ben5049/component-library/project_graphics/5-port-tsn-switch 1.0.0.png

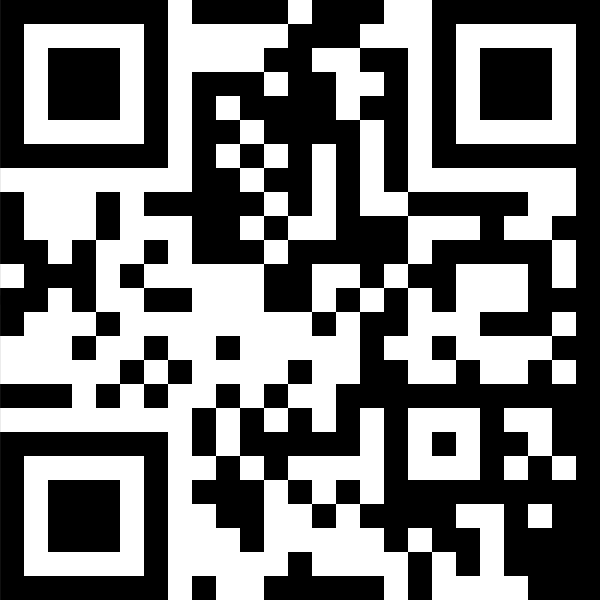
project_graphics/5-port-tsn-switch 1.0.0.png
