ben5049/component-library/project_graphics/admech.png

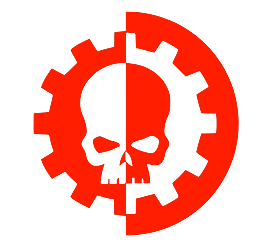
project_graphics/admech.png
