ben5049/component-library/project_graphics/red-scorpions.jpg

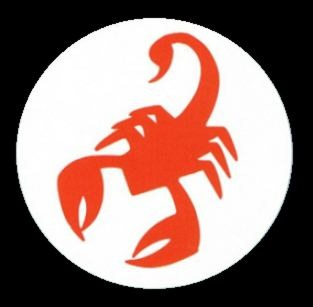
project_graphics/red-scorpions.jpg
