ben5049/component-library/project_models/f31l_8pin_asm.stp

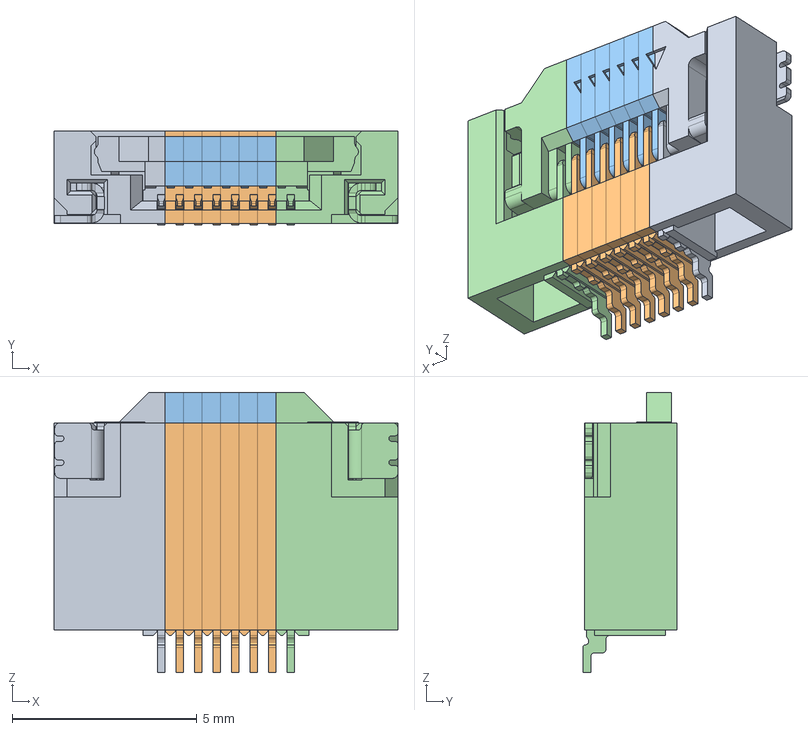
[picture p4: CAD file, 2026-02-13]
project_models/f31l_8pin_asm.stp
9.30 x 2.55 x 7.57 mm
F31L_L
F31L_M x 6
F31L_R
