ben5049/component-library/project_models/ASM330LH.stp

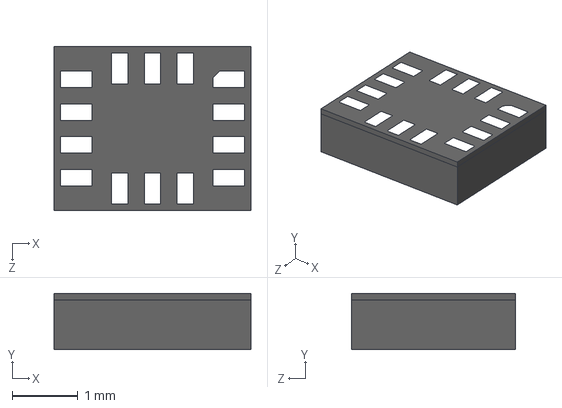
[picture p5: CAD file, 2025-05-21]
project_models/ASM330LH.stp
3.00 x 0.86 x 2.50 mm
