ben5049/component-library/project_models/switch-main-v2-bottom-shield-1.step

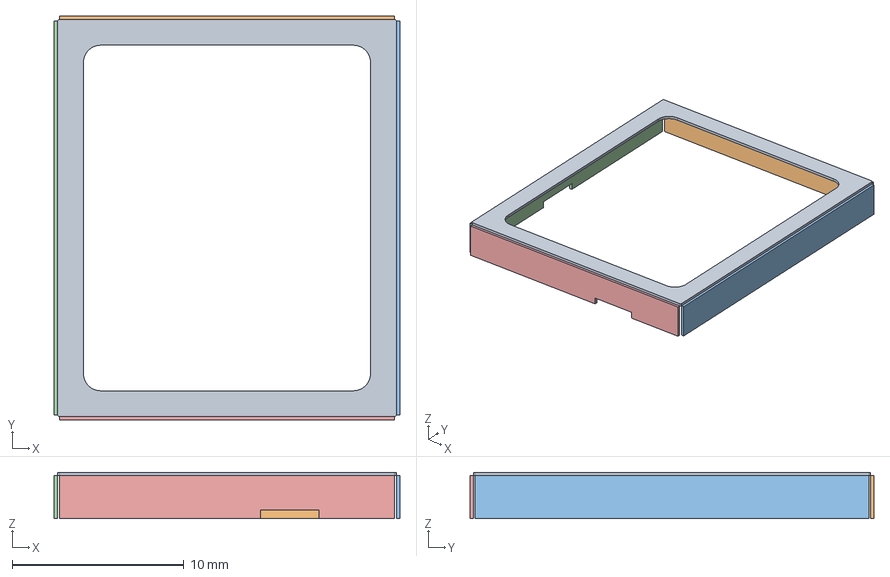
[picture p6: CAD file, 2025-05-05]
project_models/switch-main-v2-bottom-shield-1.step
20.1 x 23.5 x 2.70 mm
Frame
