ben5049/component-library/project_models/switch-main-v2-top-shield.step

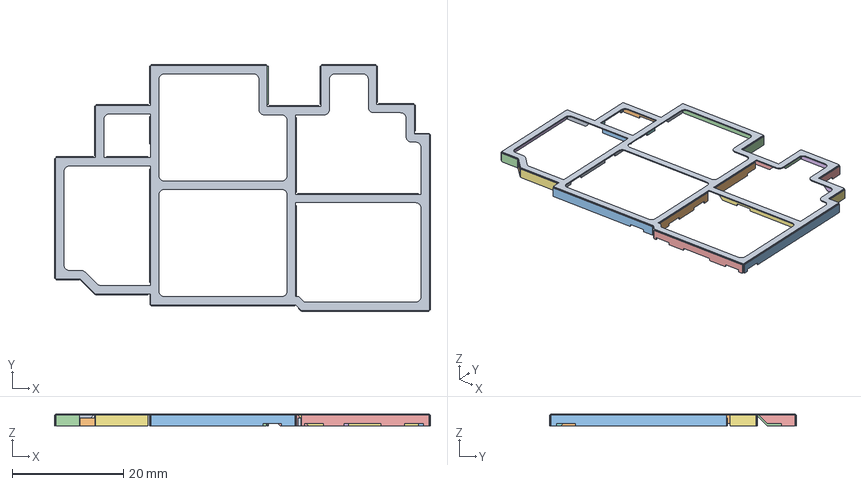
[picture p7: CAD file, 2025-05-05]
project_models/switch-main-v2-top-shield.step
67.7 x 44.5 x 2.20 mm
Frame
