ben5049/component-library/project_models/switch-main-v2-bottom-shield-2.step

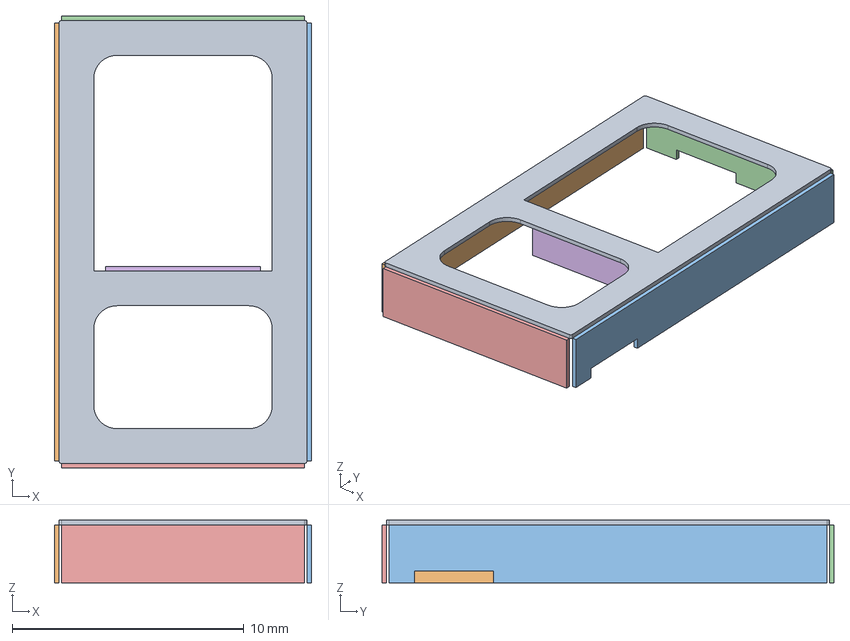
[picture p8: CAD file, 2025-05-05]
project_models/switch-main-v2-bottom-shield-2.step
11.1 x 19.5 x 2.70 mm
Frame
