ben5049/component-library/project_models/ADS7128IRTER.stp

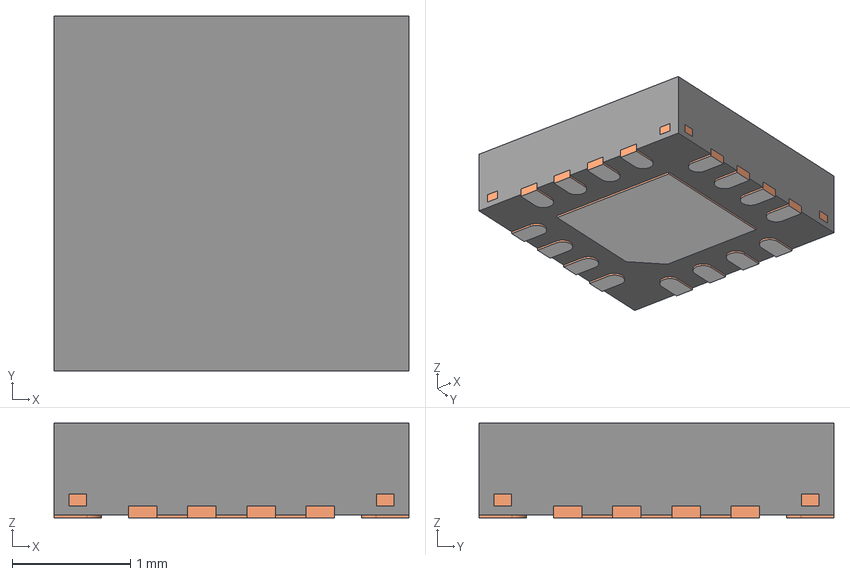
[picture p9: CAD file, 2026-04-12]
project_models/ADS7128IRTER.stp
3.00 x 3.00 x 0.8 mm
BODY-QFN
FRAME-RTE0016C
PIN1-ID
