ben5049/component-library/project_models/TMC2209.step

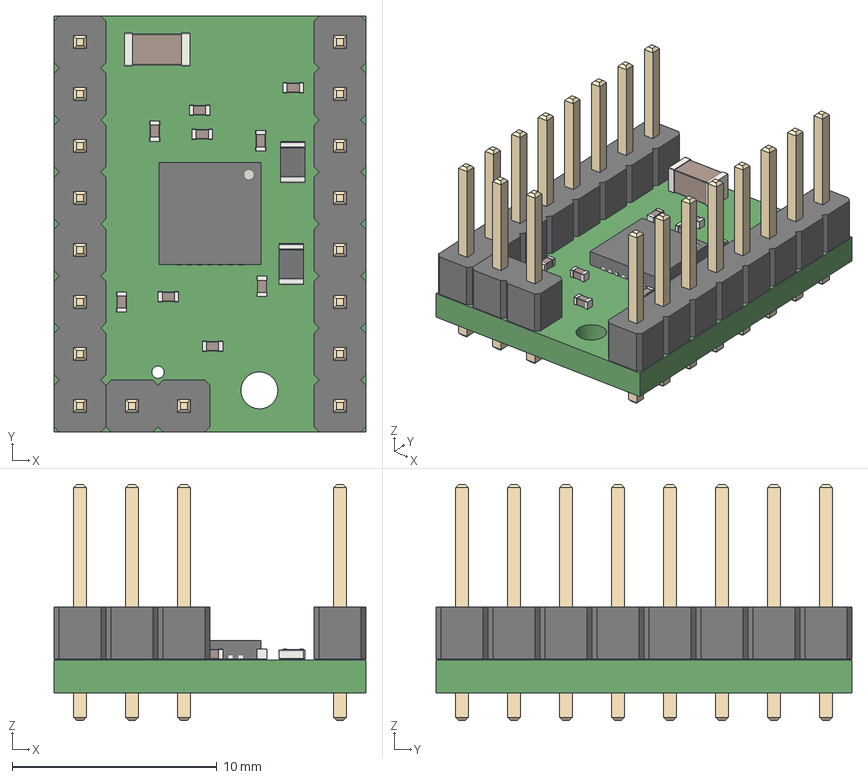
[picture p10: CAD file, 2026-04-09]
project_models/TMC2209.step
15.2 x 20.3 x 11.5 mm
