ben5049/component-library/project_models/FH12-20S-0.5SH_55_.stp

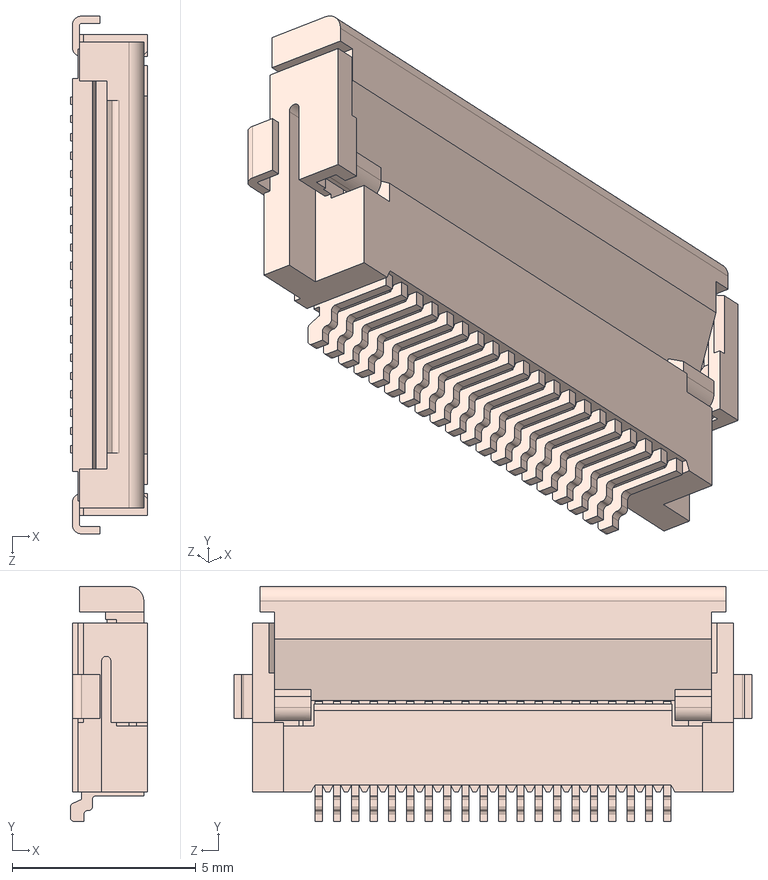
[picture p11: CAD file, 2026-04-07]
project_models/FH12-20S-0.5SH_55_.stp
2.10 x 6.40 x 14.1 mm
