ben5049/component-library/project_models/FFC3A20-05-G.stp

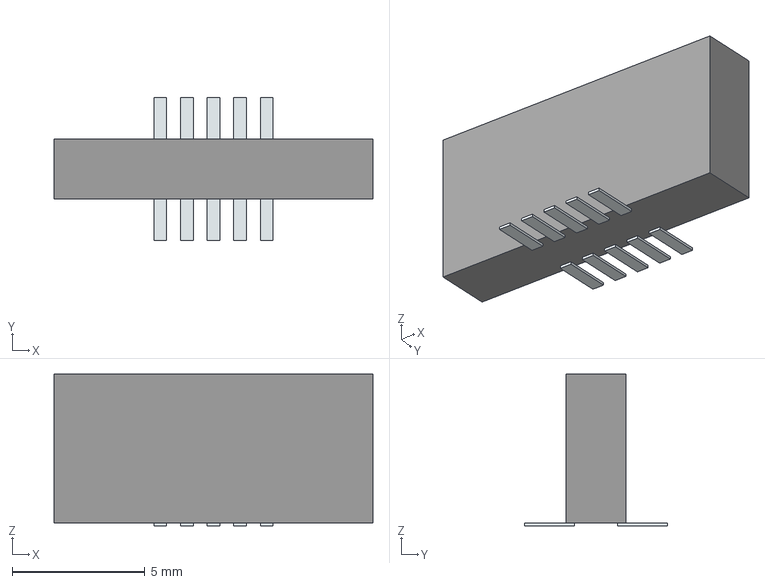
[picture p12: CAD file, 2026-04-06]
project_models/FFC3A20-05-G.stp
12.0 x 5.38 x 5.70 mm
Pins
