ben5049/component-library/project_models/NX3DV221GM,115.stp

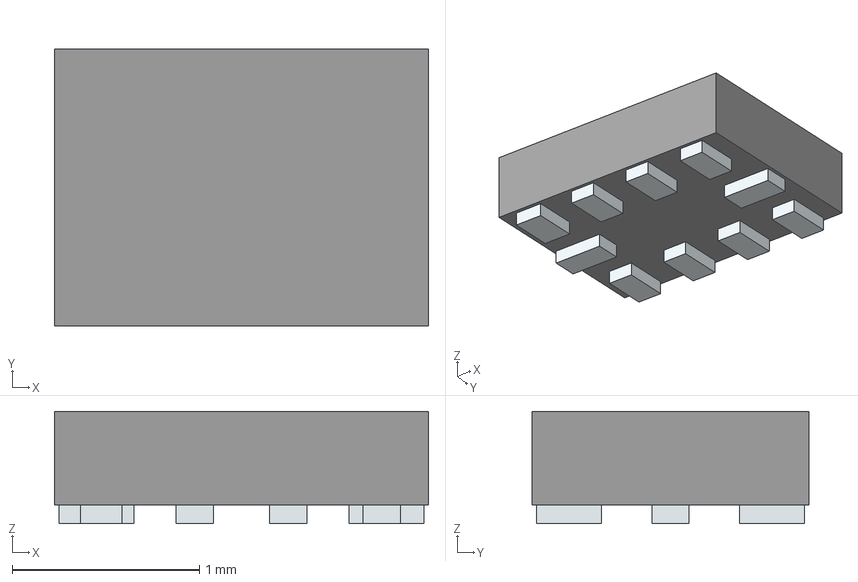
[picture p13: CAD file, 2026-04-06]
project_models/NX3DV221GM,115.stp
2.00 x 1.48 x 0.6 mm
Pins
