ben5049/component-library/project_models/AT24C64D-MAHM-E.stp

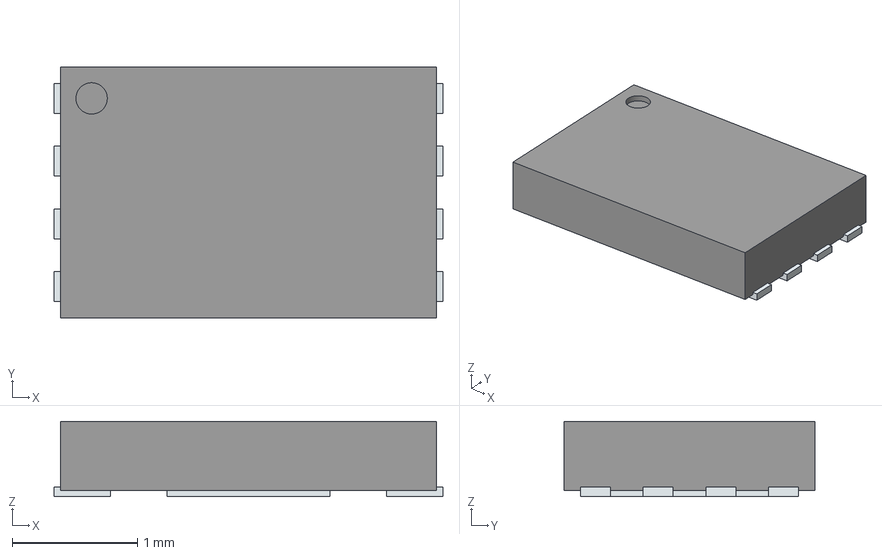
[picture p14: CAD file, 2026-04-06]
project_models/AT24C64D-MAHM-E.stp
3.10 x 2.00 x 0.6 mm
ThermalPin
PinsArrayLR
