ben5049/component-library/project_models/L_Wurth_WE-LHMI-5030.step

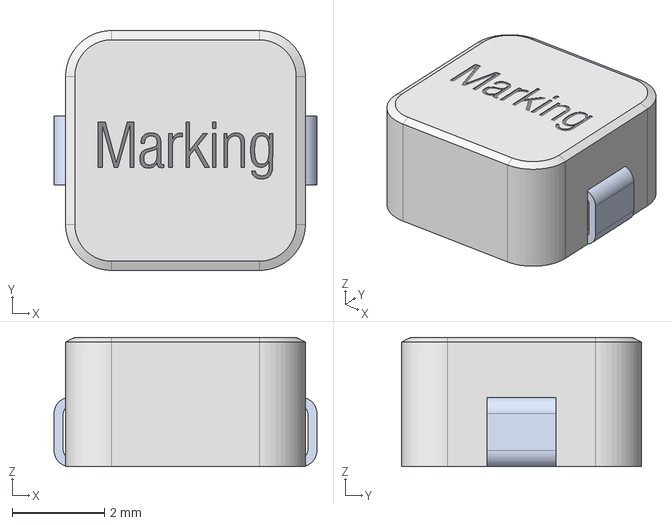
[picture p15: CAD file, 2026-04-05]
project_models/L_Wurth_WE-LHMI-5030.step
5.70 x 5.20 x 2.80 mm
