ben5049/component-library/project_models/L_Wurth_WE-LHMI-1335.step

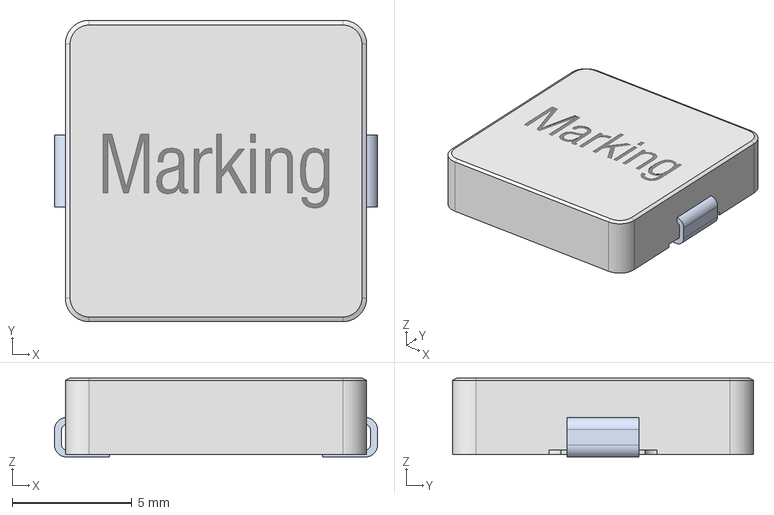
[picture p16: CAD file, 2026-04-05]
project_models/L_Wurth_WE-LHMI-1335.step
13.5 x 12.6 x 3.30 mm
