ben5049/component-library/project_models/L_Wurth_WE-LHMI-1365.step

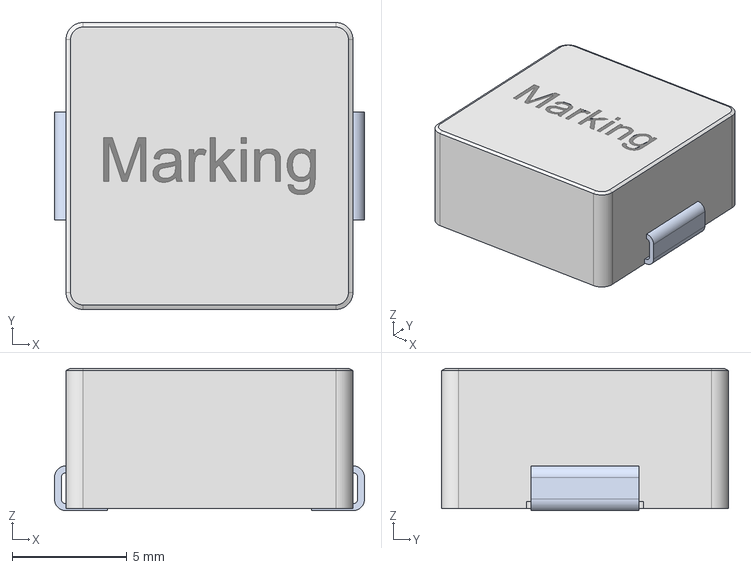
[picture p17: CAD file, 2026-04-05]
project_models/L_Wurth_WE-LHMI-1365.step
13.5 x 12.5 x 6.20 mm
