ben5049/component-library/project_models/L_Wurth_WE-LHMI-4020HT.step

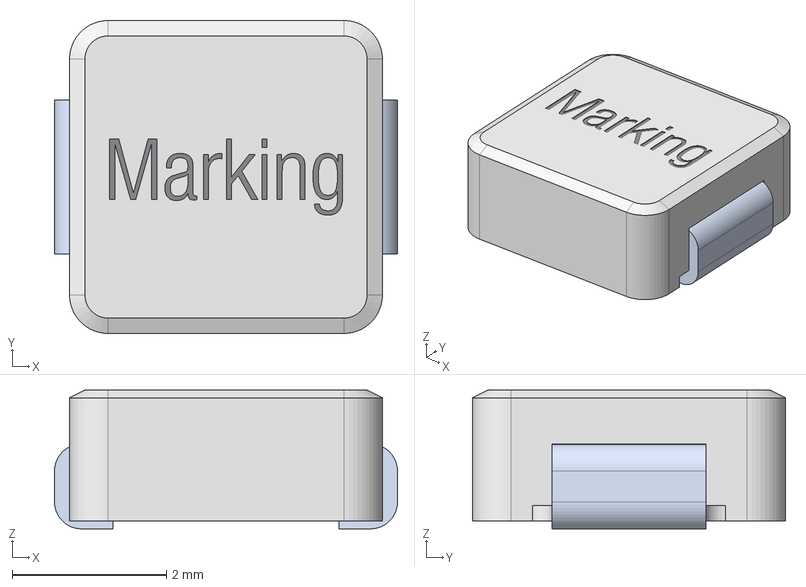
[picture p18: CAD file, 2026-04-05]
project_models/L_Wurth_WE-LHMI-4020HT.step
4.45 x 4.06 x 1.80 mm
