ben5049/component-library/project_models/L_Wurth_WE-LHMI-7050.step

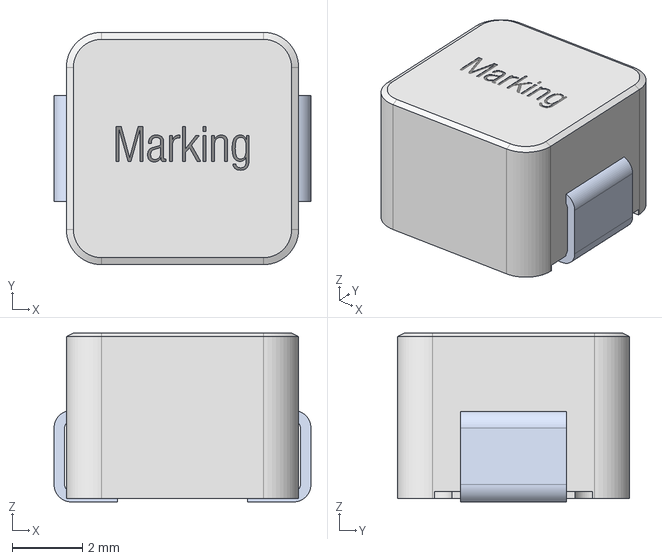
[picture p19: CAD file, 2026-04-05]
project_models/L_Wurth_WE-LHMI-7050.step
7.30 x 6.60 x 4.80 mm
