ben5049/component-library/project_models/L_Wurth_WE-LHMI-7030HT.step

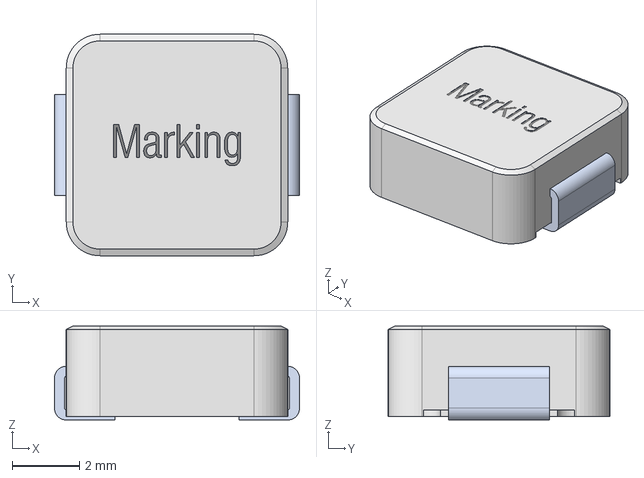
[picture p20: CAD file, 2026-04-05]
project_models/L_Wurth_WE-LHMI-7030HT.step
7.30 x 6.60 x 2.80 mm
