ben5049/component-library/project_models/L_Wurth_WE-LHMI-4012.step

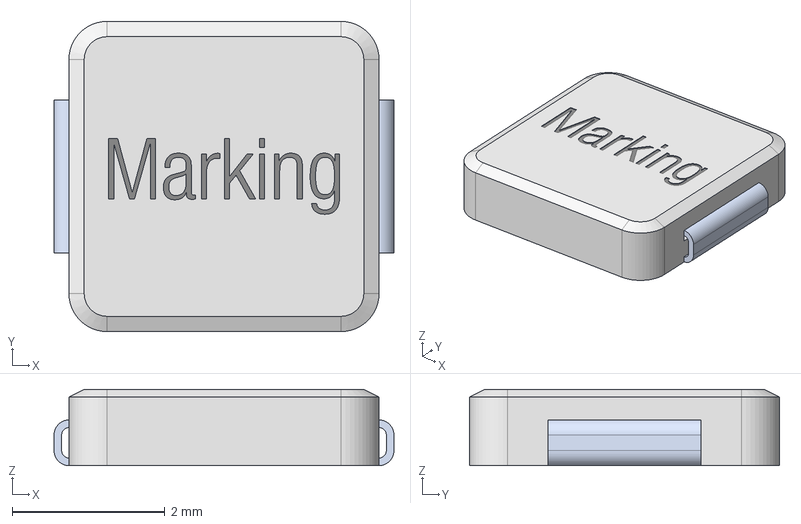
[picture p21: CAD file, 2026-04-05]
project_models/L_Wurth_WE-LHMI-4012.step
4.45 x 4.06 x 1.00 mm
