ben5049/component-library/project_models/AZV3001FZ4-7.stp

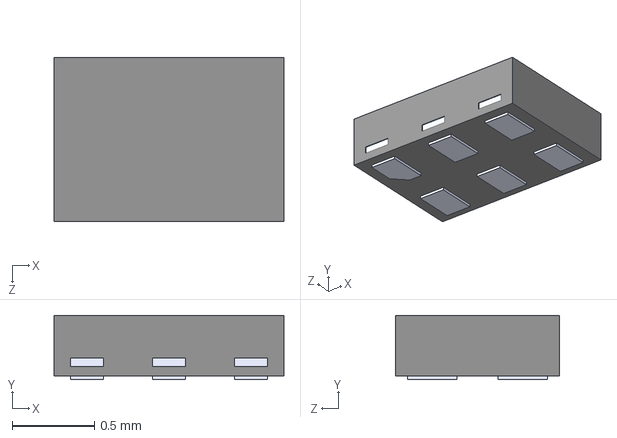
[picture p22: CAD file, 2026-04-05]
project_models/AZV3001FZ4-7.stp
1.40 x 0.39 x 1.00 mm
