ben5049/component-library/project_models/L_Wurth_WE-LHMI-8030.step

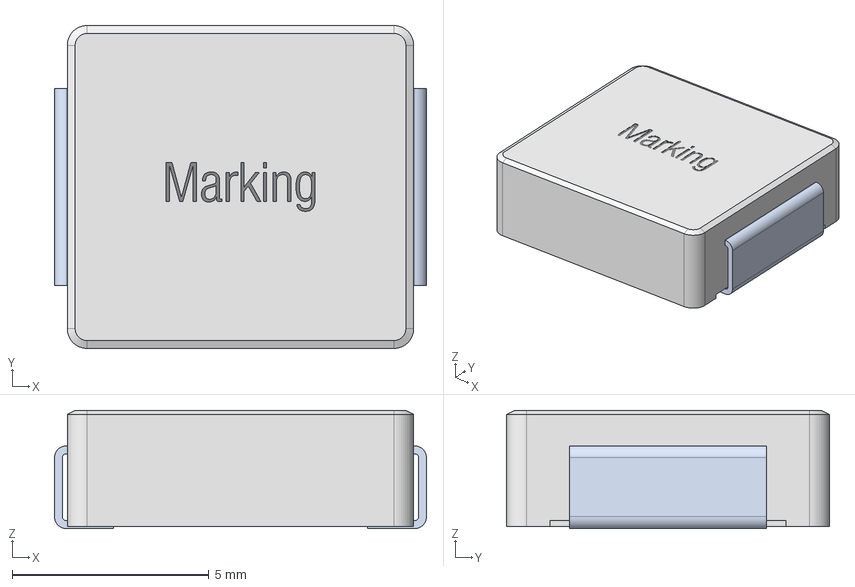
[picture p23: CAD file, 2026-04-05]
project_models/L_Wurth_WE-LHMI-8030.step
9.45 x 8.20 x 3.00 mm
