ben5049/component-library/project_models/L_Wurth_WE-LHMI-1040.step

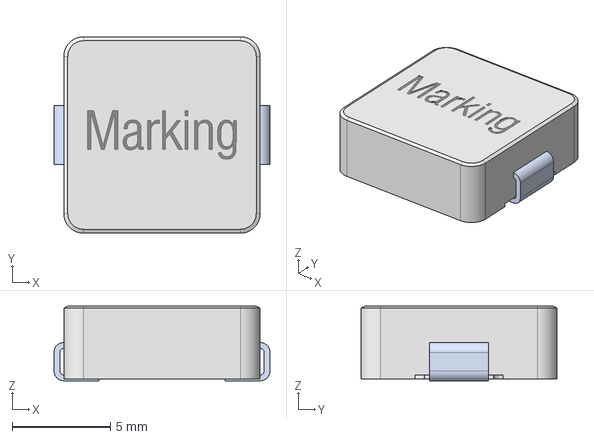
[picture p24: CAD file, 2026-04-05]
project_models/L_Wurth_WE-LHMI-1040.step
11.0 x 10.0 x 3.80 mm
