ben5049/component-library/project_models/L_Wurth_WE-LHMI-5020HT.step

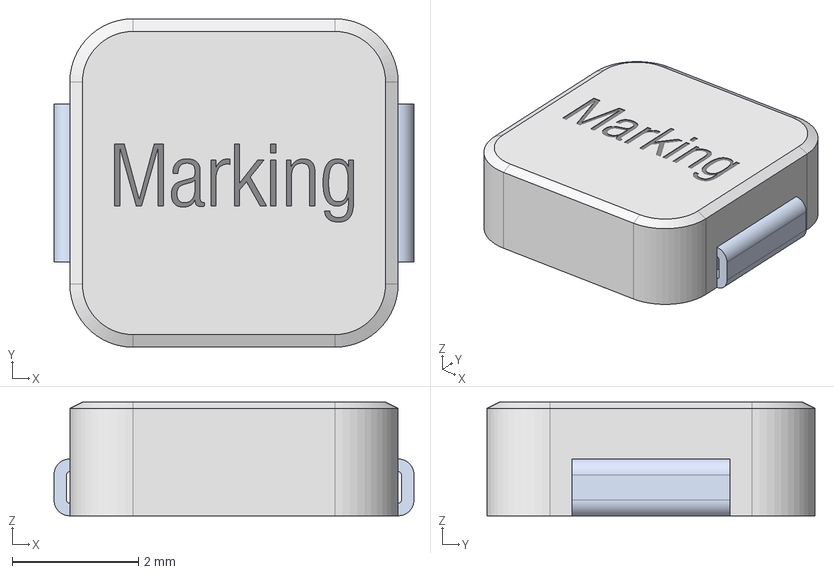
[picture p25: CAD file, 2026-04-05]
project_models/L_Wurth_WE-LHMI-5020HT.step
5.70 x 5.20 x 1.80 mm
