ben5049/component-library/project_models/L_Wurth_WE-LHMI-8040_PW5.step

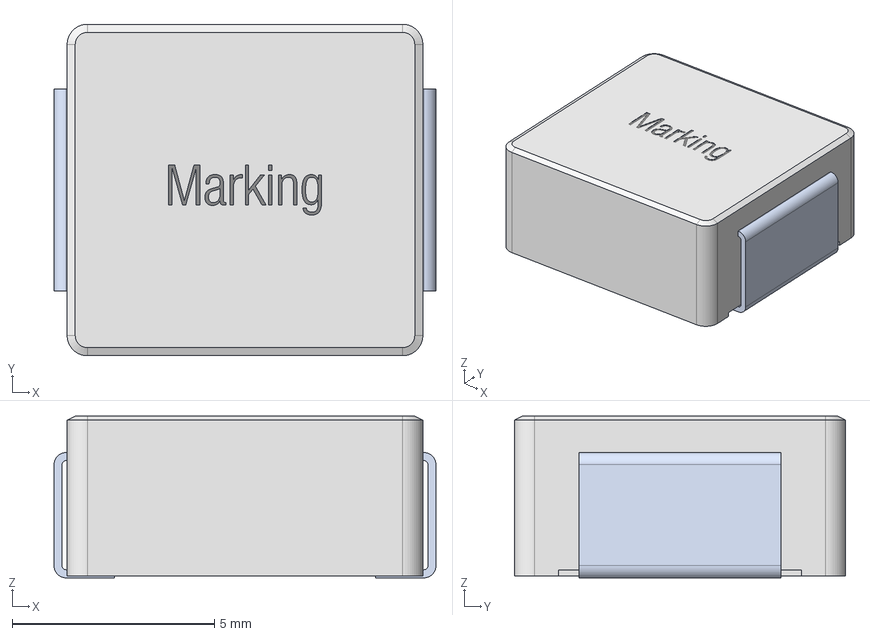
[picture p26: CAD file, 2026-04-05]
project_models/L_Wurth_WE-LHMI-8040_PW5.step
9.45 x 8.20 x 4.00 mm
