ben5049/component-library/project_models/LSF0108ZBA20-13.stp

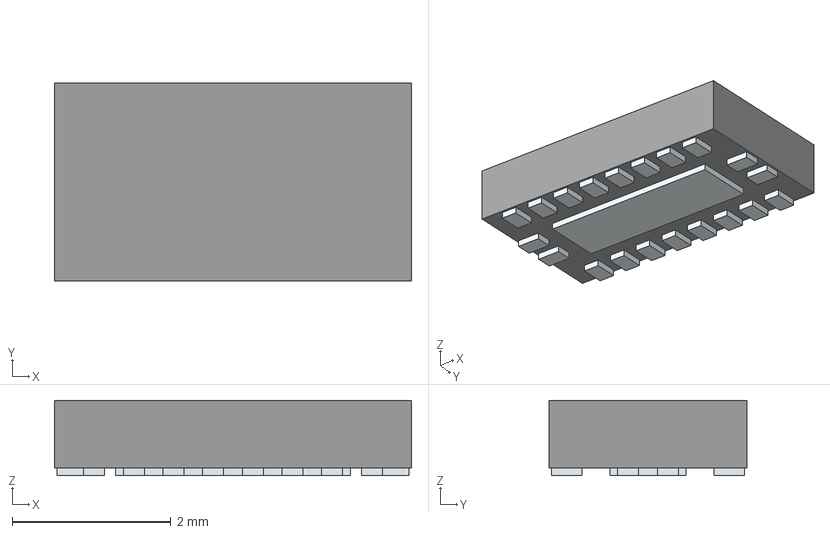
[picture p27: CAD file, 2026-04-03]
project_models/LSF0108ZBA20-13.stp
4.50 x 2.50 x 0.95 mm
Pins
