ben5049/component-library/project_models/TXS0108ERGYR.stp

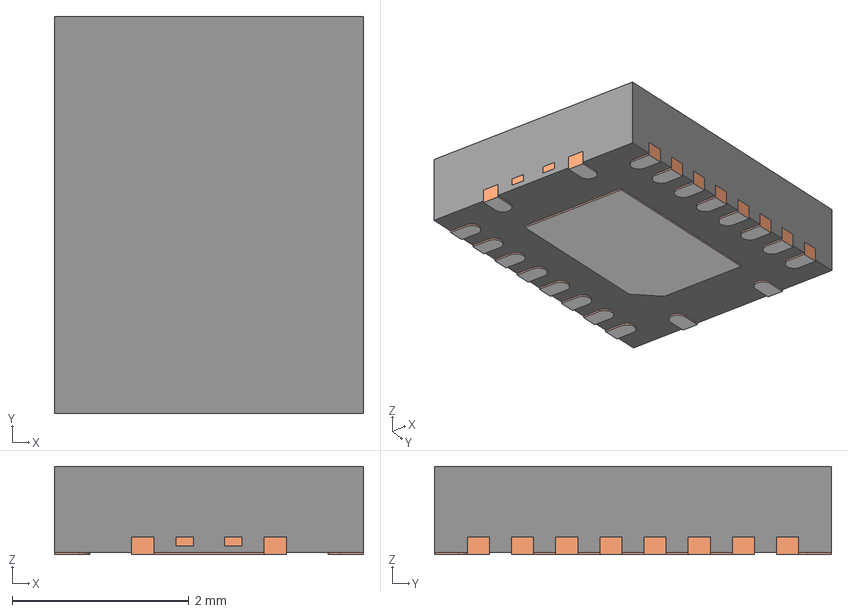
[picture p28: CAD file, 2026-04-03]
project_models/TXS0108ERGYR.stp
3.50 x 4.50 x 1.00 mm
BODY-QFN
FRAME-RGY0020A
PIN1-ID
