ben5049/component-library/project_models/MIC826MYMT-TR.stp

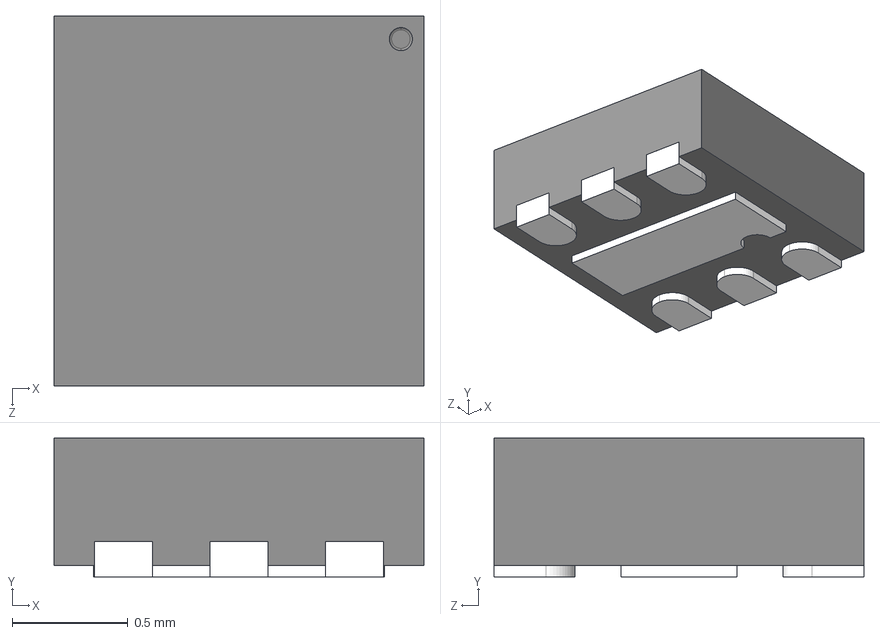
[picture p29: CAD file, 2026-04-03]
project_models/MIC826MYMT-TR.stp
1.60 x 0.6 x 1.60 mm
MIC94325YMT-TR
MIC94325YMT-TR_3
MIC94325YMT-TR_8
MIC94325YMT-TR_5
MIC94325YMT-TR_7
MIC94325YMT-TR_1
MIC94325YMT-TR_6
MIC94325YMT-TR_4
