ben5049/component-library/project_models/JST-XH6-SMD.step

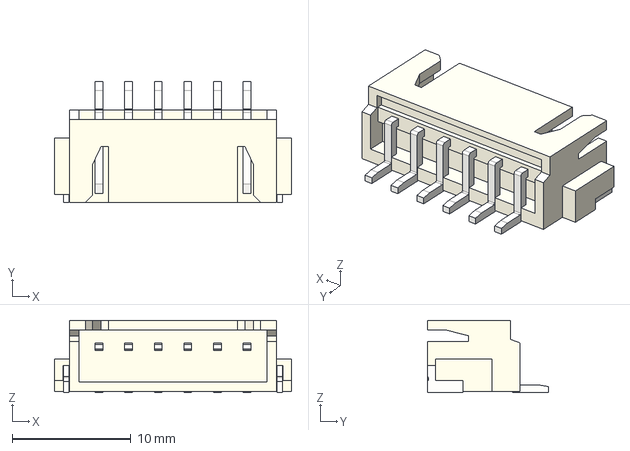
[picture p30: CAD file, 2026-03-31]
project_models/JST-XH6-SMD.step
20.0 x 10.2 x 6.10 mm
