ben5049/component-library/project_models/JST-XH4-SMD.step

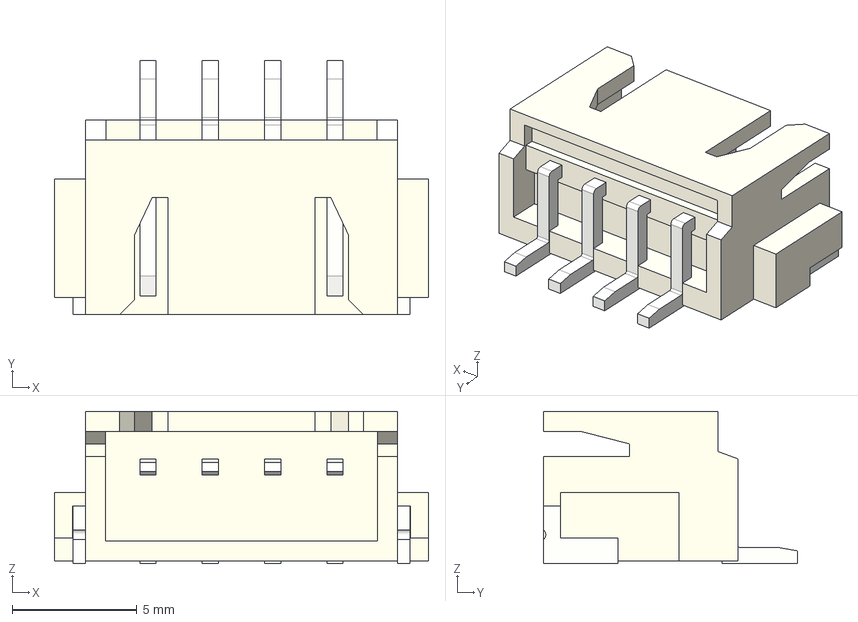
[picture p31: CAD file, 2026-03-31]
project_models/JST-XH4-SMD.step
15.0 x 10.2 x 6.10 mm
