ben5049/component-library/project_models/JST-XH7-SMD.step

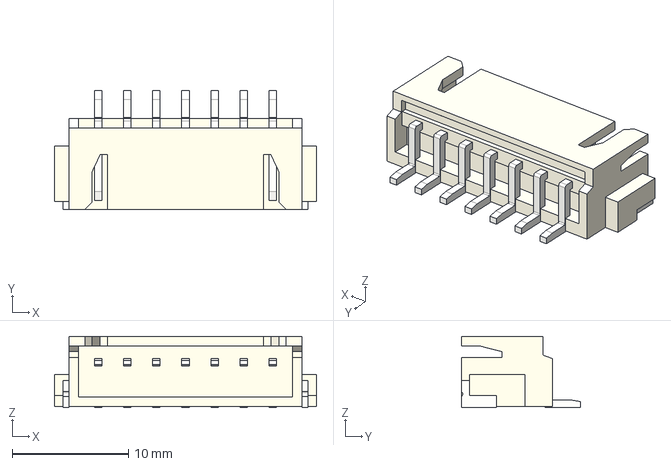
[picture p32: CAD file, 2026-03-31]
project_models/JST-XH7-SMD.step
22.5 x 10.2 x 6.10 mm
