ben5049/component-library/project_models/JST-XH3-SMD.step

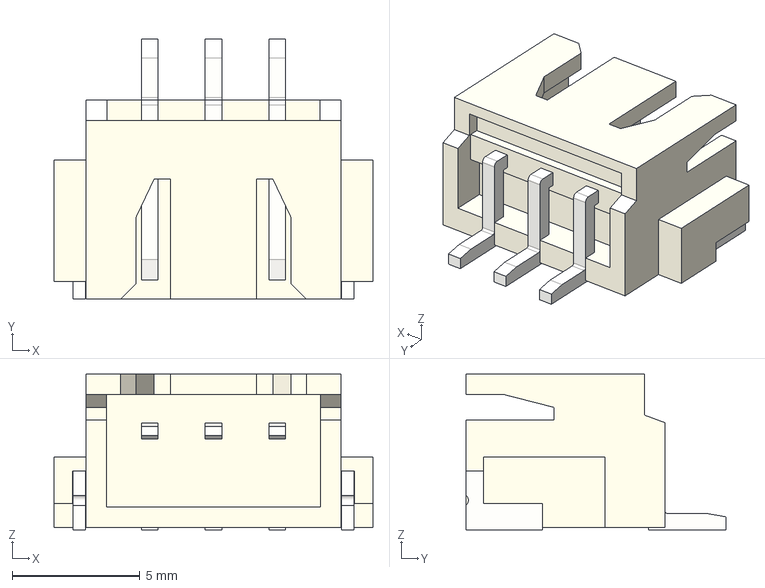
[picture p33: CAD file, 2026-03-31]
project_models/JST-XH3-SMD.step
12.5 x 10.2 x 6.10 mm
