ben5049/component-library/project_models/JST-XH2-SMD.step

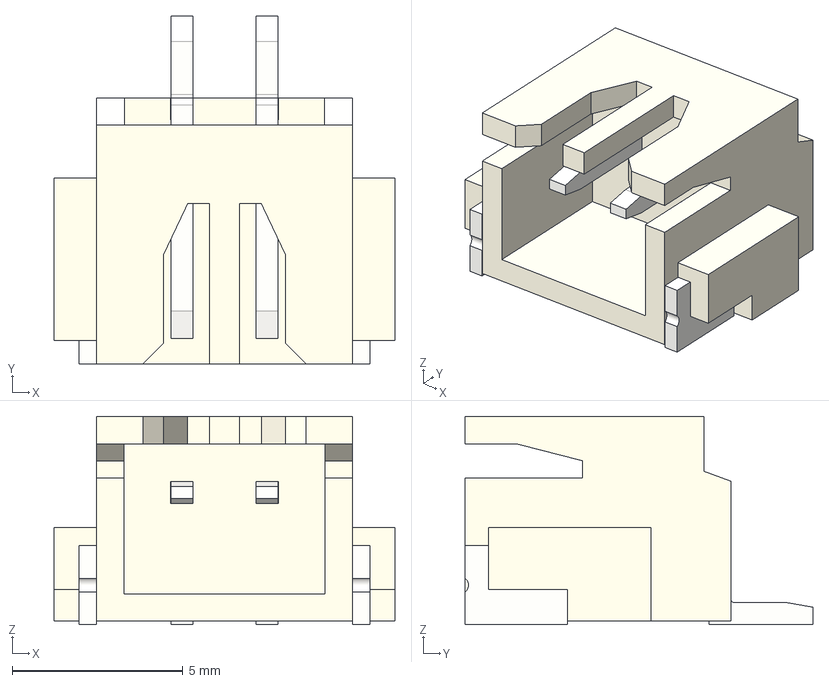
[picture p34: CAD file, 2026-03-31]
project_models/JST-XH2-SMD.step
10.0 x 10.2 x 6.10 mm
