ben5049/component-library/project_models/JST-XH5-SMD.step

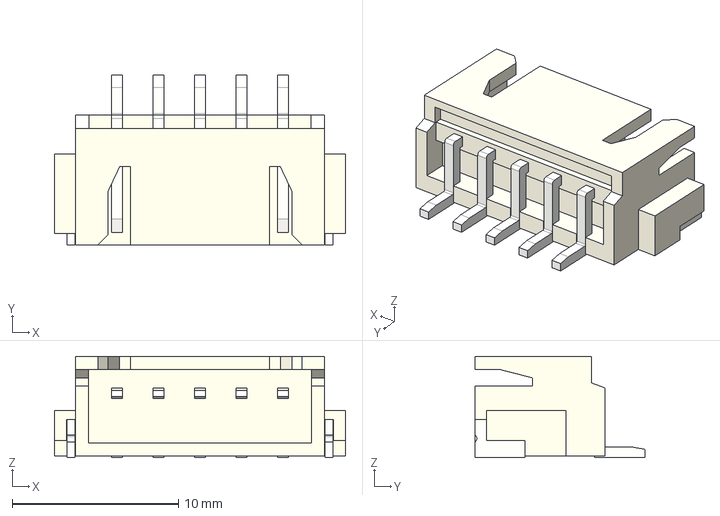
[picture p35: CAD file, 2026-03-31]
project_models/JST-XH5-SMD.step
17.5 x 10.2 x 6.10 mm
