ben5049/component-library/project_models/JST_PH_S2B-PH-K_1x02_P2.00mm_Horizontal.step

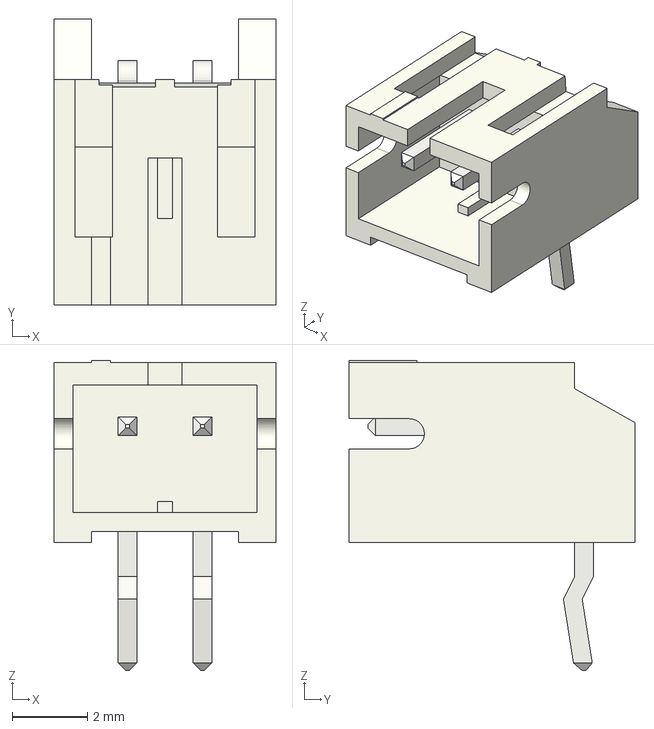
[picture p36: CAD file, 2026-02-17]
project_models/JST_PH_S2B-PH-K_1x02_P2.00mm_Horizontal.step
5.90 x 7.60 x 8.25 mm
