ben5049/component-library/project_models/NORA-B106-00B.stp

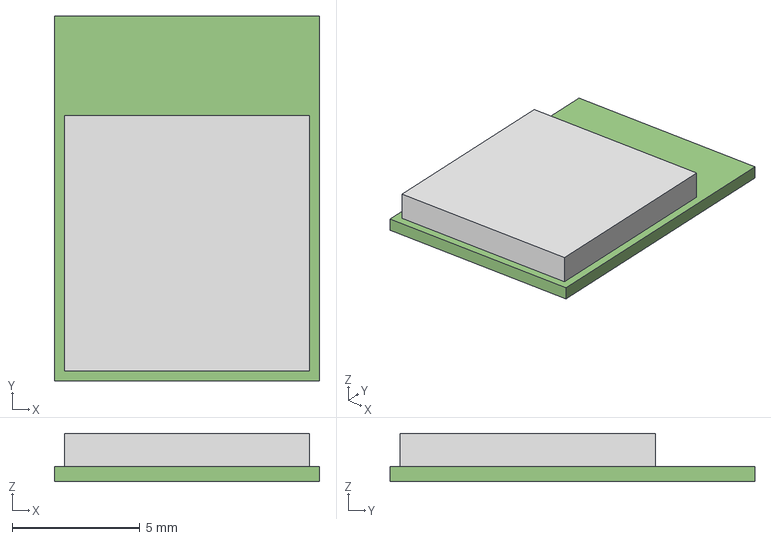
[picture p37: CAD file, 2026-02-16]
project_models/NORA-B106-00B.stp
10.4 x 14.3 x 1.90 mm
board
can
