ben5049/component-library/project_models/NCP380HMU05AATBG.stp

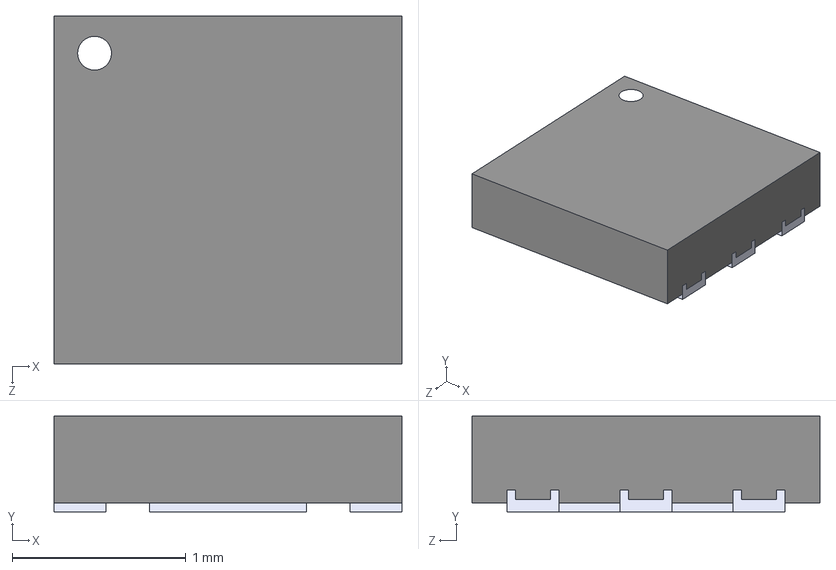
[picture p38: CAD file, 2026-02-16]
project_models/NCP380HMU05AATBG.stp
2.00 x 0.55 x 2.00 mm
