ben5049/component-library/project_models/NINA-B306-00B.stp

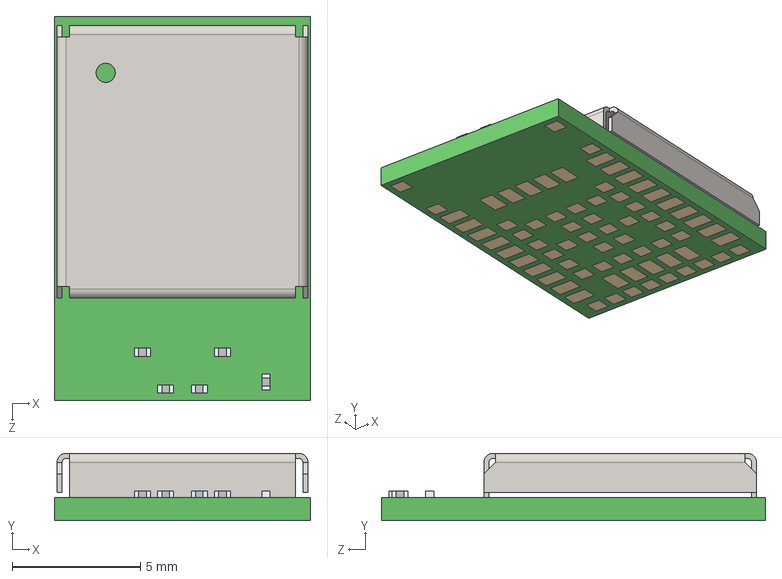
[picture p39: CAD file, 2026-02-16]
project_models/NINA-B306-00B.stp
10.0 x 2.63 x 15.0 mm
