ben5049/component-library/project_models/NINA-B302-00B.stp

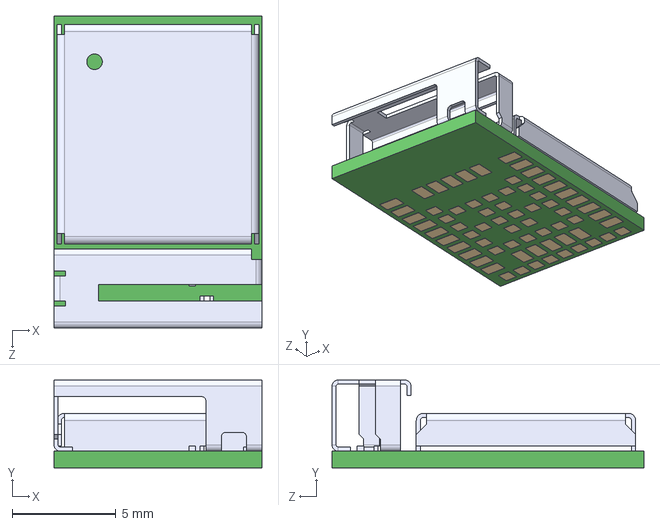
[picture p40: CAD file, 2026-02-16]
project_models/NINA-B302-00B.stp
10.0 x 4.23 x 15.0 mm
