ben5049/component-library/project_models/TMC6300-LA.stp

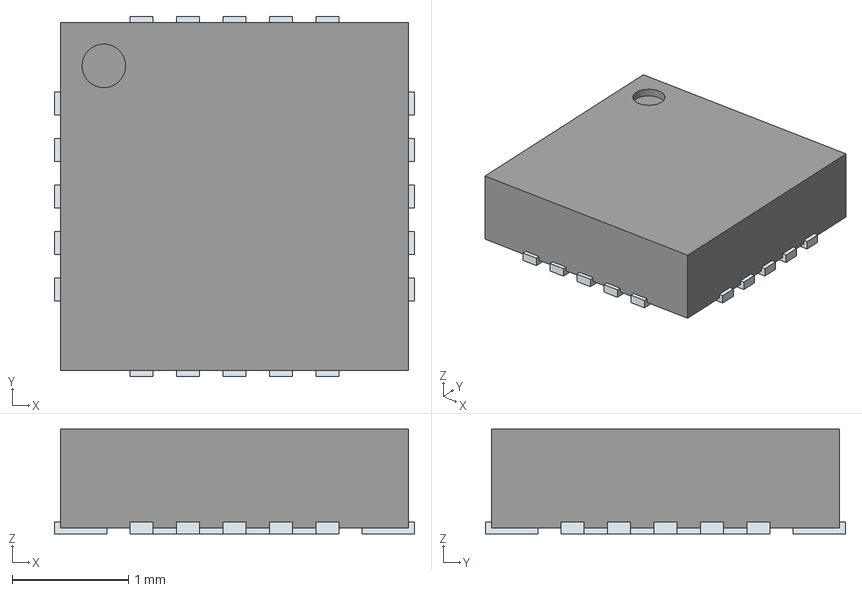
[picture p41: CAD file, 2026-02-13]
project_models/TMC6300-LA.stp
3.10 x 3.10 x 0.9 mm
ThermalPin
PinsArrayLR
PinsArrayTB
