ben5049/component-library/project_models/F31Z_8pin.stp

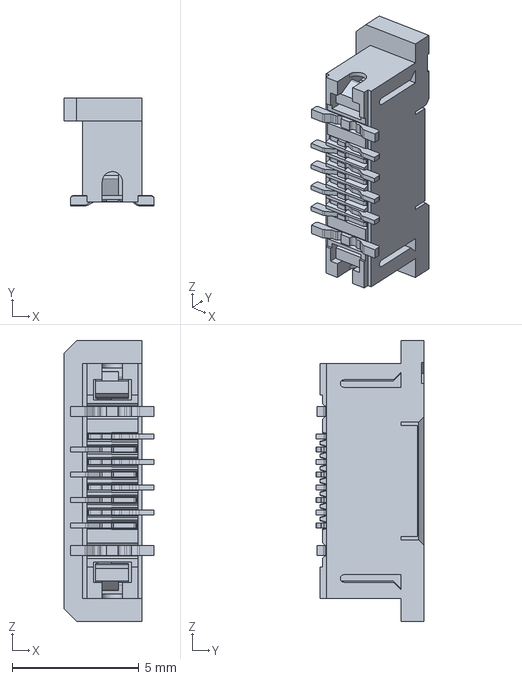
[picture p42: CAD file, 2026-02-11]
project_models/F31Z_8pin.stp
3.56 x 4.25 x 11.1 mm
