ben5049/component-library/project_models/EMIF06-MSD02N16.stp

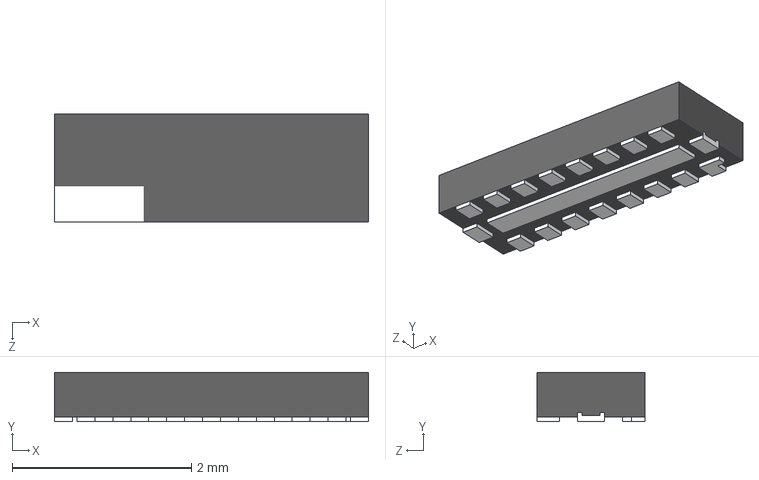
[picture p43: CAD file, 2026-02-11]
project_models/EMIF06-MSD02N16.stp
3.50 x 0.55 x 1.20 mm
