ben5049/component-library/project_models/MSD-1-A.stp

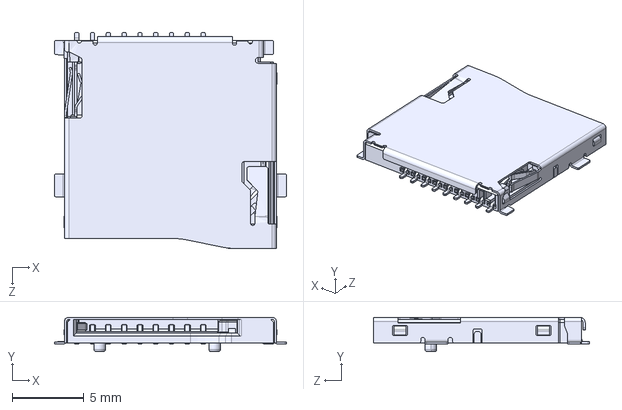
[picture p44: CAD file, 2026-02-10]
project_models/MSD-1-A.stp
16.1 x 2.40 x 15.0 mm
