ben5049/component-library/project_models/GSB12J21C1EU.step

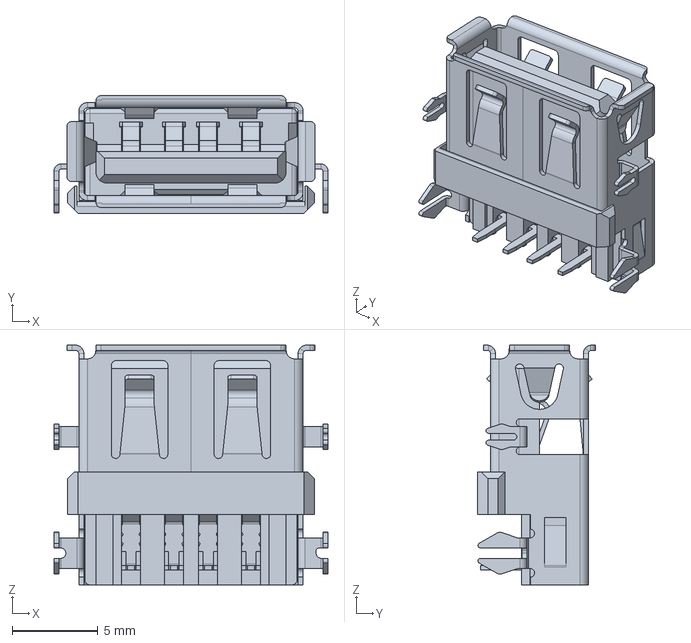
[picture p45: CAD file, 2026-02-10]
project_models/GSB12J21C1EU.step
16.0 x 6.88 x 14.0 mm
