ben5049/component-library/project_models/USB4510-03-1-A.stp

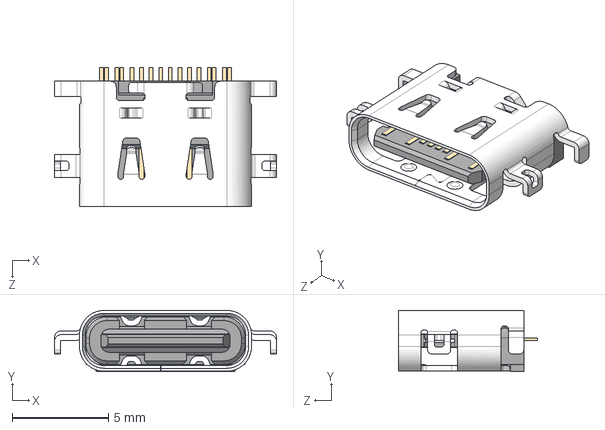
[picture p46: CAD file, 2026-02-10]
project_models/USB4510-03-1-A.stp
11.5 x 3.18 x 7.20 mm
