ben5049/component-library/project_models/kailh-choc-black.step

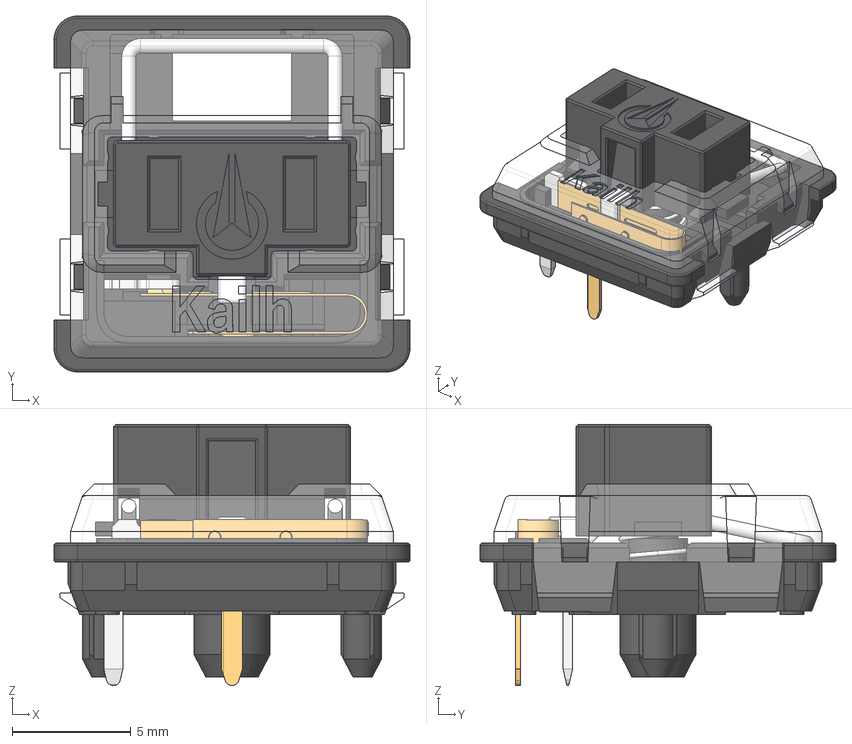
[picture p47: CAD file, 2026-02-08]
project_models/kailh-choc-black.step
15.0 x 15.0 x 11.0 mm
bottom_stabilizer
contact
pin1
pin2
top_stabilizer
stabilizer
stem_stabilizer
shrunken_spring
