ben5049/component-library/project_models/2206-100T.step

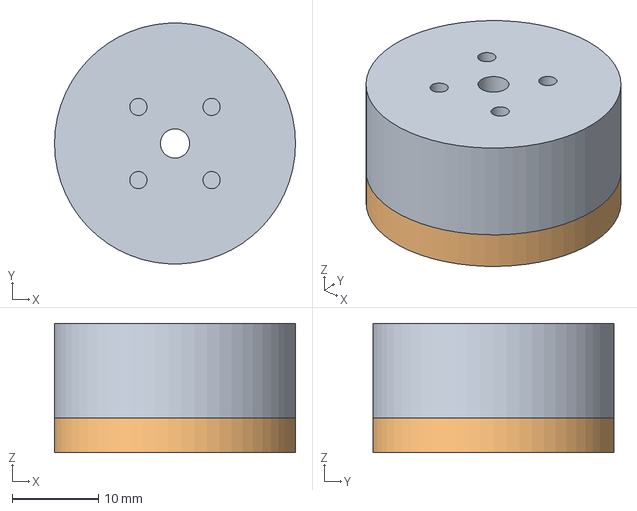
[picture p48: CAD file, 2026-02-08]
project_models/2206-100T.step
28.0 x 28.0 x 15.0 mm
Rotor
Stator
