ben5049/component-library/project_models/kailh-choc-socket.step

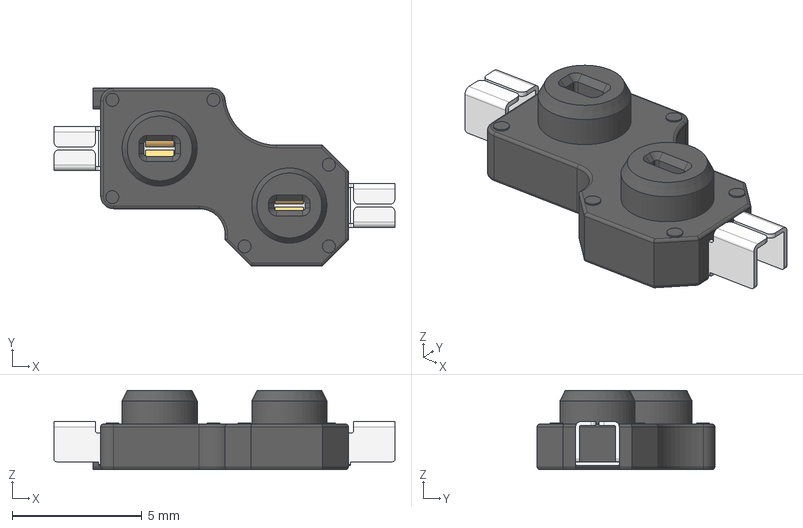
[picture p49: CAD file, 2026-02-08]
project_models/kailh-choc-socket.step
13.1 x 6.85 x 3.05 mm
choc_body
contact_a1
contact_a2
contact_b
contact_a003
contact_a004
contact_b001
