ben5049/component-library/project_models/sk6812mini-e.step

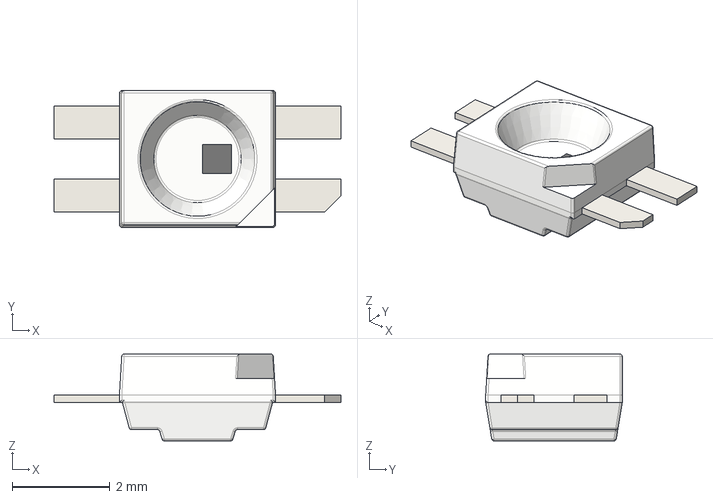
[picture p50: CAD file, 2026-02-08]
project_models/sk6812mini-e.step
5.88 x 2.80 x 1.78 mm
