ben5049/component-library/project_models/FH12-22S-0.5SH.stp

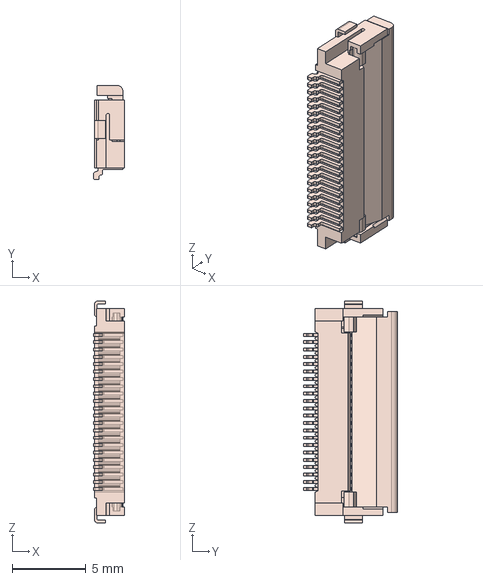
[picture p51: CAD file, 2026-01-16]
project_models/FH12-22S-0.5SH.stp
2.10 x 6.40 x 15.1 mm
