ben5049/component-library/project_models/DMN3021LFDF-7.stp

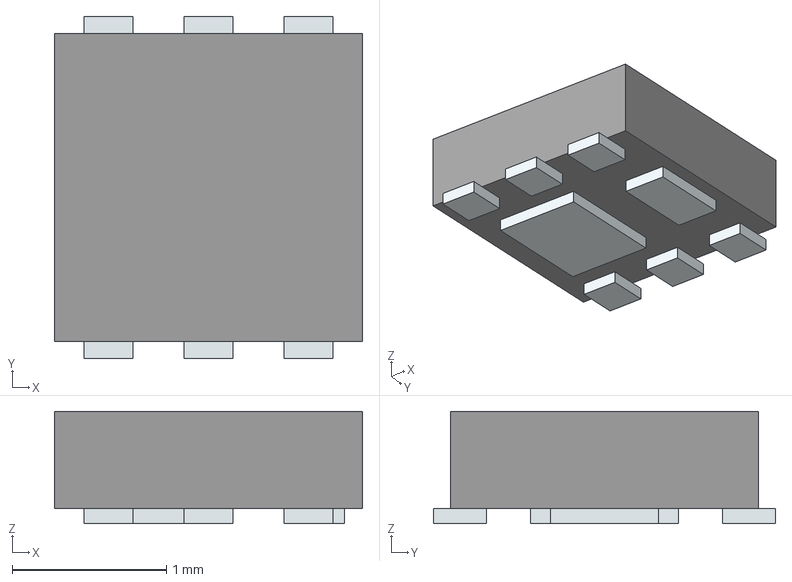
[picture p52: CAD file, 2026-01-13]
project_models/DMN3021LFDF-7.stp
2.00 x 2.22 x 0.73 mm
Pins
