ben5049/component-library/project_models/DMN2005UFG-7.stp

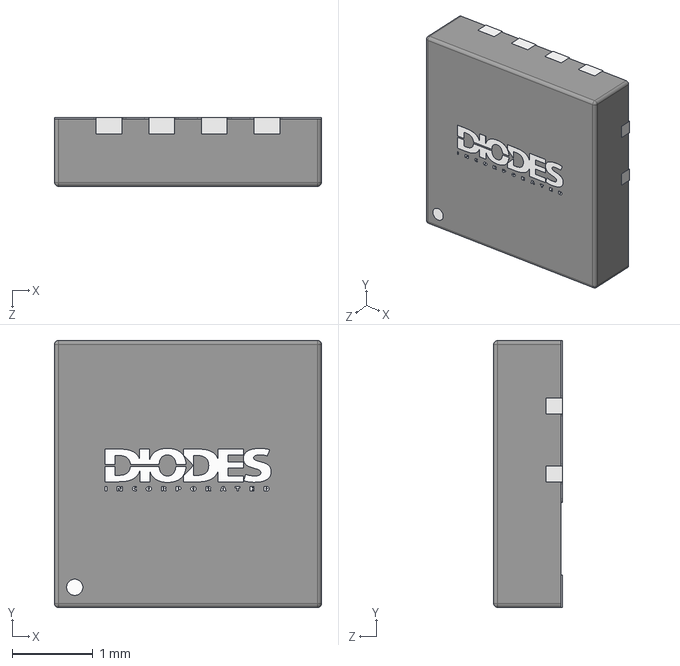
[picture p53: CAD file, 2026-01-12]
project_models/DMN2005UFG-7.stp
3.30 x 3.30 x 0.851 mm
DMP6023LFGQ-7
Diodes_Logo
