ben5049/component-library/project_models/INA381A2IDSGR.stp

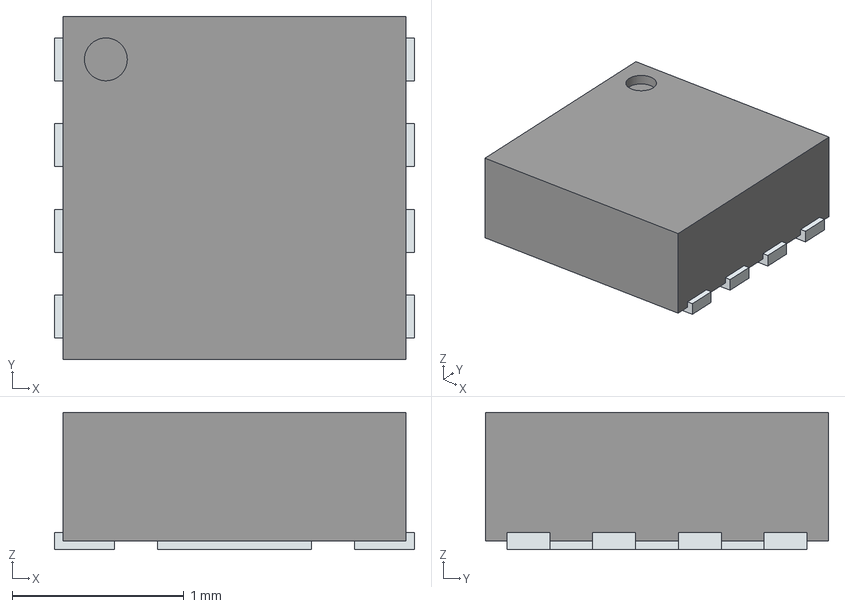
[picture p54: CAD file, 2026-01-12]
project_models/INA381A2IDSGR.stp
2.10 x 2.00 x 0.8 mm
ThermalPin
PinsArrayLR
