ben5049/component-library/project_models/BM04B-SRSS-TB.STEP

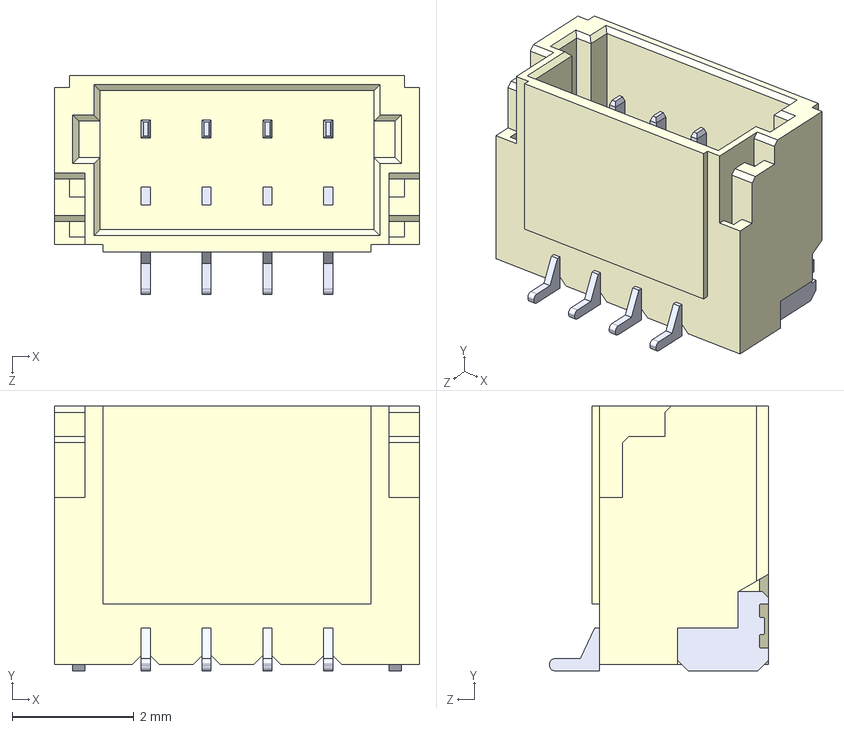
[picture p55: CAD file, 2026-01-04]
project_models/BM04B-SRSS-TB.STEP
6.00 x 4.35 x 3.60 mm
