ben5049/component-library/project_models/NX3DV221TKX.stp

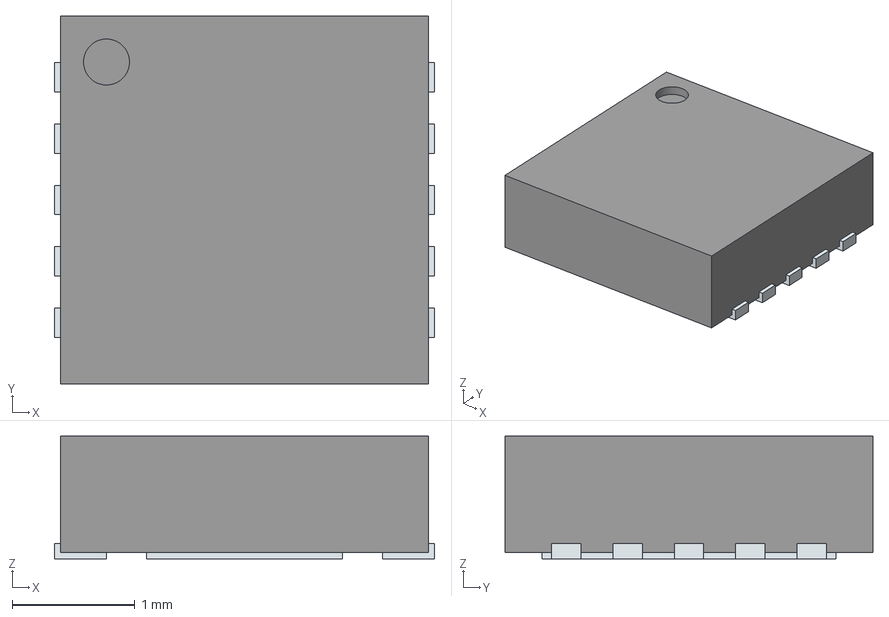
[picture p56: CAD file, 2026-01-04]
project_models/NX3DV221TKX.stp
3.10 x 3.00 x 1.00 mm
ThermalPin
PinsArrayLR
