ben5049/component-library/project_models/PCM12SMTBR.stp

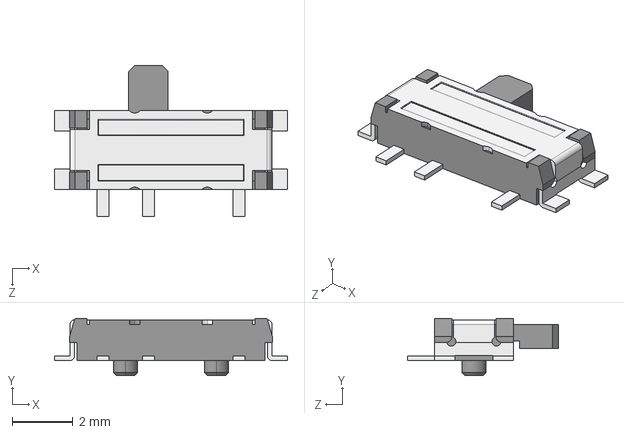
[picture p57: CAD file, 2026-01-04]
project_models/PCM12SMTBR.stp
7.70 x 1.90 x 5.00 mm
