ben5049/component-library/project_models/FG-ST-C-24P-CL03-14.3.stp

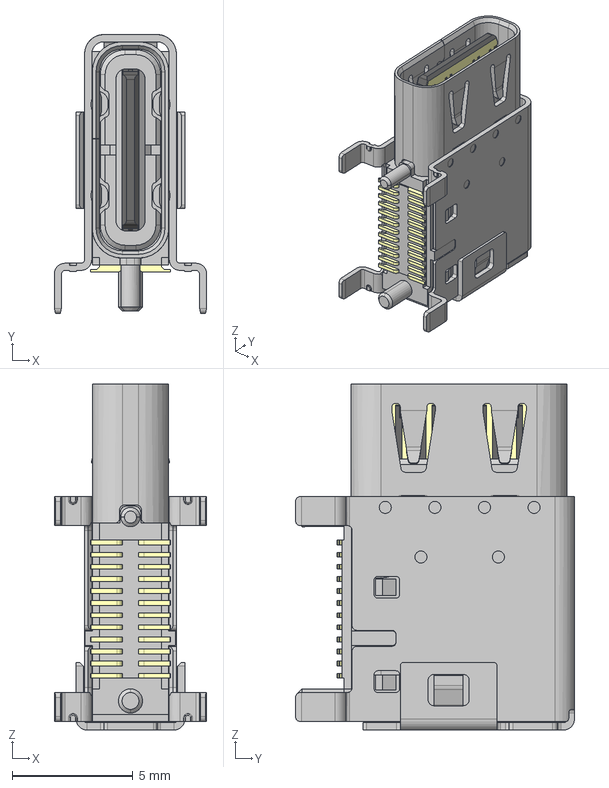
[picture p58: CAD file, 2026-01-04]
project_models/FG-ST-C-24P-CL03-14.3.stp
6.30 x 11.5 x 14.3 mm
