ben5049/component-library/project_models/USB1100-30-A.stp

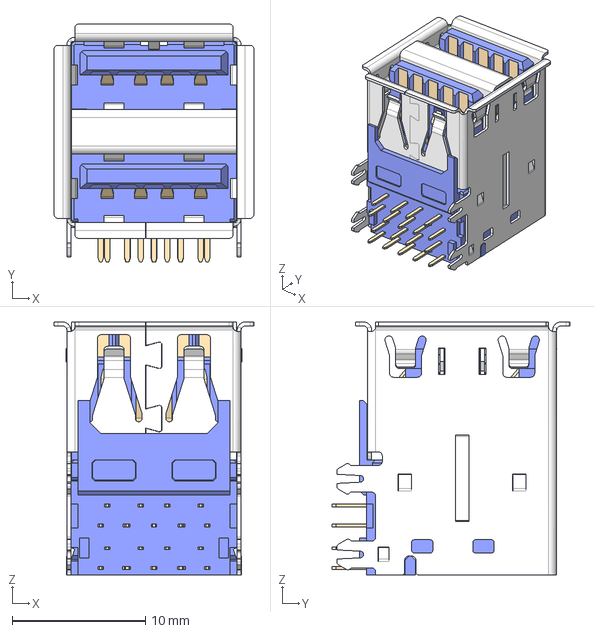
[picture p59: CAD file, 2026-01-04]
project_models/USB1100-30-A.stp
15.0 x 17.9 x 19.0 mm
