ben5049/component-library/project_models/MDT580E0X002_c3d.stp

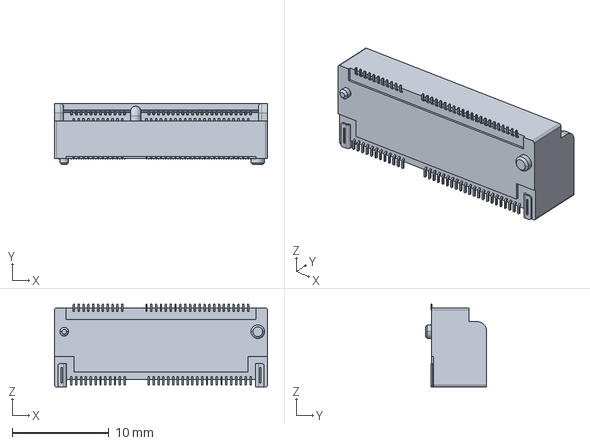
[picture p60: CAD file, 2026-01-04]
project_models/MDT580E0X002_c3d.stp
22.0 x 6.35 x 8.55 mm
