ben5049/component-library/project_models/mdt420e0x001_c3d.stp

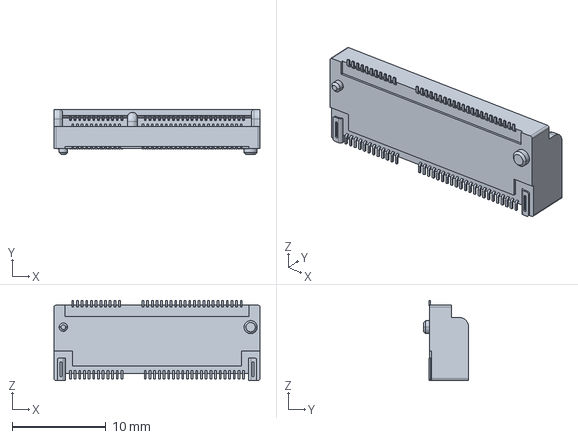
[picture p61: CAD file, 2026-01-04]
project_models/mdt420e0x001_c3d.stp
22.0 x 4.80 x 8.55 mm
