ben5049/component-library/project_models/MDT320E0X001_c3d.stp

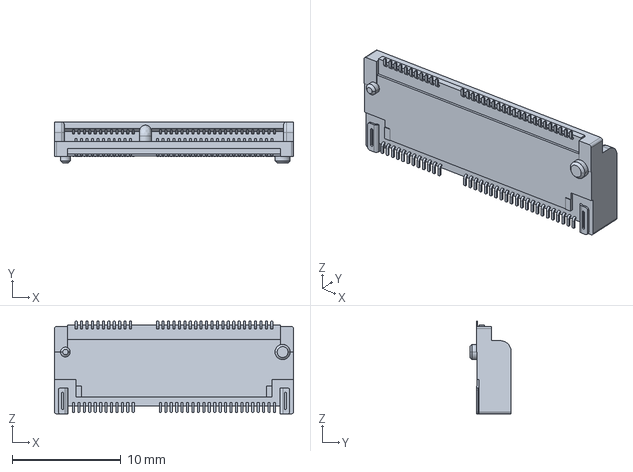
[picture p62: CAD file, 2026-01-04]
project_models/MDT320E0X001_c3d.stp
22.0 x 3.80 x 8.55 mm
