ben5049/component-library/project_models/PI7C9X2G304SLBFDE.stp

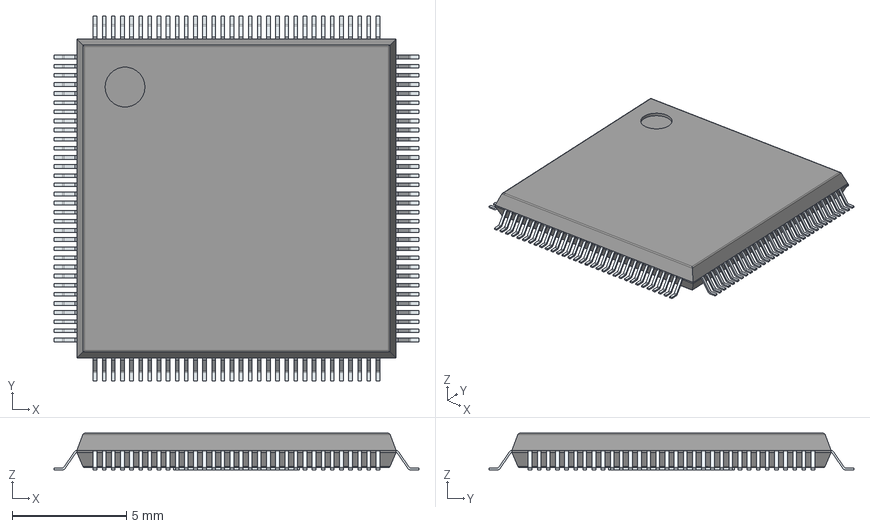
[picture p63: CAD file, 2025-12-18]
project_models/PI7C9X2G304SLBFDE.stp
16.0 x 16.0 x 1.60 mm
PinsArrayLR
PinsArrayTB
ThermalPad
