ben5049/component-library/project_models/CON-SMA-EDGE.stp

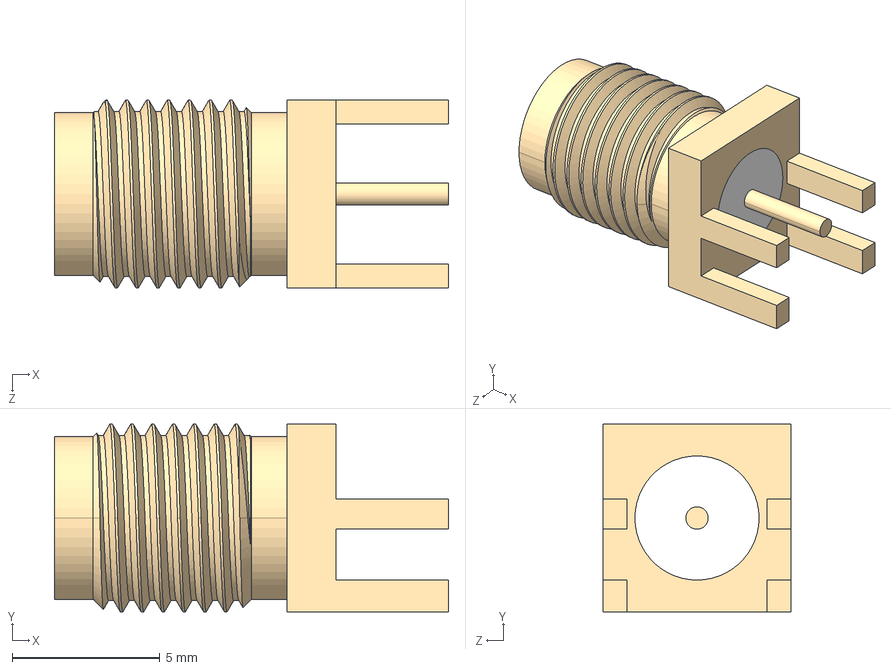
[picture p64: CAD file, 2025-12-16]
project_models/CON-SMA-EDGE.stp
13.3 x 6.35 x 6.35 mm
