ben5049/component-library/project_models/U.FL-R-SMT-K_895_.stp

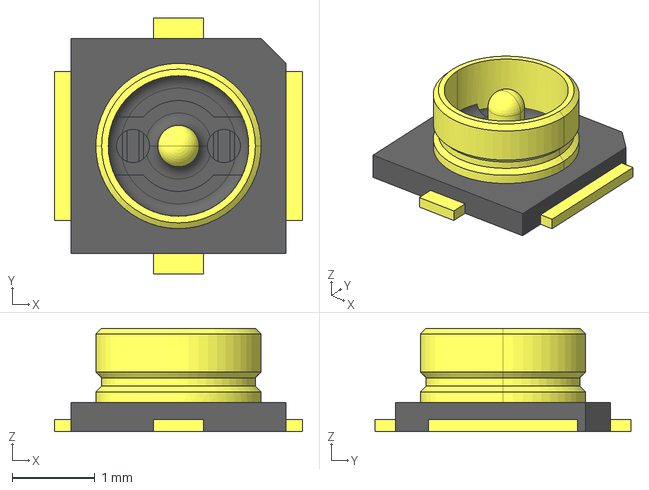
[picture p65: CAD file, 2025-12-16]
project_models/U.FL-R-SMT-K_895_.stp
3.00 x 3.10 x 1.25 mm
