ben5049/component-library/project_models/MDT275E01001.stp

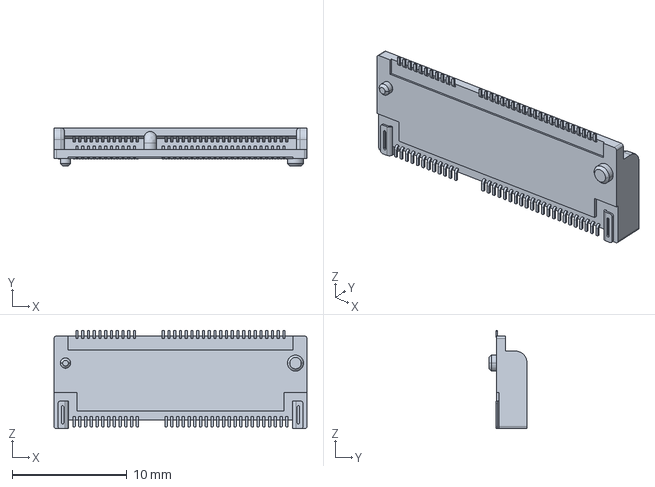
[picture p66: CAD file, 2025-12-14]
project_models/MDT275E01001.stp
22.0 x 3.30 x 8.55 mm
