ben5049/component-library/project_models/PI7C9X2G303ELBZXEX.stp

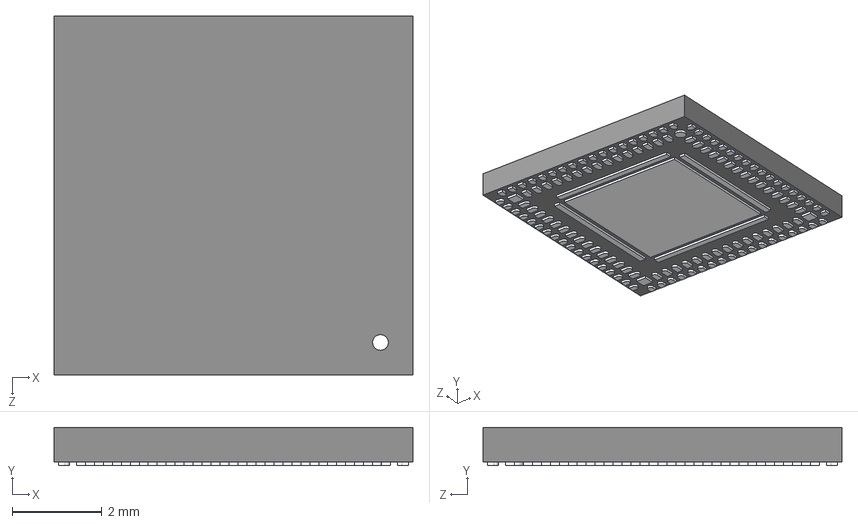
[picture p67: CAD file, 2025-12-14]
project_models/PI7C9X2G303ELBZXEX.stp
8.00 x 0.85 x 8.00 mm
