ben5049/component-library/project_models/STM32H533CEU6.stp

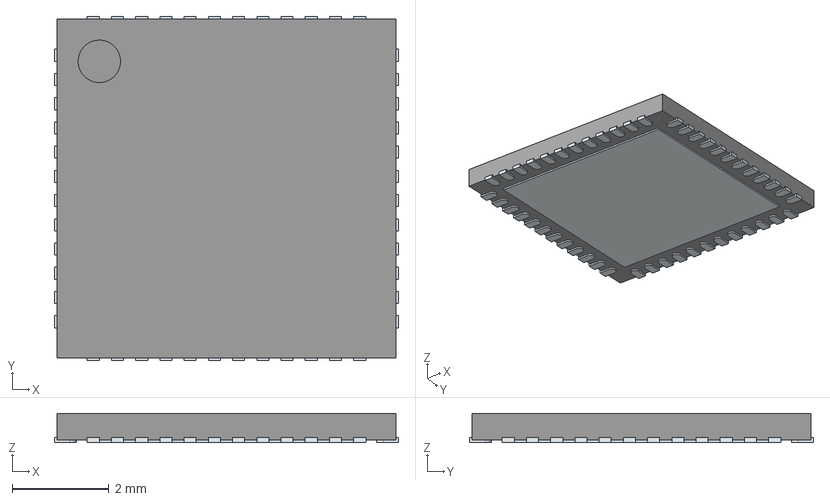
[picture p68: CAD file, 2025-12-14]
project_models/STM32H533CEU6.stp
7.10 x 7.10 x 0.6 mm
ThermalPin
PinsArrayLR
PinsArrayTB
