ben5049/component-library/project_models/LAN7431_YXX.stp

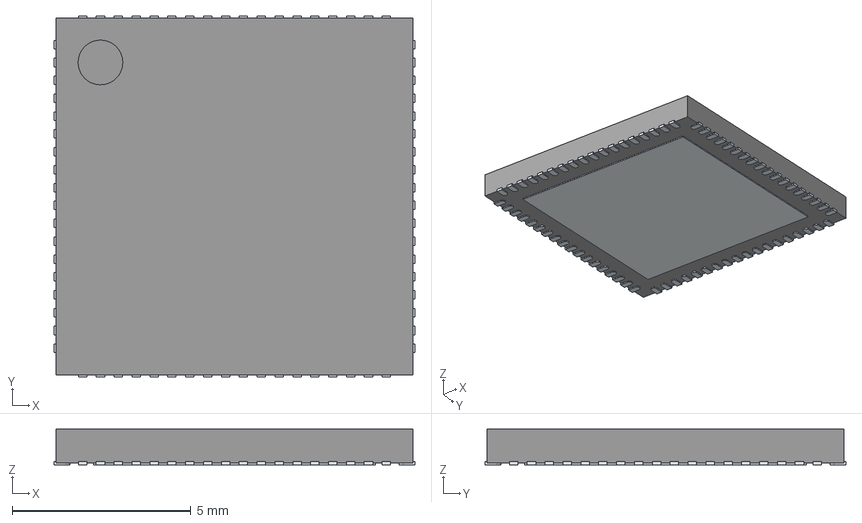
[picture p69: CAD file, 2025-12-14]
project_models/LAN7431_YXX.stp
10.1 x 10.1 x 1.00 mm
ThermalPin
PinsArrayLR
PinsArrayTB
