ben5049/component-library/project_models/DQN0004A.stp

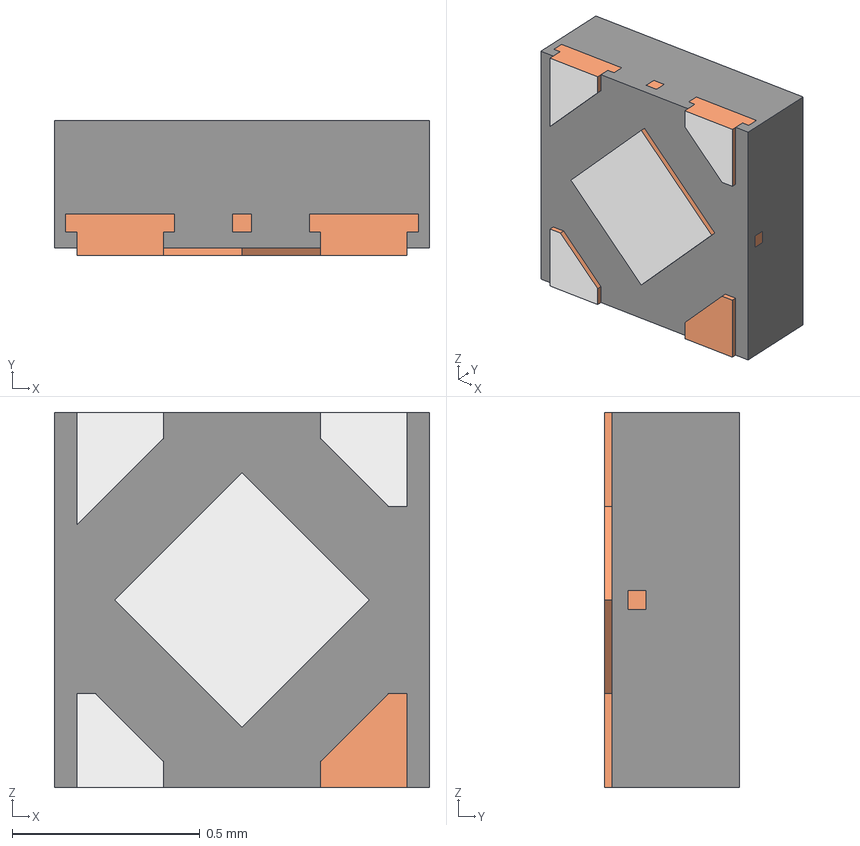
[picture p70: CAD file, 2025-11-19]
project_models/DQN0004A.stp
1.00 x 0.36 x 1.00 mm
MOLD-SNB04A
FRAME-SNB04A
