ben5049/component-library/project_models/MX25R1635FZUIH0.stp

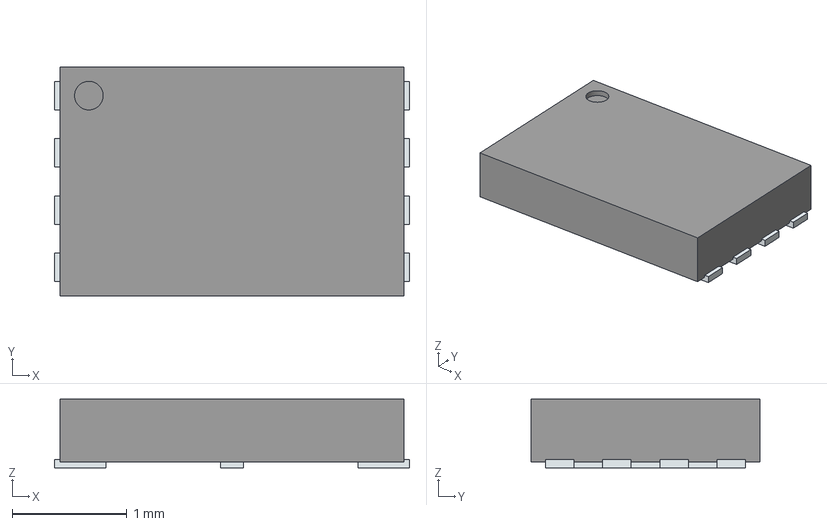
[picture p71: CAD file, 2025-11-13]
project_models/MX25R1635FZUIH0.stp
3.10 x 2.00 x 0.6 mm
ThermalPin
PinsArrayLR
