ben5049/component-library/project_models/ALP0180A.step

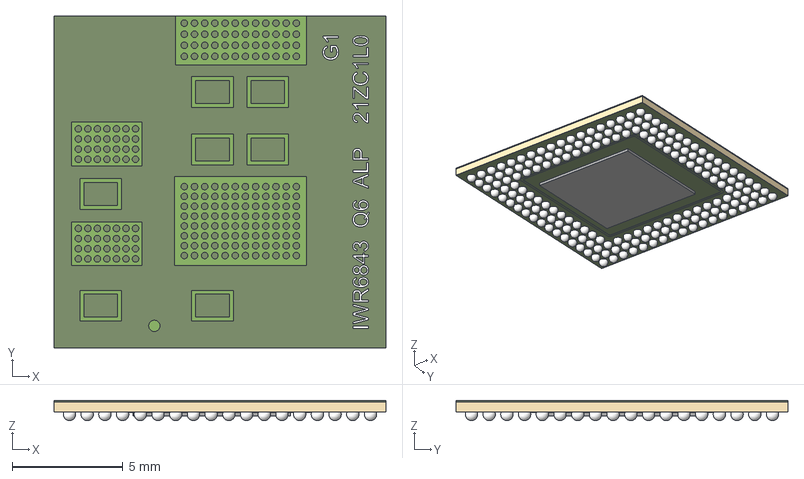
[picture p72: CAD file, 2025-11-13]
project_models/ALP0180A.step
15.0 x 15.0 x 0.914 mm
FCCSP_CORE_AF0
FCCSP_SOLDER_BALL x 180
FCCSP_SMTOP
FCCSP_SOLDER_MASK
DIE
SMDAM
