ben5049/component-library/project_models/MCKK2012TR47M.stp

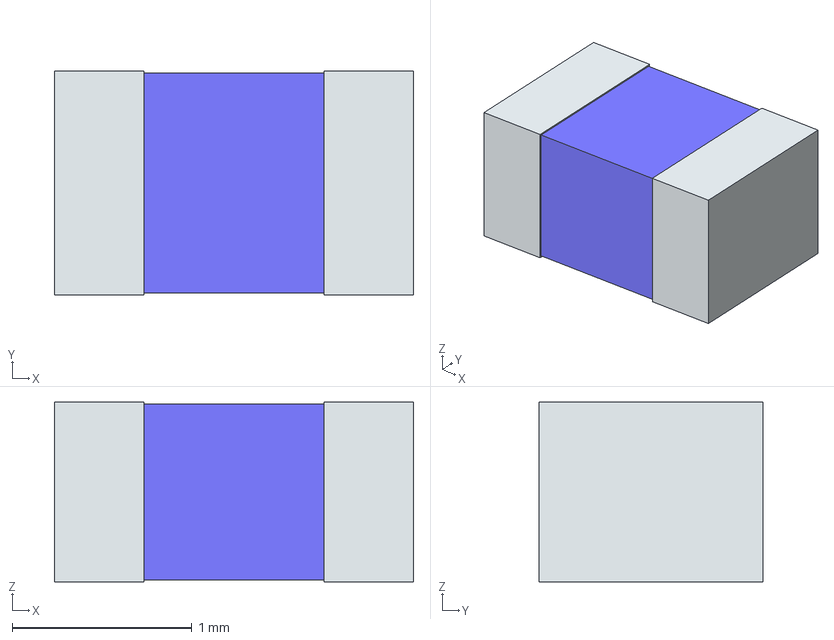
[picture p73: CAD file, 2025-11-13]
project_models/MCKK2012TR47M.stp
2.00 x 1.25 x 1.00 mm
term1
term2
