ben5049/component-library/project_models/L_Wurth_WE-PMFI-322512.step

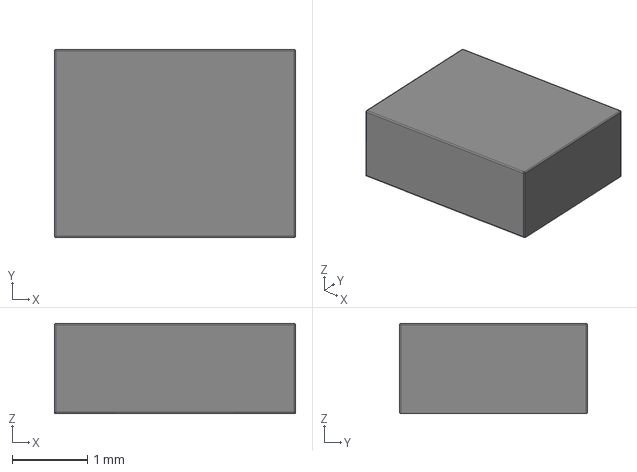
[picture p74: CAD file, 2025-11-13]
project_models/L_Wurth_WE-PMFI-322512.step
3.20 x 2.50 x 1.20 mm
