ben5049/component-library/project_models/L_Wurth_WE-PMFI-201610.step

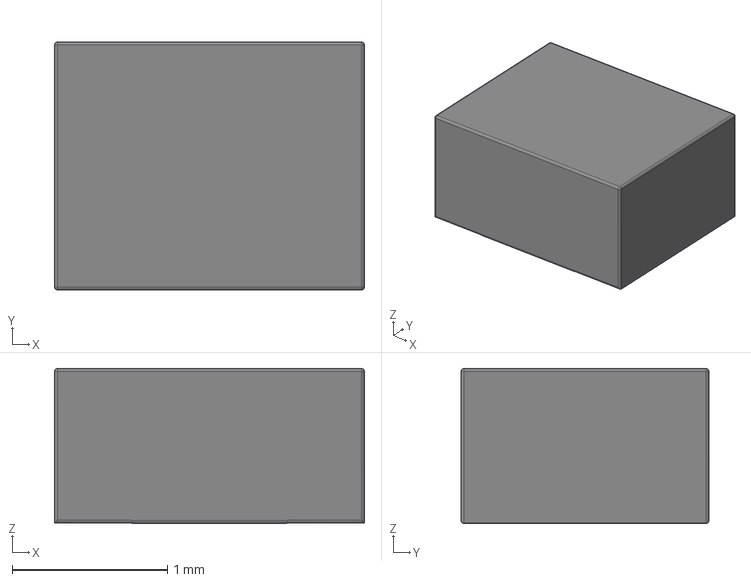
[picture p75: CAD file, 2025-11-13]
project_models/L_Wurth_WE-PMFI-201610.step
2.00 x 1.60 x 1.00 mm
