ben5049/component-library/project_models/L_Wurth_WE-PMFI-353220.step

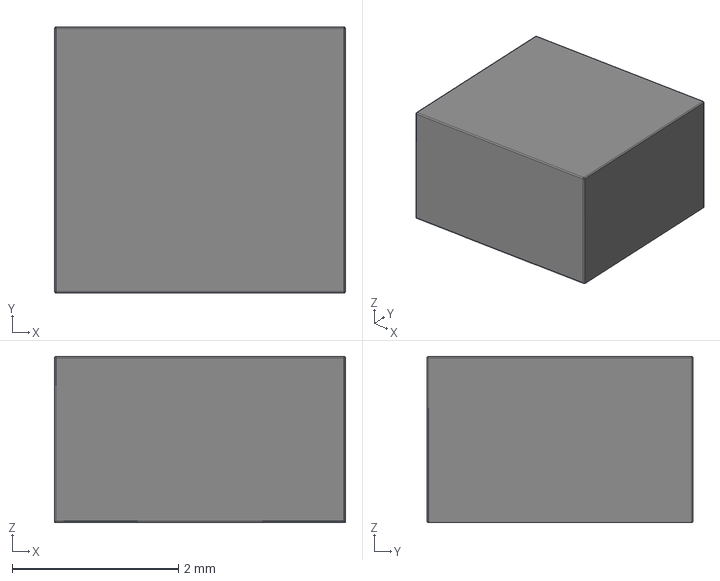
[picture p76: CAD file, 2025-11-13]
project_models/L_Wurth_WE-PMFI-353220.step
3.50 x 3.20 x 2.00 mm
