ben5049/component-library/project_models/L_Wurth_WE-PMFI-252012.step

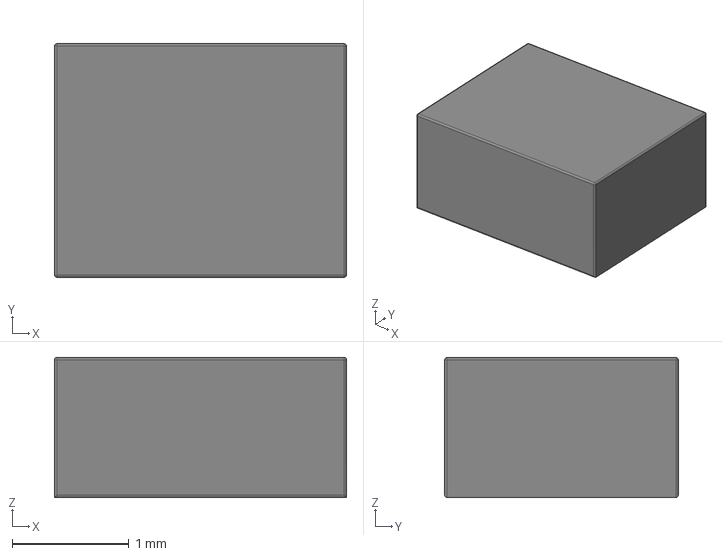
[picture p77: CAD file, 2025-11-13]
project_models/L_Wurth_WE-PMFI-252012.step
2.50 x 2.00 x 1.20 mm
