ben5049/component-library/project_models/phy_module_1000_base_t1_v1.step

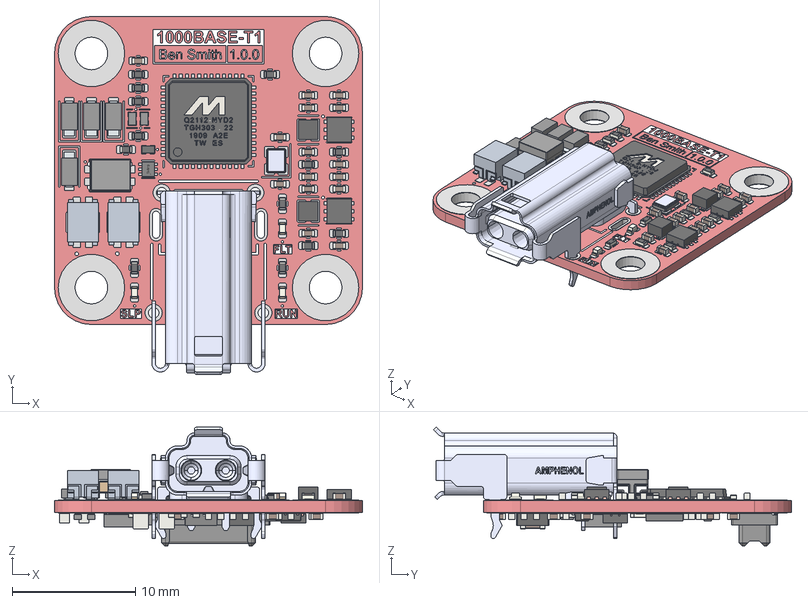
[picture p78: CAD file, 2025-11-02]
project_models/phy_module_1000_base_t1_v1.step
25.0 x 29.1 x 9.64 mm
R_0402_1005Metric x 26
LED_0402_1005Metric x 3
ubN}p@ACT1210 DRK180705 x 2
ubN}p@ACT1210[q x 4
ubN}p@ACT1210[q2 x 4
3.9maxp[q x 8
C_0402_1005Metric x 45
Pins x 10
BODY-SON x 3
PIN1-ID x 3
NX2016SA-40M-STD-CZS-3_NX2016SA-40M-STD-CZS-3
SOD882 body x 2
SOD882A3 singulated LF unit x 2
L_Wurth_WE-MAPI_1610 x 2
ACT1210G-800-2P-TL10
MSPE-J2L0-B00
pins x 6
housing
88Q2112
L_Wurth_WE-MAPI_2510
BODY-SOT
C_0805_2012Metric x 2
UFQFPN20_3x3x0p6
LMQ66410MC3RXBRQ1
C_0603_1608Metric x 2
DMN62D1LFD
BM54F3.0-30DP-0.4V_51_
phy_module_1000_base_t1_v1_pad
phy_module_1000_base_t1_v1_silkscreen x 2
phy_module_1000_base_t1_v1_PCB
