ben5049/component-library/project_models/FH34SRJ-22S-0.5SH.stp

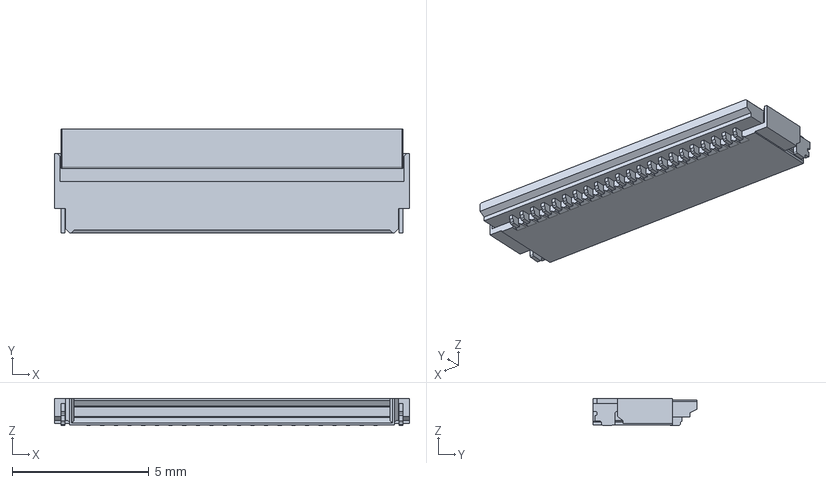
[picture p79: CAD file, 2025-10-20]
project_models/FH34SRJ-22S-0.5SH.stp
13.0 x 3.80 x 1.00 mm
