ben5049/component-library/project_models/FH34SRJ-16S-0.5SH.stp

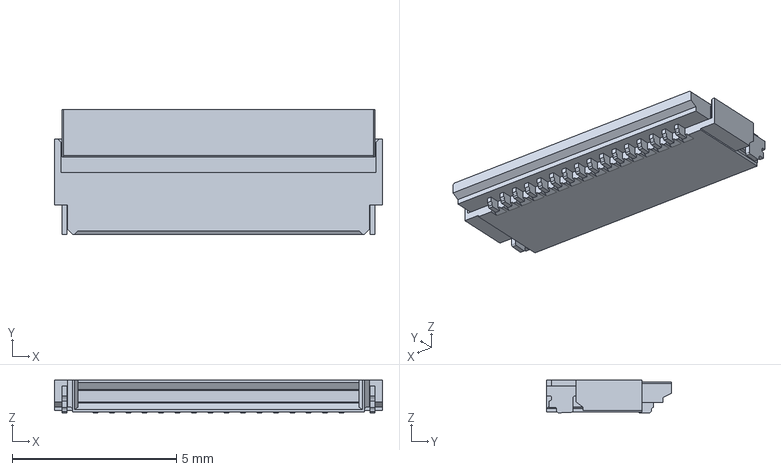
[picture p80: CAD file, 2025-10-20]
project_models/FH34SRJ-16S-0.5SH.stp
10.0 x 3.80 x 1.00 mm
