ben5049/component-library/project_models/TPS7A0518PYKAR.stp

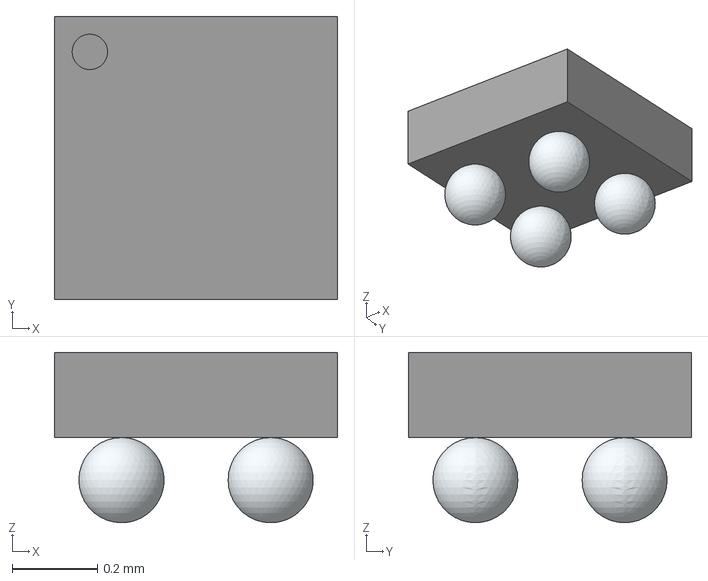
[picture p81: CAD file, 2025-10-20]
project_models/TPS7A0518PYKAR.stp
0.664 x 0.664 x 0.4 mm
