ben5049/component-library/project_models/VFBGA198_10X10_STM.step

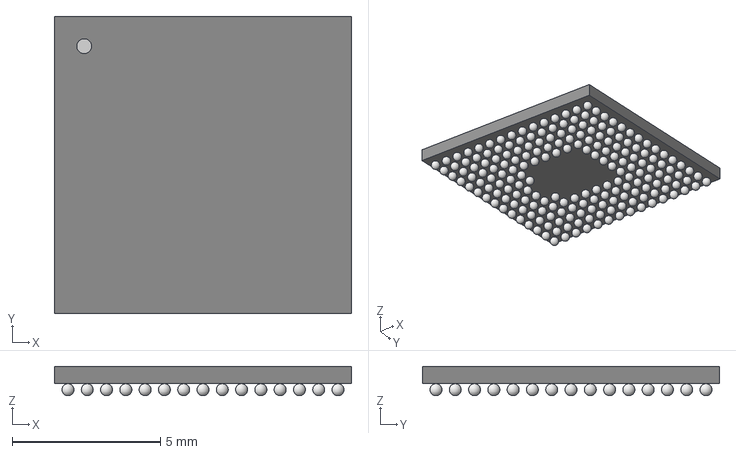
[picture p82: CAD file, 2025-10-18]
project_models/VFBGA198_10X10_STM.step
10.0 x 10.0 x 0.993 mm
