ben5049/component-library/project_models/NX3L4051HRZ.stp

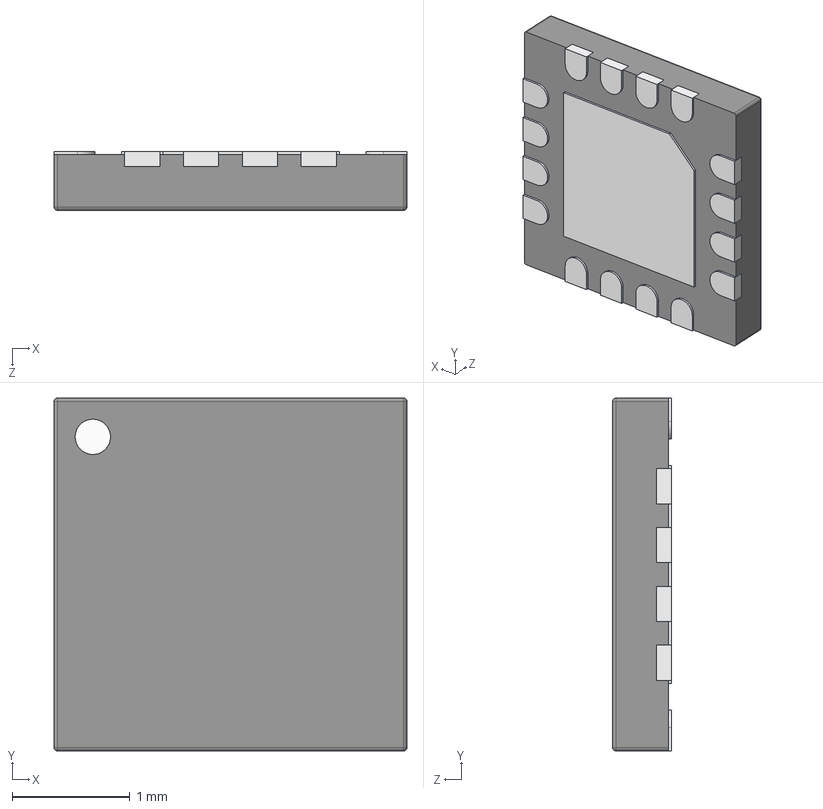
[picture p83: CAD file, 2025-10-11]
project_models/NX3L4051HRZ.stp
3.00 x 3.00 x 0.5 mm
