ben5049/component-library/project_models/TS3A5223RSWR.stp

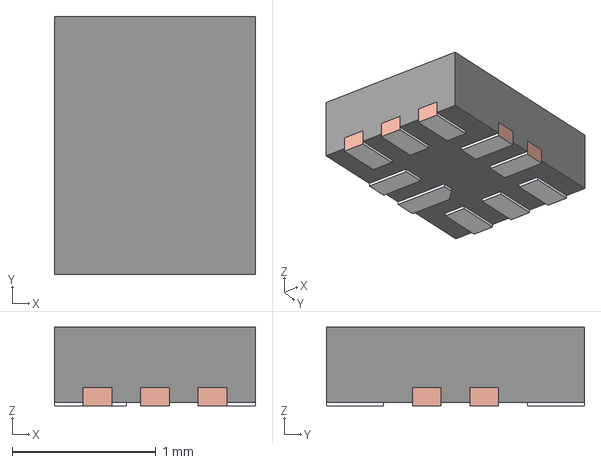
[picture p84: CAD file, 2025-09-20]
project_models/TS3A5223RSWR.stp
1.40 x 1.80 x 0.55 mm
FRAME
