ben5049/component-library/project_models/NCS213RMUTAG.stp

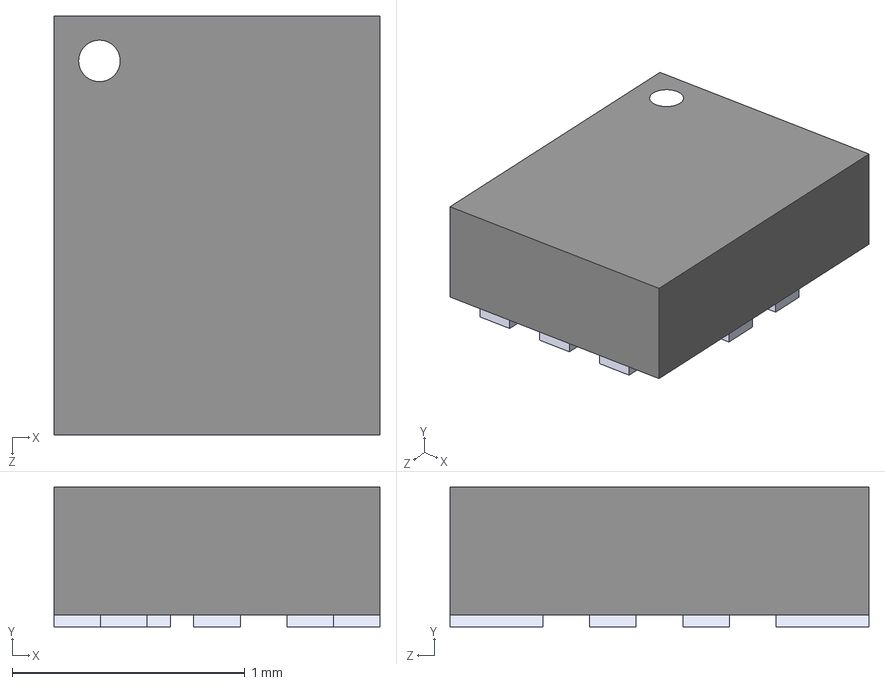
[picture p85: CAD file, 2025-07-01]
project_models/NCS213RMUTAG.stp
1.40 x 0.6 x 1.80 mm
LMV982MUTAG_4
LMV982MUTAG_10
LMV982MUTAG_5
LMV982MUTAG
LMV982MUTAG_9
LMV982MUTAG_8
LMV982MUTAG_11
LMV982MUTAG_3
LMV982MUTAG_6
LMV982MUTAG_1
LMV982MUTAG_2
LMV982MUTAG_7
