ben5049/component-library/project_models/WDFN6_1P5X1P5_ONS.step

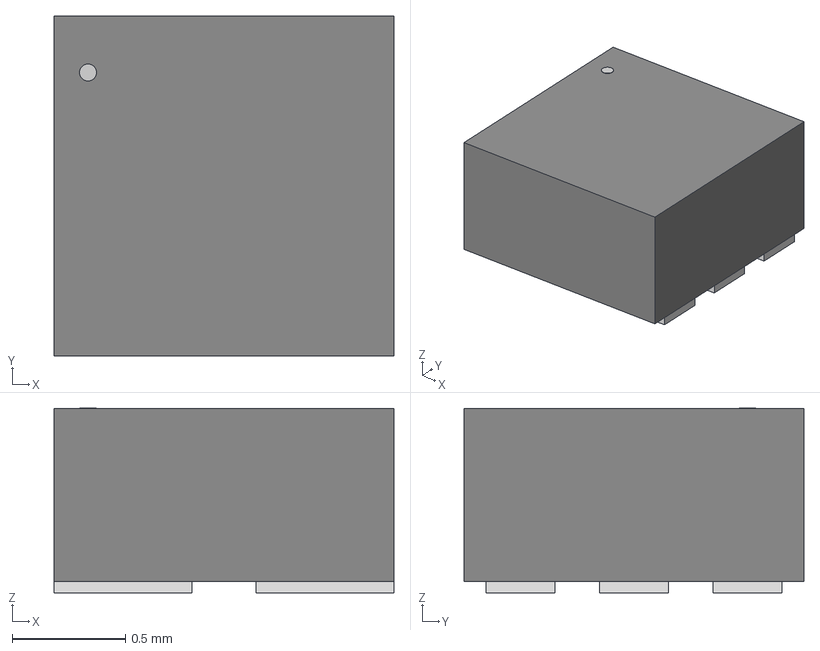
[picture p86: CAD file, 2025-06-30]
project_models/WDFN6_1P5X1P5_ONS.step
1.50 x 1.50 x 0.815 mm
