ben5049/component-library/project_models/ADP5301ACBZ-4-R7.stp

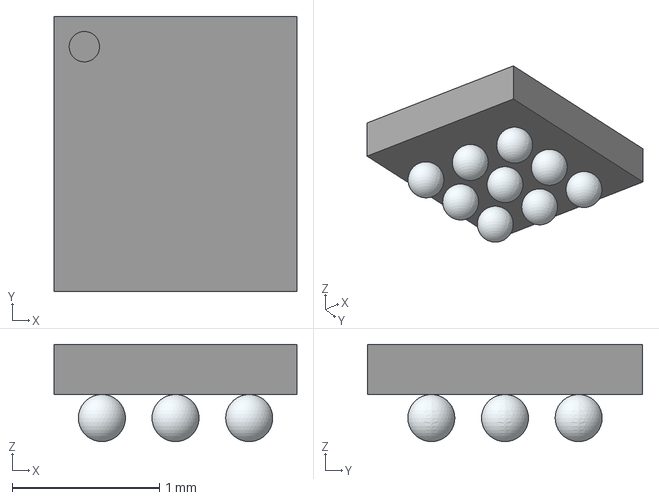
[picture p87: CAD file, 2025-06-30]
project_models/ADP5301ACBZ-4-R7.stp
1.65 x 1.87 x 0.66 mm
