ben5049/component-library/project_models/88Q2112.step

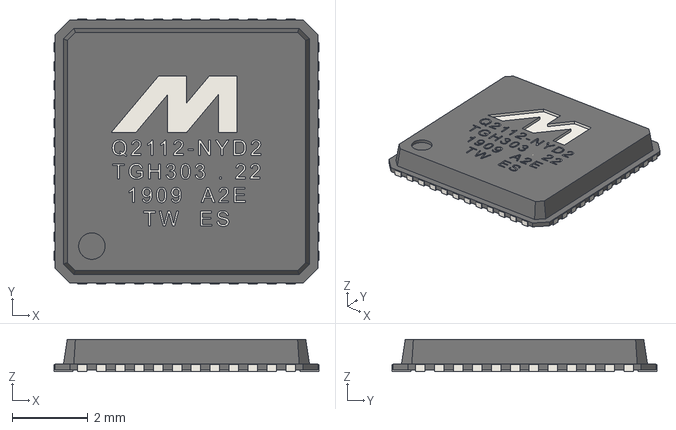
[picture p88: CAD file, 2025-06-30]
project_models/88Q2112.step
7.00 x 7.00 x 0.853 mm
