ben5049/component-library/project_models/2038-15-SM-RPLF.stp

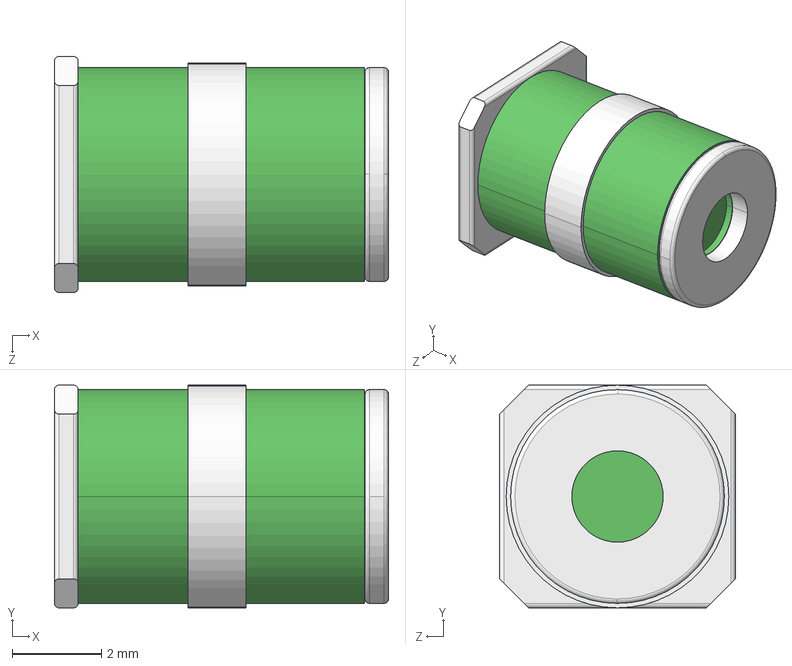
[picture p89: CAD file, 2025-06-29]
project_models/2038-15-SM-RPLF.stp
7.50 x 5.00 x 5.30 mm
