ben5049/component-library/project_models/LMK1C1104DQFR.stp

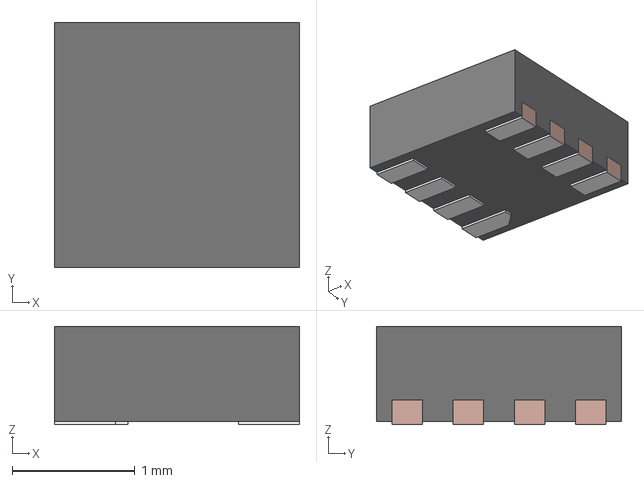
[picture p90: CAD file, 2025-06-28]
project_models/LMK1C1104DQFR.stp
2.00 x 2.00 x 0.8 mm
FRAME
MOLD
