ben5049/component-library/project_models/ACT1210G-800-2P-TL10.stp

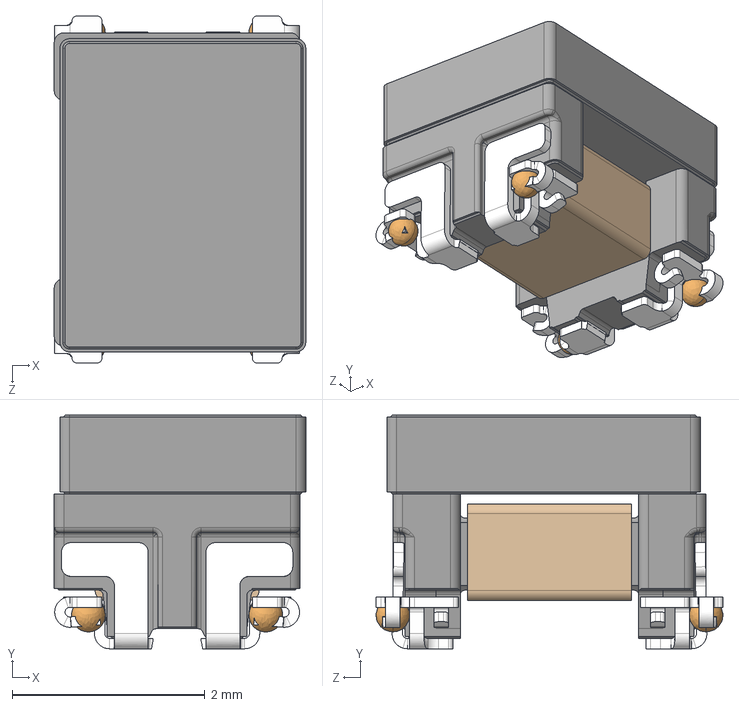
[picture p91: CAD file, 2025-06-20]
project_models/ACT1210G-800-2P-TL10.stp
2.61 x 2.42 x 3.60 mm
