ben5049/component-library/project_models/MSD7342.step

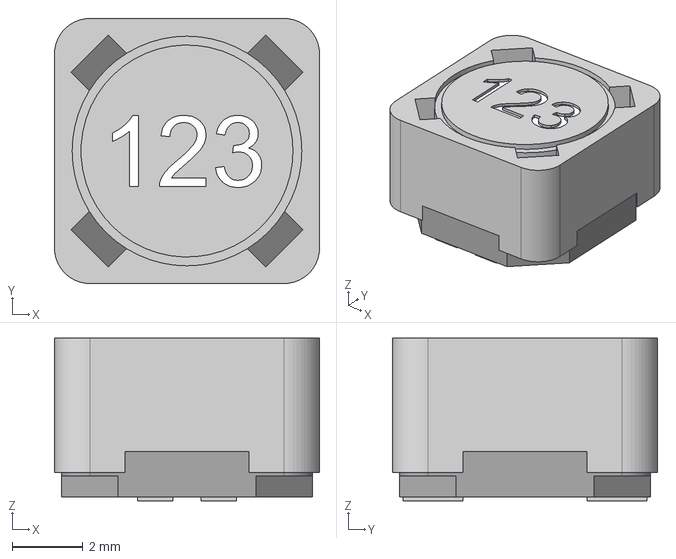
[picture p92: CAD file, 2025-06-18]
project_models/MSD7342.step
7.50 x 7.50 x 4.60 mm
