ben5049/component-library/project_models/ADL3225VT-4R7M-TL000.stp

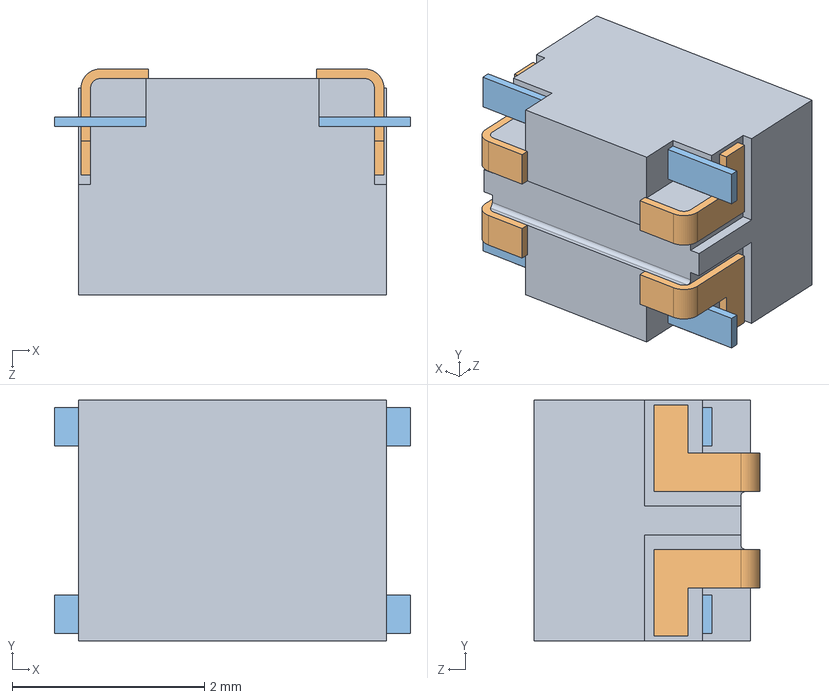
[picture p93: CAD file, 2025-06-18]
project_models/ADL3225VT-4R7M-TL000.stp
3.70 x 2.50 x 2.35 mm
ブロック図用 ACT1210 DRK180705
ブロック図用 ACT1210端子 x 2
ブロック図用 ACT1210端子2 x 2
3.9max用端子 x 4
