ben5049/component-library/project_models/TPS27S100ARRKR.stp

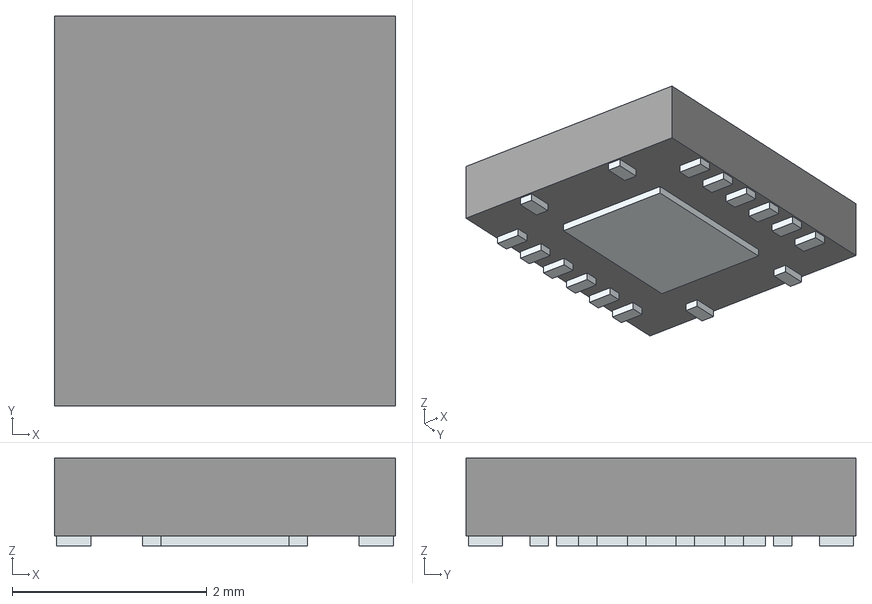
[picture p94: CAD file, 2025-06-16]
project_models/TPS27S100ARRKR.stp
3.50 x 4.00 x 0.9 mm
Pins
