ben5049/component-library/project_models/TS3DV20812RHHR.stp

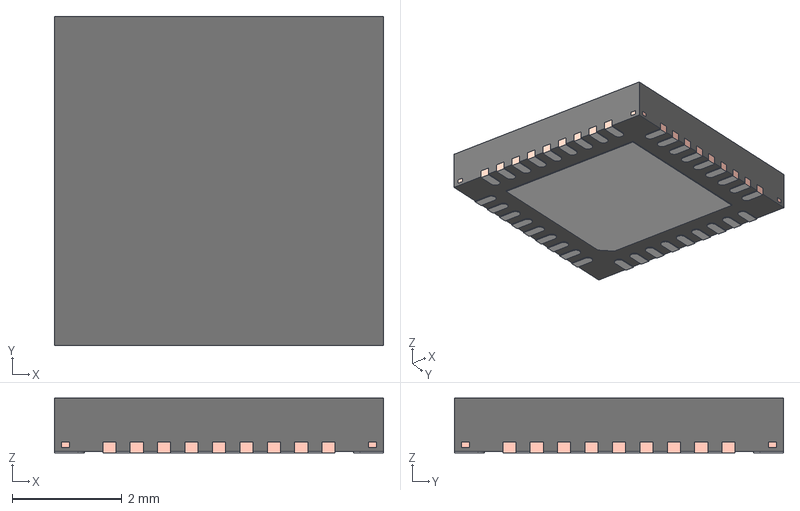
[picture p95: CAD file, 2025-06-16]
project_models/TS3DV20812RHHR.stp
6.00 x 6.00 x 1.00 mm
FRAME
PIN1_AREA
