ben5049/component-library/project_models/S1791-42R.stp

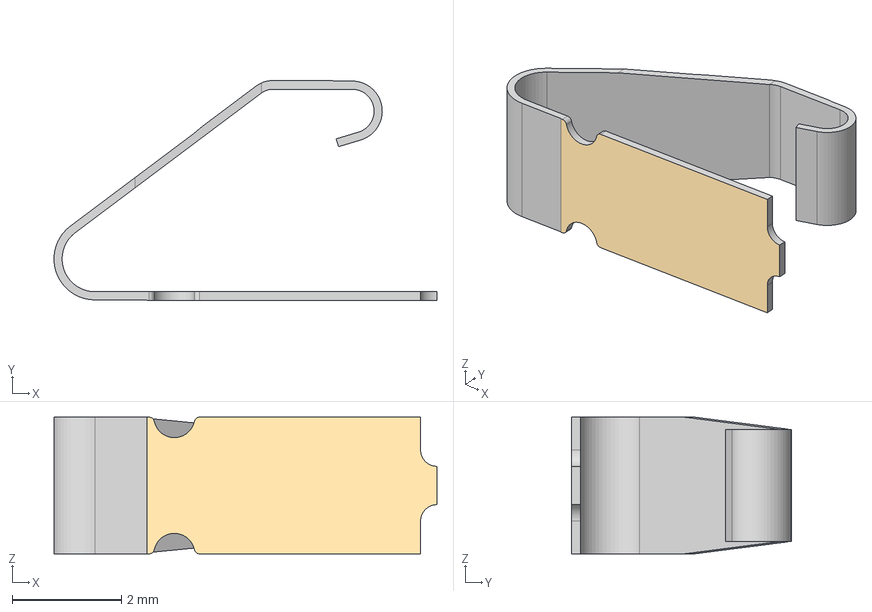
[picture p96: CAD file, 2025-06-07]
project_models/S1791-42R.stp
7.00 x 4.02 x 2.50 mm
