ben5049/component-library/project_models/S1791-42R_3mm.step

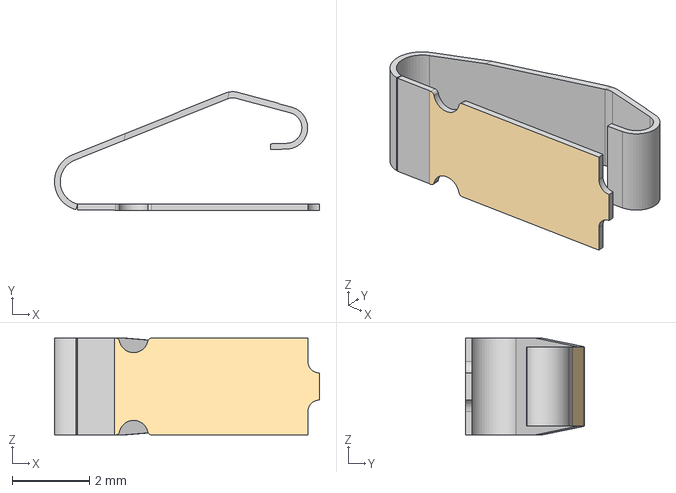
[picture p97: CAD file, 2025-06-07]
project_models/S1791-42R_3mm.step
6.84 x 3.06 x 2.50 mm
Bottom
Top
