ben5049/component-library/project_models/TPS2116DRLR.stp

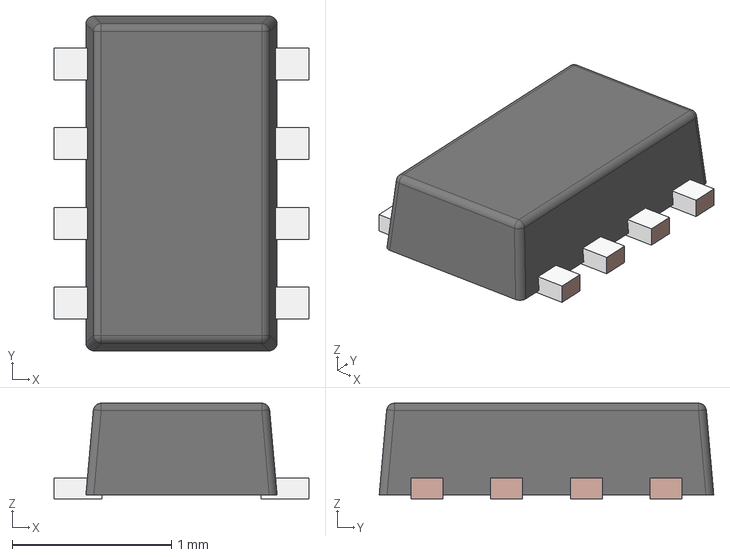
[picture p98: CAD file, 2025-06-06]
project_models/TPS2116DRLR.stp
1.60 x 2.10 x 0.6 mm
FRAME-DRL0008A
BODY-SOT
