ben5049/component-library/project_models/UFQFPN20_3x3x0p6.step

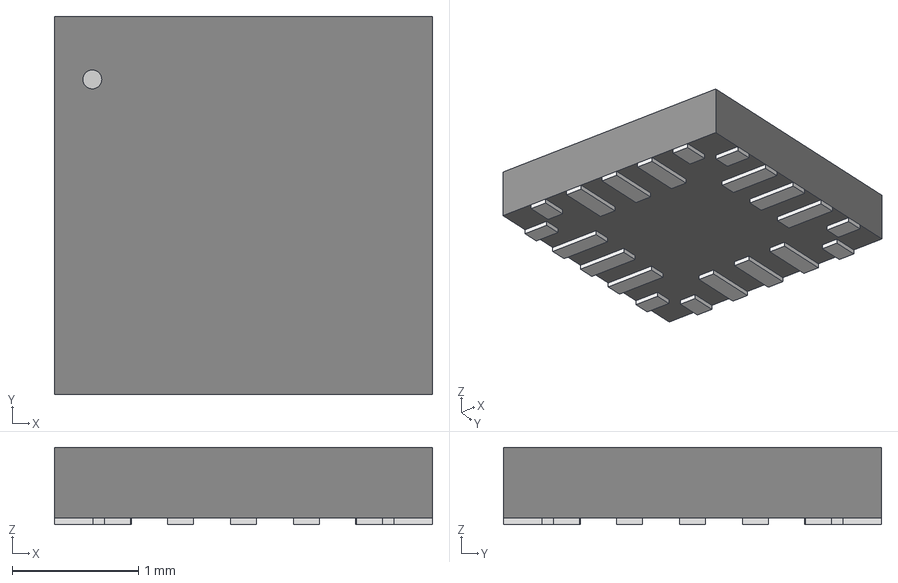
[picture p99: CAD file, 2025-06-06]
project_models/UFQFPN20_3x3x0p6.step
3.00 x 3.00 x 0.612 mm
