ben5049/component-library/project_models/FM25LxB-DG.stp

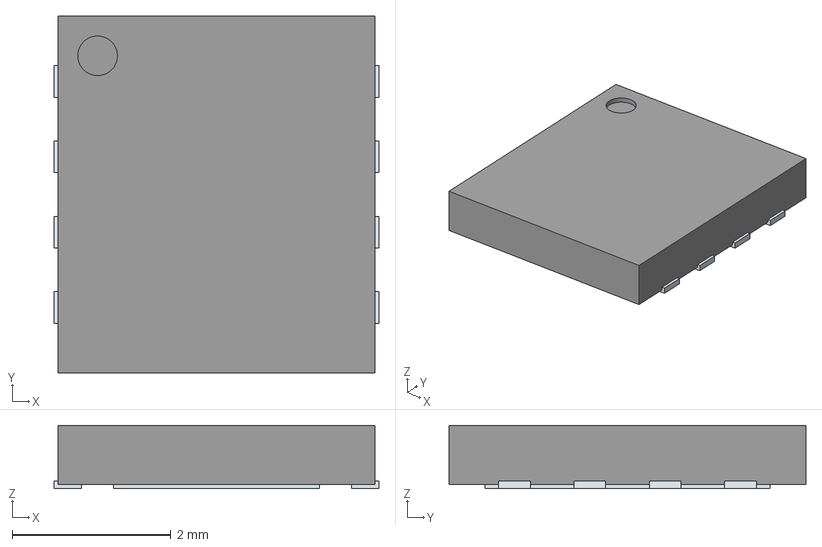
[picture p100: CAD file, 2025-06-04]
project_models/FM25LxB-DG.stp
4.10 x 4.50 x 0.8 mm
ThermalPin
PinsArrayLR
