ben5049/component-library/project_models/MSPE-J2L0-E00-vertical.step

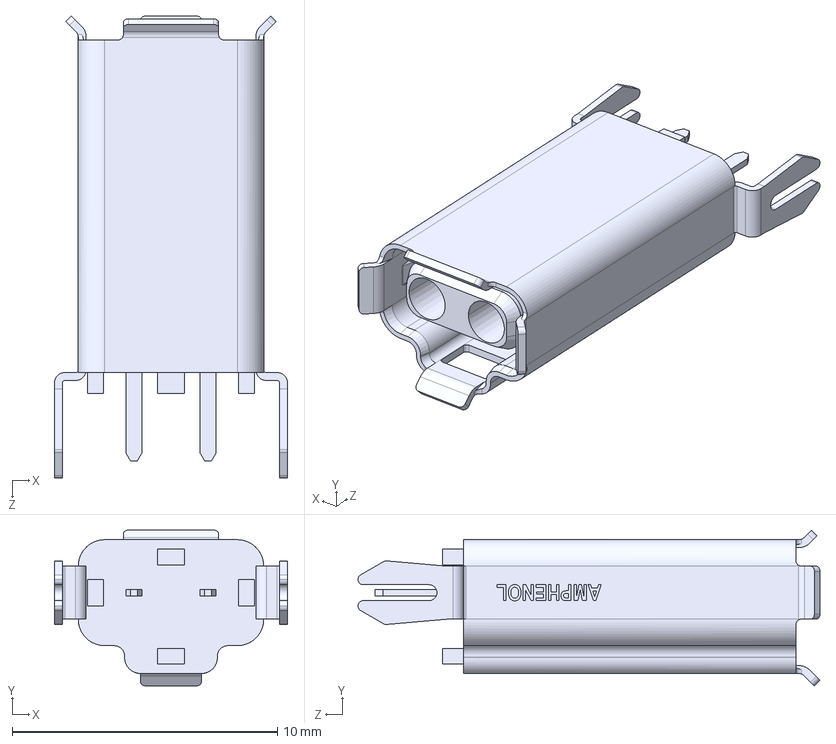
[picture p101: CAD file, 2025-05-21]
project_models/MSPE-J2L0-E00-vertical.step
8.80 x 5.88 x 17.4 mm
