ben5049/component-library/project_models/ACT1210E.stp

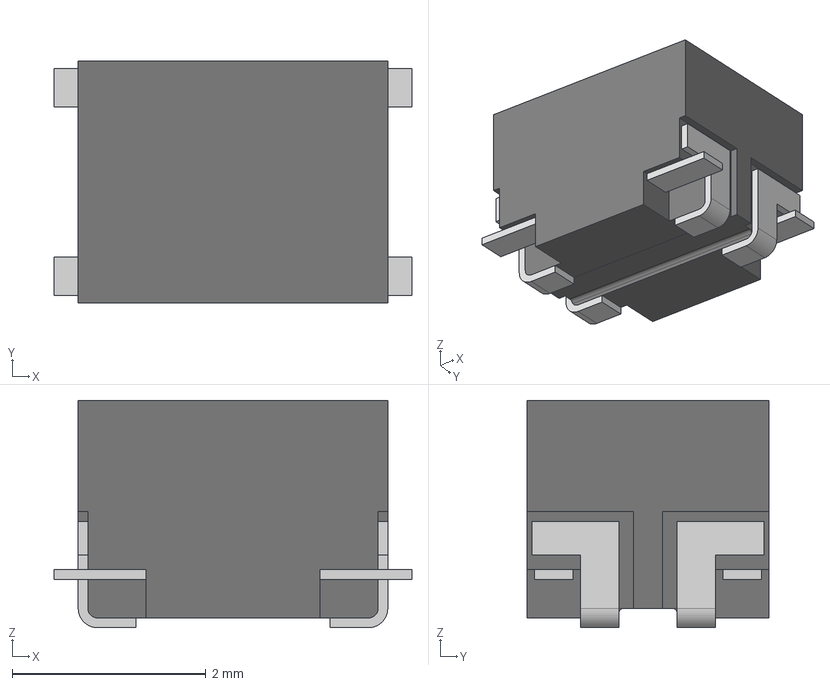
[picture p102: CAD file, 2025-05-20]
project_models/ACT1210E.stp
3.70 x 2.50 x 2.35 mm
ubN}p@ACT1210 D RK180705
ubN}p@ACT1210 [q x 2
ubN}p@ACT1210 [q2 x 2
3.9maxp[q x 4
