ben5049/component-library/project_models/WNCB-2200306.STEP

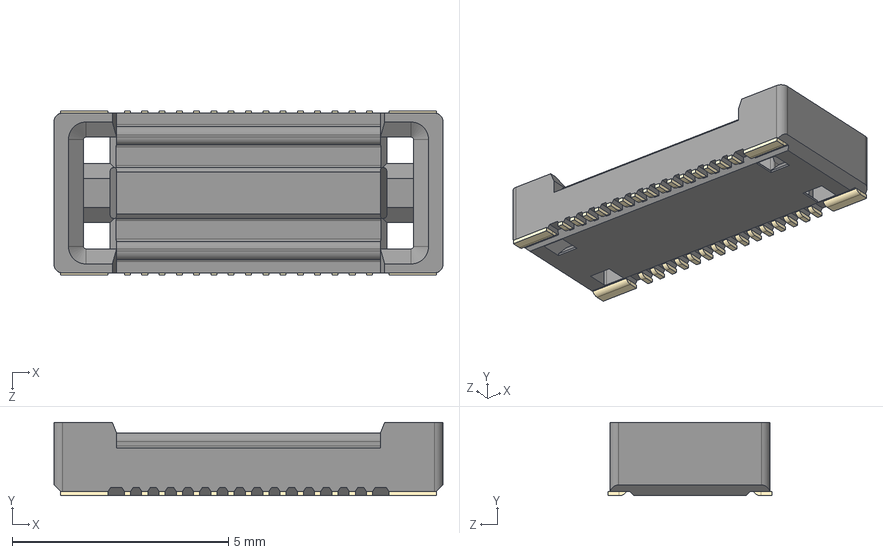
[picture p103: CAD file, 2025-05-20]
project_models/WNCB-2200306.STEP
9.00 x 1.70 x 3.80 mm
