ben5049/component-library/project_models/L_Wurth_WE-MXGI-5030.step

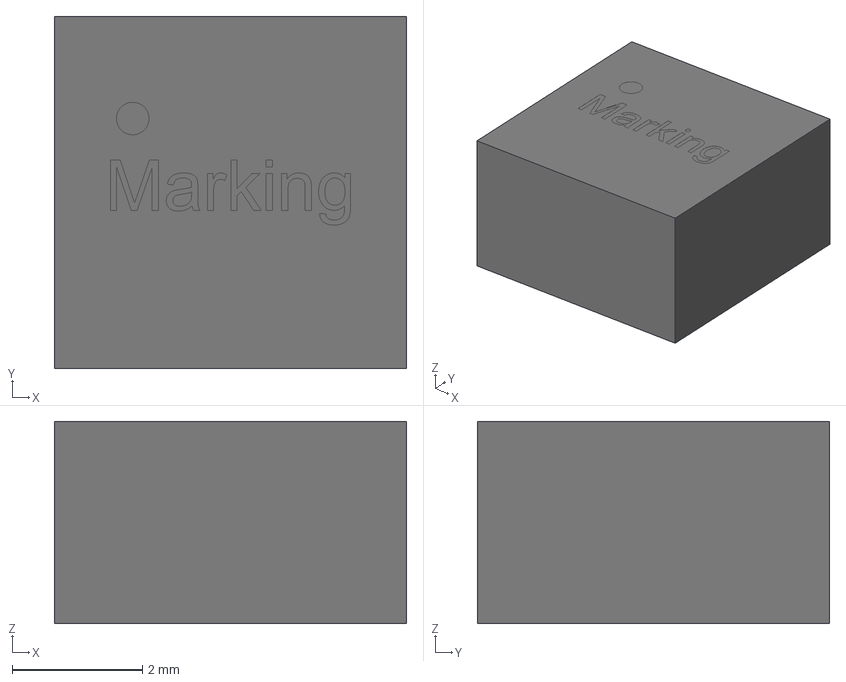
[picture p104: CAD file, 2025-05-09]
project_models/L_Wurth_WE-MXGI-5030.step
5.40 x 5.40 x 3.10 mm
body_SSMC_5030
land_pattern x 2
