ben5049/component-library/project_models/L_Wurth_WE-MAIA-1610.step

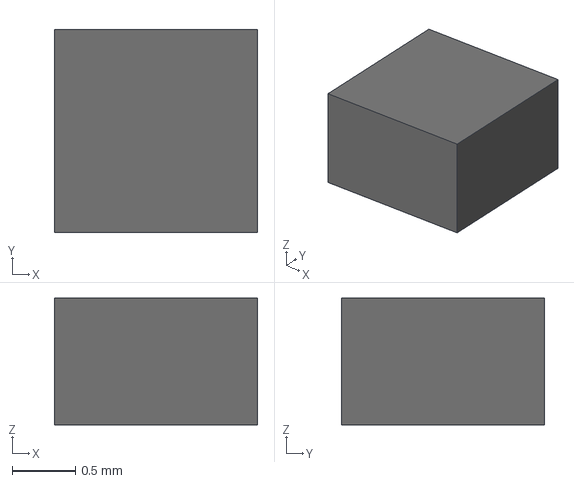
[picture p105: CAD file, 2025-05-09]
project_models/L_Wurth_WE-MAIA-1610.step
1.60 x 1.60 x 1.00 mm
