ben5049/component-library/project_models/BM54F3.0-30DP-0.4V_51_.stp

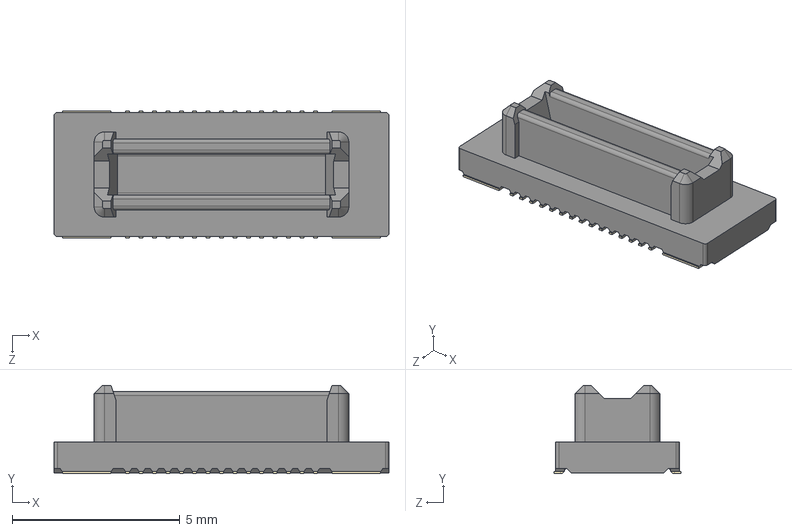
[picture p106: CAD file, 2025-05-09]
project_models/BM54F3.0-30DP-0.4V_51_.stp
10.0 x 2.64 x 3.80 mm
