ben5049/component-library/project_models/L_Wurth_WE-MAIA-6030HT.step

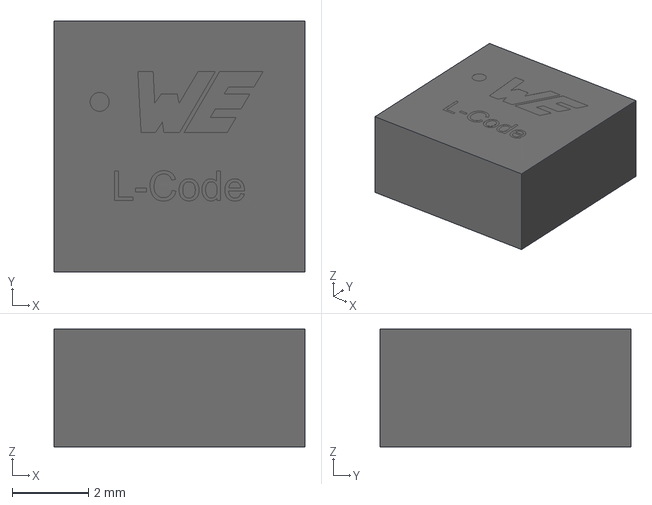
[picture p107: CAD file, 2025-05-09]
project_models/L_Wurth_WE-MAIA-6030HT.step
6.60 x 6.60 x 3.10 mm
