ben5049/component-library/project_models/L_Wurth_WE-MAIA-3015.step

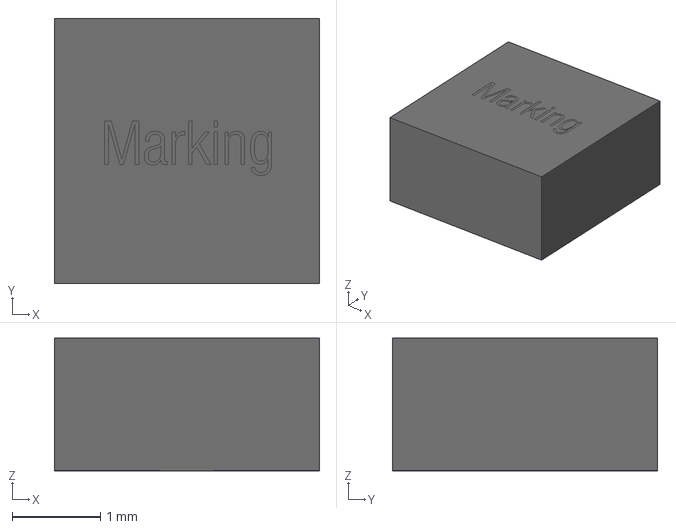
[picture p108: CAD file, 2025-05-09]
project_models/L_Wurth_WE-MAIA-3015.step
3.00 x 3.00 x 1.50 mm
