ben5049/component-library/project_models/L_Wurth_WE-MAIA-2506.step

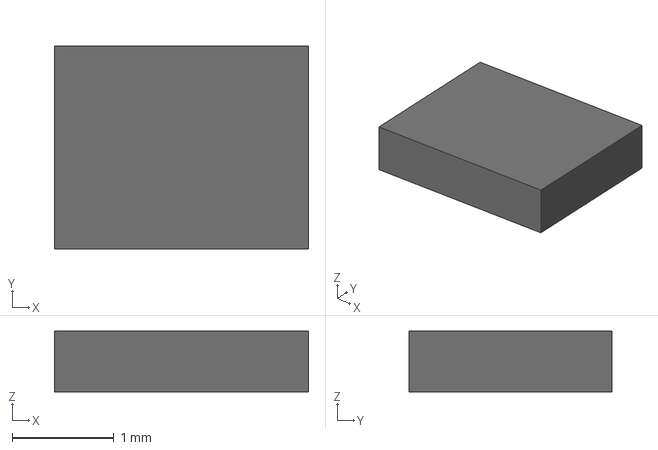
[picture p110: CAD file, 2025-05-09]
project_models/L_Wurth_WE-MAIA-2506.step
2.50 x 2.00 x 0.6 mm
