ben5049/component-library/project_models/L_Wurth_WE-MAIA-3010.step

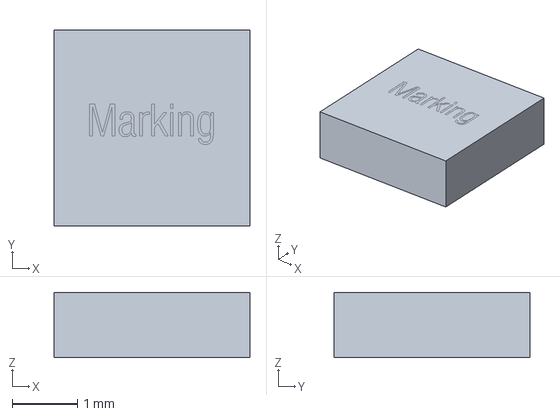
[picture p111: CAD file, 2025-05-09]
project_models/L_Wurth_WE-MAIA-3010.step
3.00 x 3.00 x 1 mm
