ben5049/component-library/project_models/L_Wurth_WE-MAIA-3020HT.step

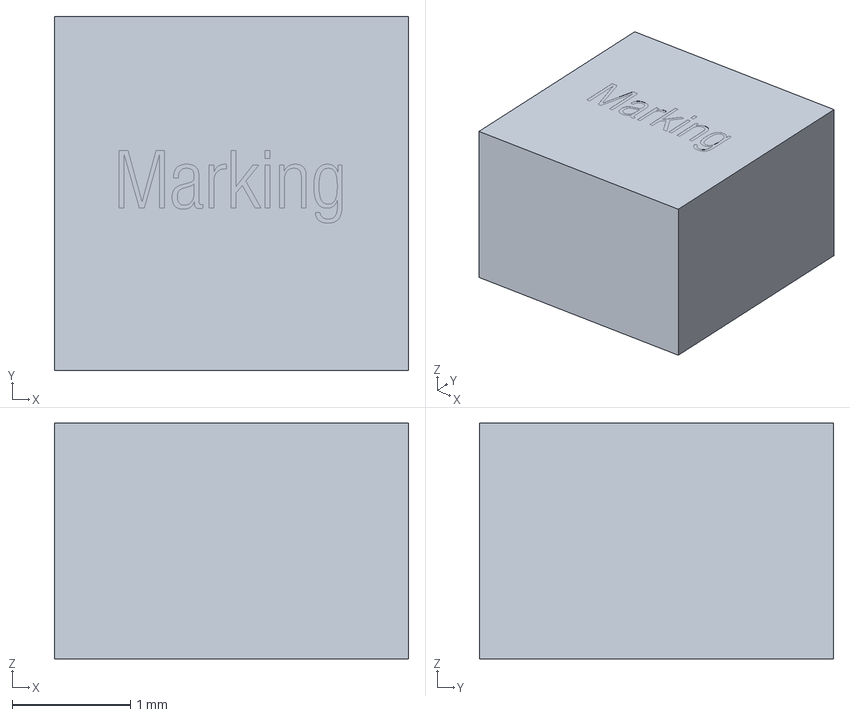
[picture p113: CAD file, 2025-05-09]
project_models/L_Wurth_WE-MAIA-3020HT.step
3.00 x 3.00 x 2.00 mm
