ben5049/component-library/project_models/L_Wurth_WE-MXGI-4020.step

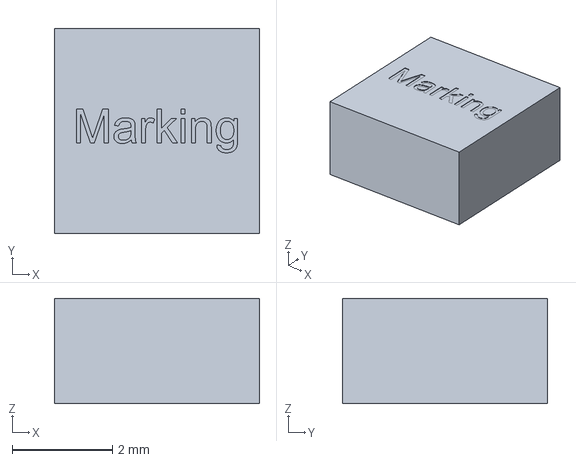
[picture p114: CAD file, 2025-05-09]
project_models/L_Wurth_WE-MXGI-4020.step
4.10 x 4.10 x 2.10 mm
