ben5049/component-library/project_models/L_Wurth_WE-MAIA-5020.step

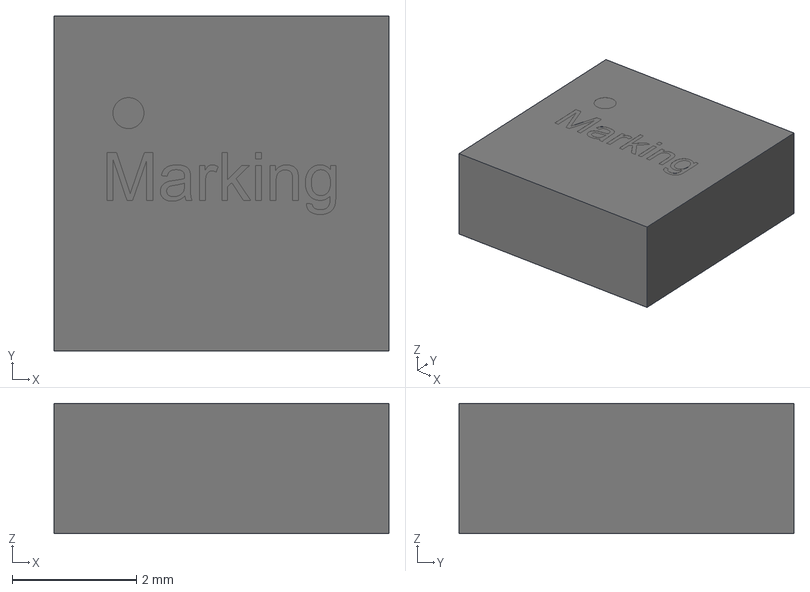
[picture p115: CAD file, 2025-05-09]
project_models/L_Wurth_WE-MAIA-5020.step
5.40 x 5.40 x 2.10 mm
body_SSMC_5020
land_pattern x 2
