ben5049/component-library/project_models/L_Wurth_WE-MAIA-3012.step

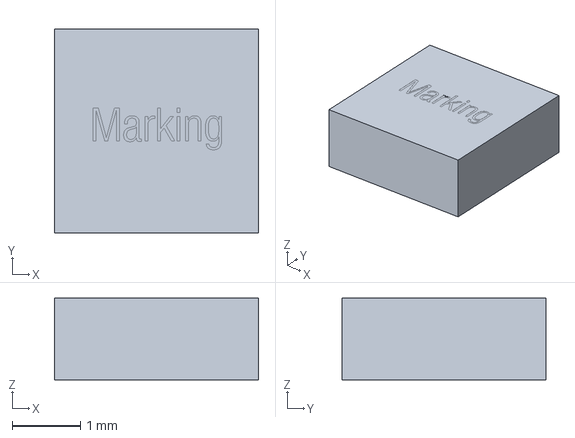
[picture p116: CAD file, 2025-05-09]
project_models/L_Wurth_WE-MAIA-3012.step
3.00 x 3.00 x 1.20 mm
