ben5049/component-library/project_models/SiT8008Bxx7.step

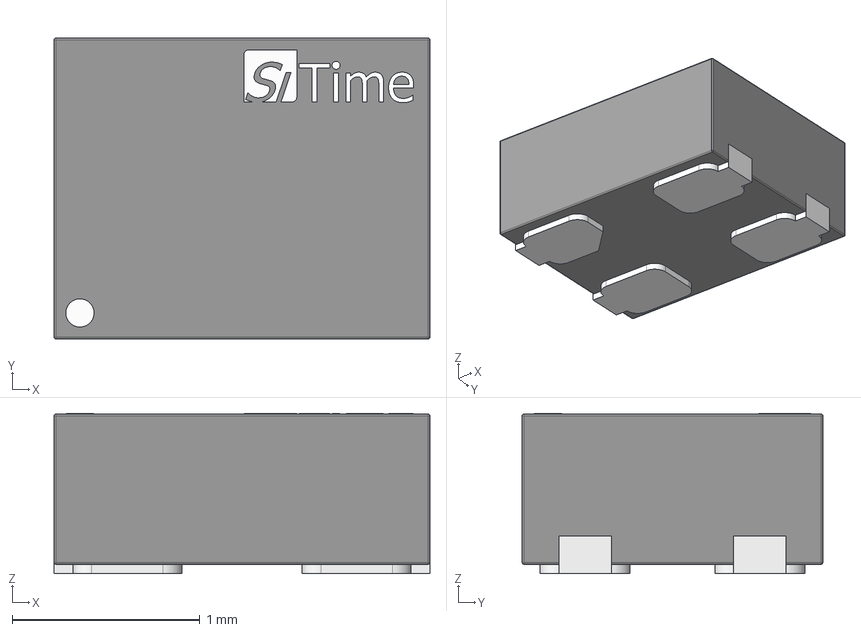
[picture p117: CAD file, 2025-05-09]
project_models/SiT8008Bxx7.step
2.00 x 1.60 x 0.853 mm
pads
base
logo
