ben5049/component-library/project_models/L_Wurth_WE-MAIA-4012.step

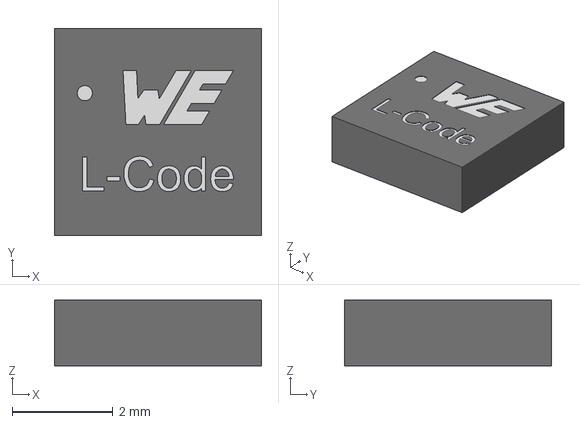
[picture p118: CAD file, 2025-05-09]
project_models/L_Wurth_WE-MAIA-4012.step
4.10 x 4.10 x 1.30 mm
