ben5049/component-library/project_models/L_Wurth_WE-MAIA-2010.step

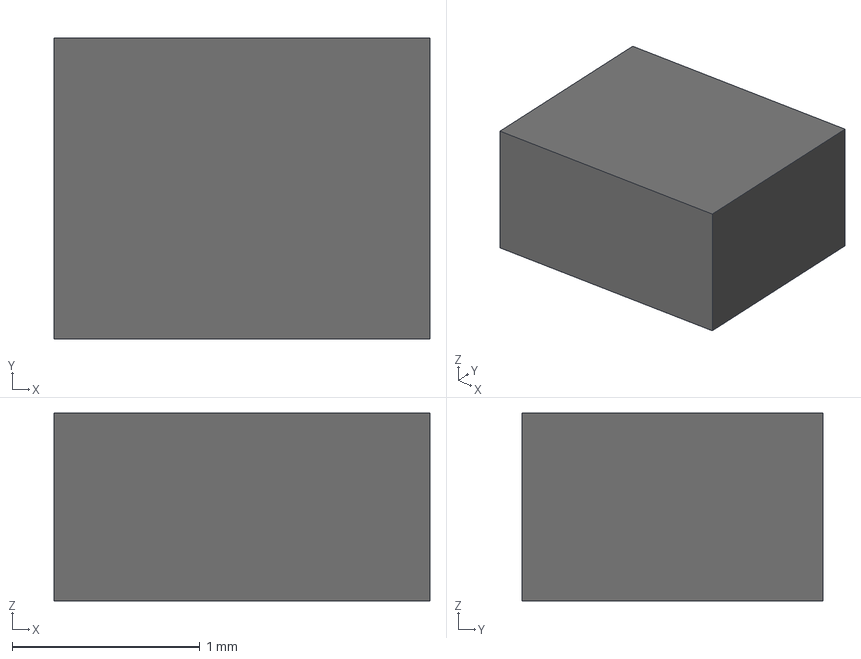
[picture p119: CAD file, 2025-05-09]
project_models/L_Wurth_WE-MAIA-2010.step
2.00 x 1.60 x 1.00 mm
