ben5049/component-library/project_models/L_Wurth_WE-MAIA-4030.step

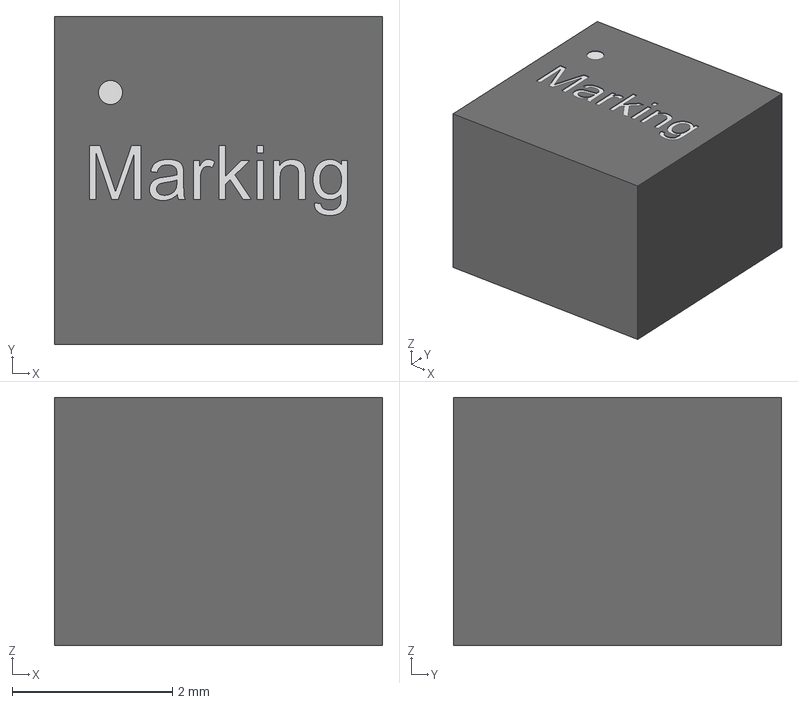
[picture p120: CAD file, 2025-05-09]
project_models/L_Wurth_WE-MAIA-4030.step
4.10 x 4.10 x 3.10 mm
