ben5049/component-library/project_models/L_Wurth_WE-DD-1260crossed.step

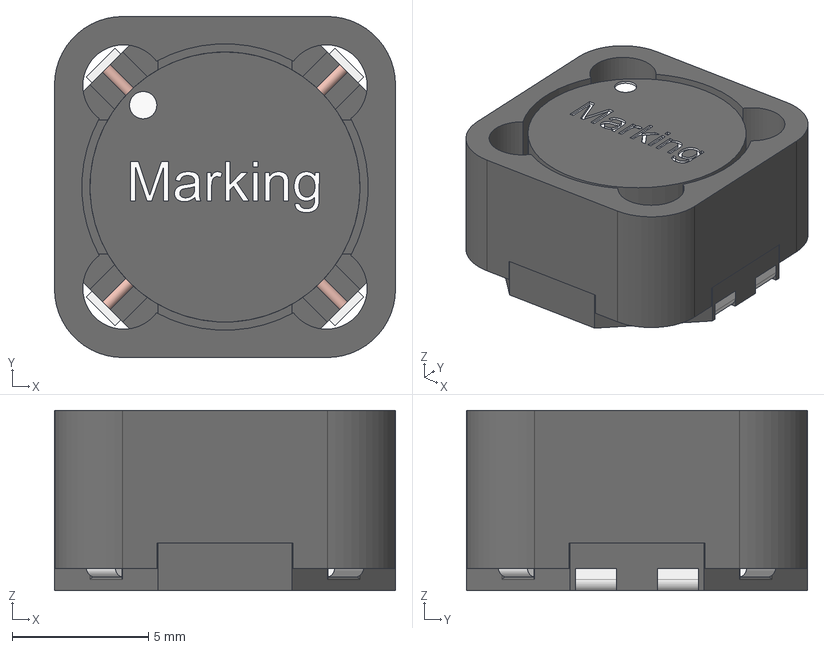
[picture p122: CAD file, 2025-05-07]
project_models/L_Wurth_WE-DD-1260crossed.step
12.5 x 12.5 x 6.60 mm
