ben5049/component-library/project_models/L_Wurth_WE-DD-1280crossed.step

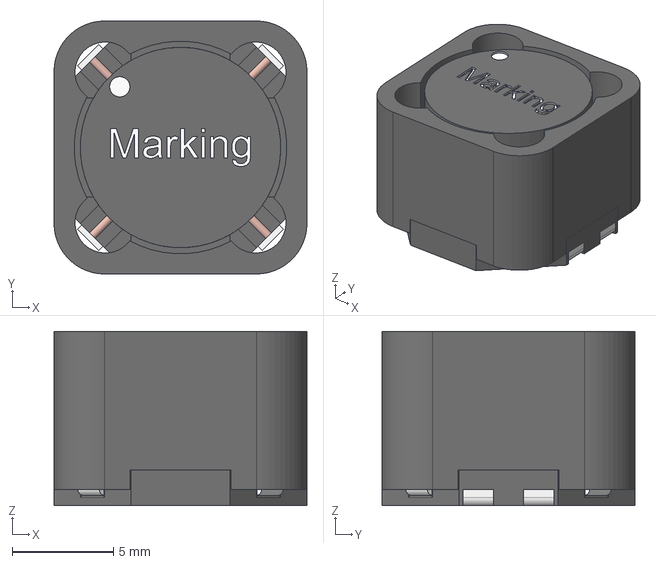
[picture p123: CAD file, 2025-05-07]
project_models/L_Wurth_WE-DD-1280crossed.step
12.5 x 12.5 x 8.60 mm
