ben5049/component-library/project_models/TLV7031QDCKRQ1.stp

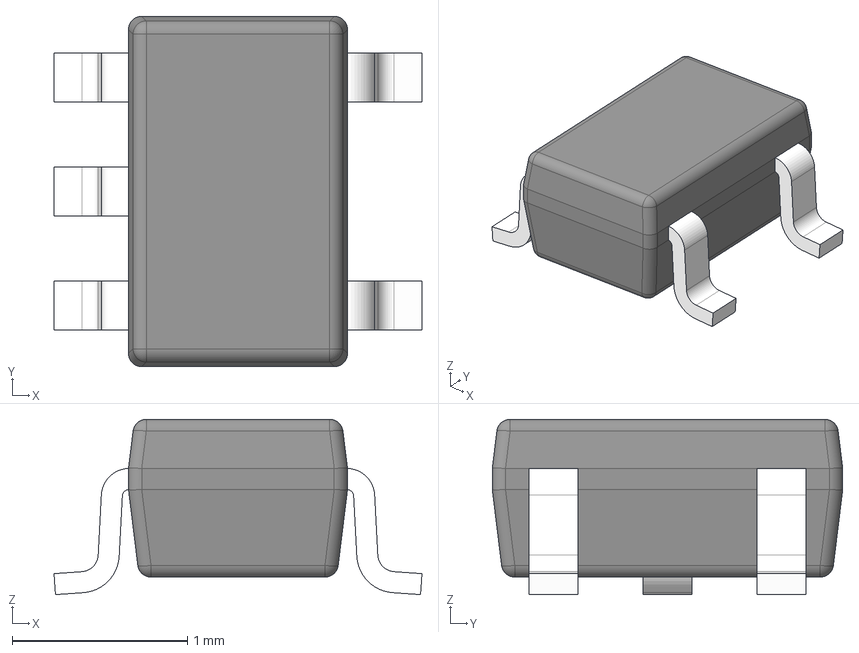
[picture p124: CAD file, 2025-05-07]
project_models/TLV7031QDCKRQ1.stp
2.10 x 2.00 x 1.00 mm
BODY-SOT
LEAD-SOT x 5
PIN1-ID
