ben5049/component-library/project_models/L_Wurth_WE-DD-7332straight.step

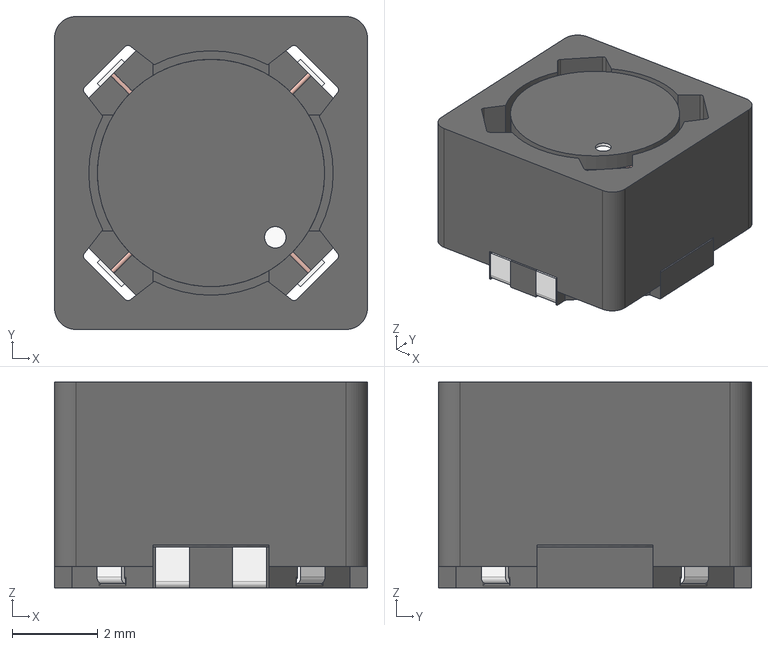
[picture p125: CAD file, 2025-05-07]
project_models/L_Wurth_WE-DD-7332straight.step
7.30 x 7.30 x 4.80 mm
