ben5049/component-library/project_models/L_Wurth_WE-DD-1210crossed.step

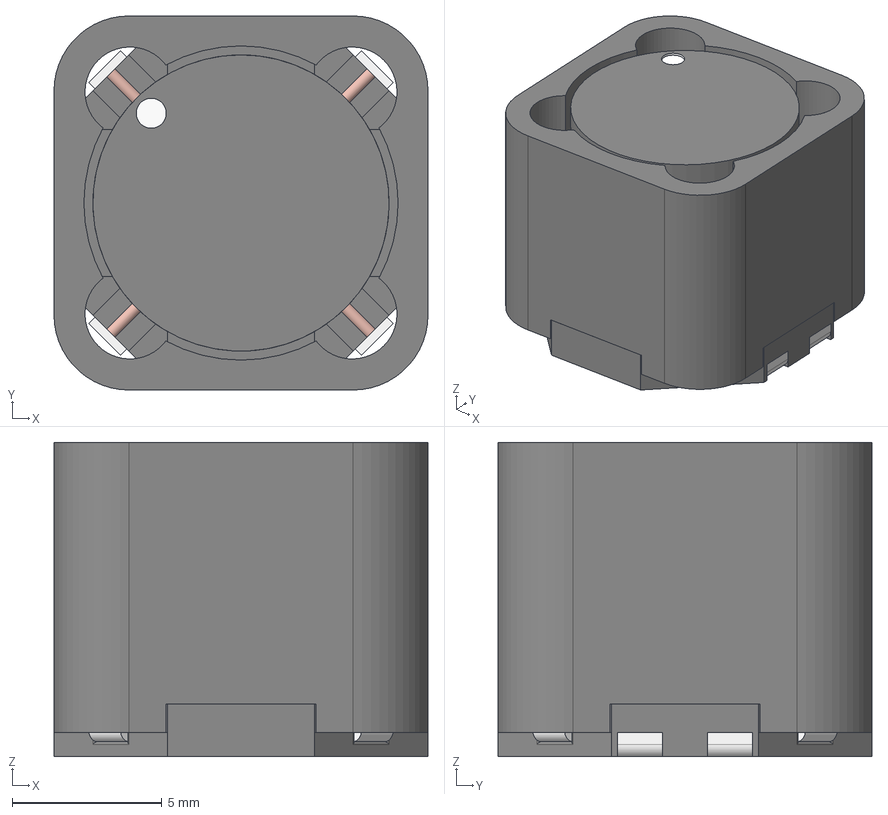
[picture p126: CAD file, 2025-05-07]
project_models/L_Wurth_WE-DD-1210crossed.step
12.5 x 12.5 x 10.5 mm
