ben5049/component-library/project_models/L_Wurth_WE-DD-7355crossed.step

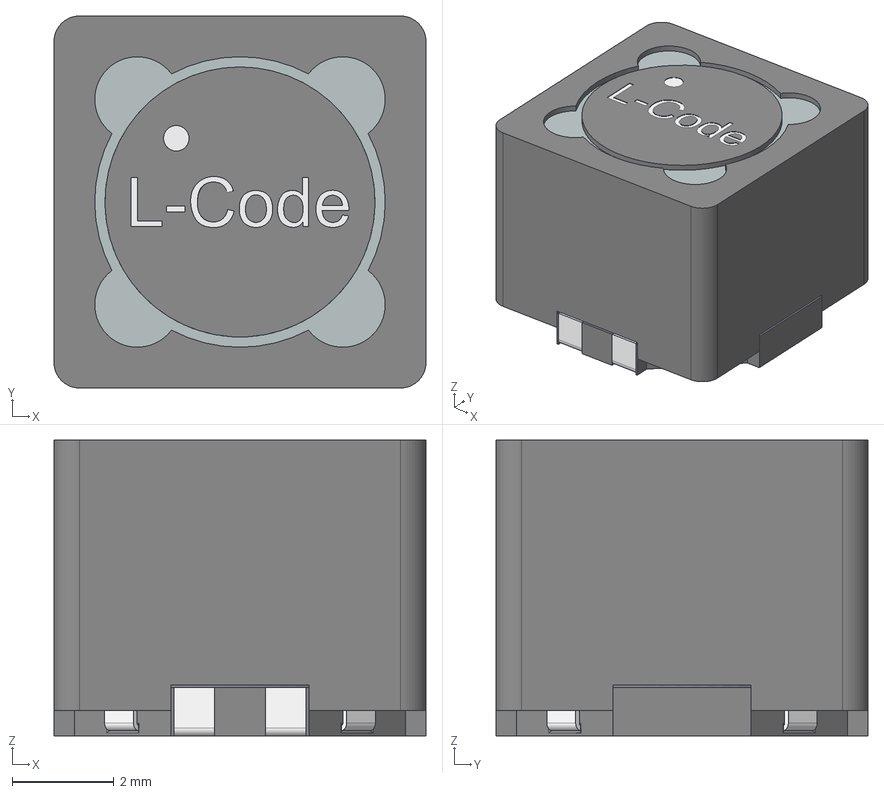
[picture p127: CAD file, 2025-05-07]
project_models/L_Wurth_WE-DD-7355crossed.step
7.30 x 7.30 x 5.80 mm
