ben5049/component-library/project_models/DMN62D1LFD.stp

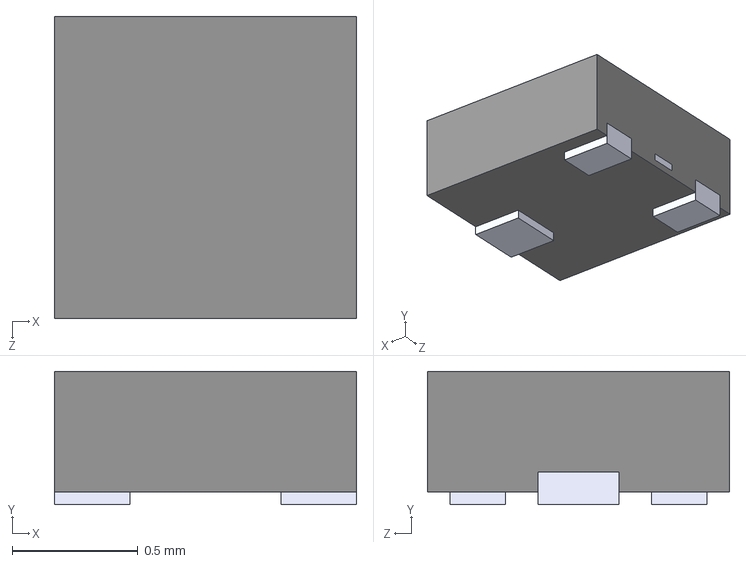
[picture p128: CAD file, 2025-05-07]
project_models/DMN62D1LFD.stp
1.20 x 0.53 x 1.20 mm
