ben5049/component-library/project_models/CD-MBL108S.stp

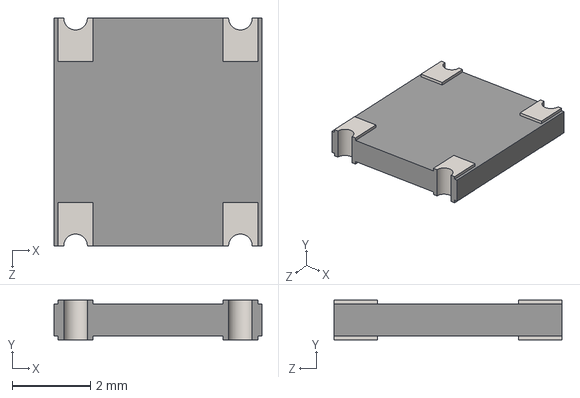
[picture p129: CAD file, 2025-05-07]
project_models/CD-MBL108S.stp
5.30 x 1.01 x 5.80 mm
