ben5049/component-library/project_models/IAUZ40N06S5L050ATMA1.stp

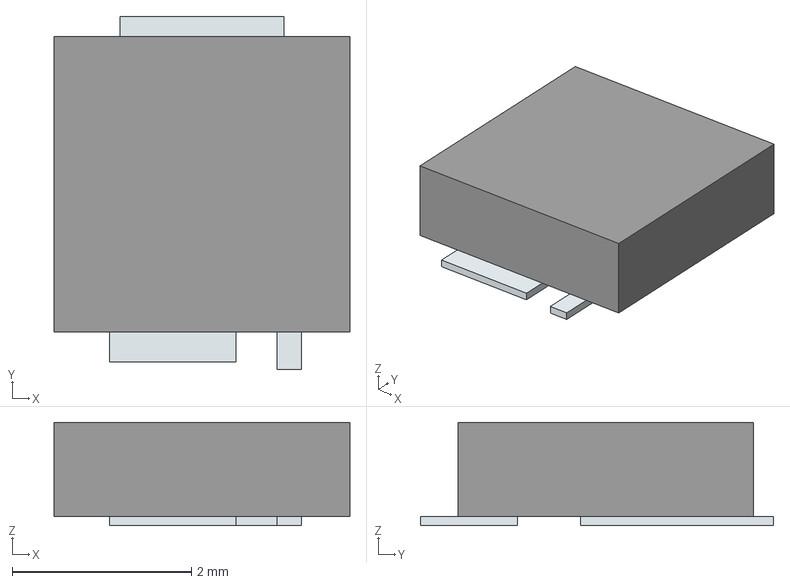
[picture p131: CAD file, 2025-05-05]
project_models/IAUZ40N06S5L050ATMA1.stp
3.30 x 3.94 x 1.15 mm
Pins
