ben5049/component-library/project_models/TXS0102DQER.stp

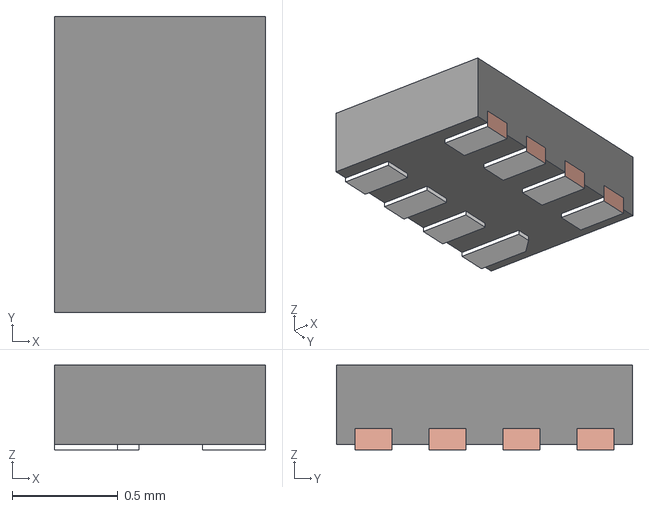
[picture p132: CAD file, 2025-05-05]
project_models/TXS0102DQER.stp
1.00 x 1.40 x 0.4 mm
BODY-SON1
FRAME-DQE0008A
