ben5049/component-library/project_models/TCPP03-M20.stp

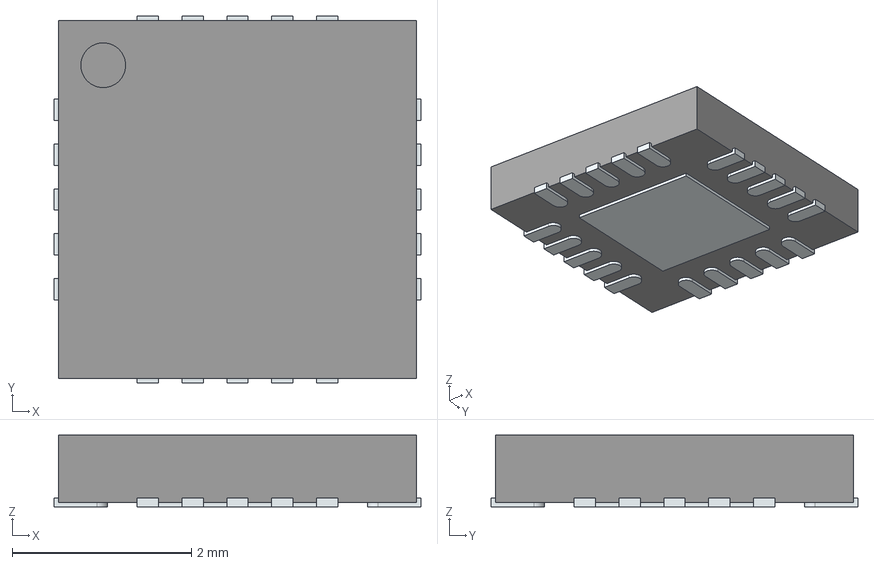
[picture p133: CAD file, 2025-05-05]
project_models/TCPP03-M20.stp
4.10 x 4.10 x 0.8 mm
ThermalPin
PinsArrayLR
PinsArrayTB
