ben5049/component-library/project_models/SJA1105QELY.stp

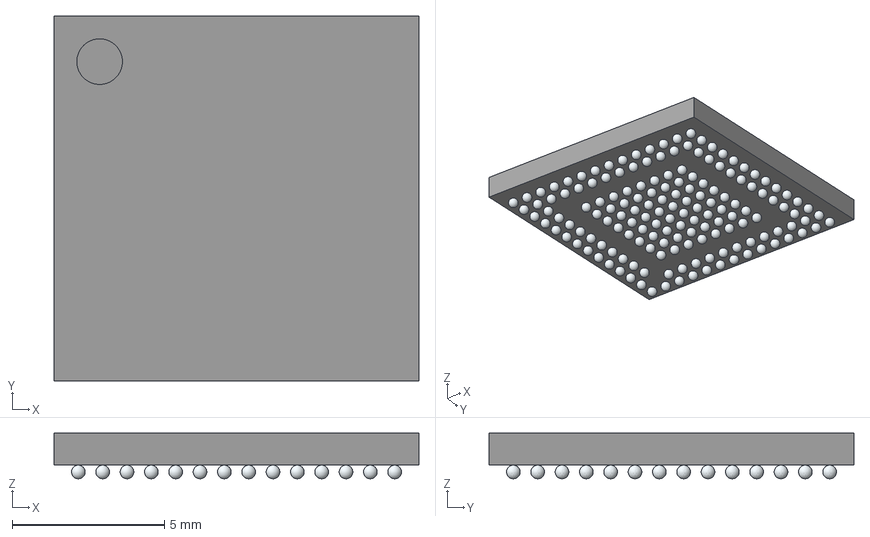
[picture p134: CAD file, 2025-05-05]
project_models/SJA1105QELY.stp
12.0 x 12.0 x 1.50 mm
A1
A2
A3
A4
A5
A6
A7
A8
A9
A10
A11
A12
A13
A14
B1
B3
B4
B5
B6
B7
B8
B9
B10
B11
B12
B13
B14
C1
C2
C13
C14
D1
D2
D4
D5
D6
D7
D8
D9
D10
D11
D13
D14
E1
E2
E4
E5
E6
E7
E8
E9
E10
E11
E13
E14
F1
F2
F4
F5
F6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
