ben5049/component-library/project_models/DMP21D0UFB-7B.stp

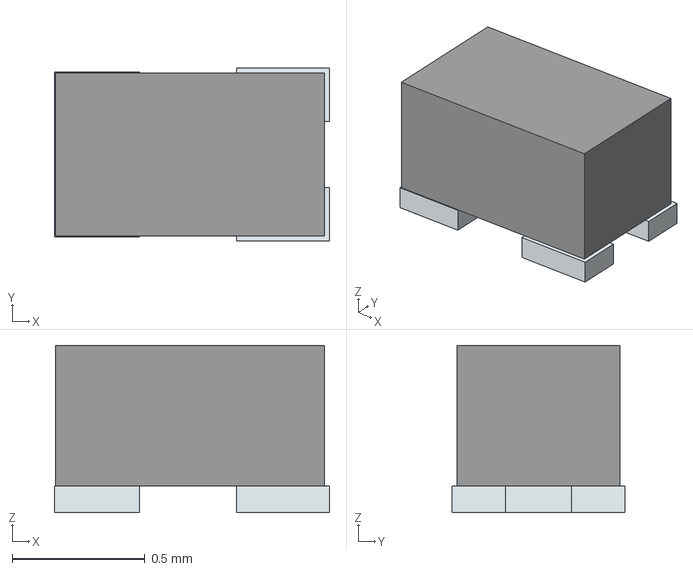
[picture p135: CAD file, 2025-05-05]
project_models/DMP21D0UFB-7B.stp
1.04 x 0.65 x 0.63 mm
Pins
