ben5049/component-library/project_models/ECS-.327-7-12QS-TR.STEP

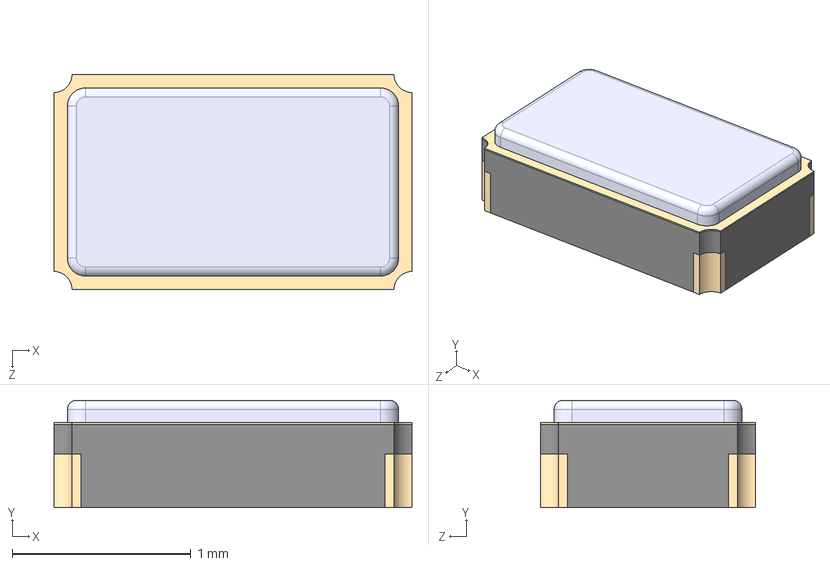
[picture p136: CAD file, 2025-05-05]
project_models/ECS-.327-7-12QS-TR.STEP
2.00 x 0.6 x 1.20 mm
