ben5049/component-library/(list of files, cad)

Other CAD files:
project_models/L_Wurth_WE-MAIA-4020HT.step
project_models/L_Wurth_WE-MAPI-6030.step
project_models/L_Wurth_WE-DD-1260straight.step
project_models/L_Wurth_WE-DD-1280straight.step
project_models/L_Wurth_WE-DD-7345crossed.step
project_models/TPS7B8133QDRVRQ1.stp
project_models/PCM12SMTR.stp
project_models/10106813-031112LF.stp
project_models/10132797-031100LF.stp
project_models/10132798-031100LF.stp
project_models/10164227-1001A1RLF.stp
project_models/10164227-1004a1rlf.stp
project_models/1548376.stp
project_models/43045-0201.stp
project_models/43045-0226.stp
project_models/43045-0401.stp
project_models/48406-0003.stp
project_models/503480-2600.stp
project_models/744787150.stp
project_models/74930000.stp
project_models/74930100.stp
project_models/74930xxx.stp
project_models/76825-0004.stp
project_models/784325078.stp
project_models/824012823.stp
project_models/9774005243.stp
project_models/9774010151R.stp
project_models/9774015243R.stp
project_models/9774025243R.stp
project_models/9774030151R.stp
project_models/ACPDQC5V0R-HF.STEP
project_models/AOTA-B201610S2R2MT.stp
project_models/AP22653FDZ-7.stp
project_models/AP74700QW6-7.stp
project_models/AXGD10402KR.stp
project_models/B74121G0050M060.stp
project_models/BQ25185DLHR.stp
project_models/BZX884.stp
project_models/DFE201612P-1R0M=P2.stp
project_models/DLW32MH101XT2L.stp
project_models/DMN21D2UFB-7B.stp
project_models/DMN3032LFDBQ-13.stp
project_models/DP83867CSRGZR.stp
project_models/DP83867IRRGZR.stp
project_models/DP83TG720RWRHATQ1.stp
project_models/Diodes_Incorporated_-_DMTH6016LPSQ-13.step
project_models/ECMF2-40A100N6.stp
project_models/EMMC32G-TS0A-01002.stp
project_models/ESD8708MUTAG.stp
project_models/FTSH-107-01-L-DV-K.stp
project_models/ISO1042DWVR.stp
project_models/ISO6521REUR.stp
project_models/IX61G2-A-10P.stp
project_models/LAN8671C2-E_U3B.stp
project_models/LMQ66410MC3RXBRQ1.stp
project_models/LMR34206SC5QRNXRQ1.step
project_models/LP87524JRNFRQ1.stp
project_models/LQ05041QCS6.stp
project_models/LQH2MPZ680MGRL.stp
project_models/LQH32NH3R3J23L.stp
project_models/LSF0204QZMJ12-7.stp
project_models/LT8692s.step
project_models/M24256X-FCU6T_VF.stp
project_models/MAX17626ATA+.stp
project_models/MAX17690ATE_V+.stp
project_models/MAX20004AFOC_VY+.stp
project_models/MAX20072ATAA_V+T.stp
project_models/MAX20075ATCC_V+.stp
project_models/MPQ5850GJ-AEC1-Z.stp
project_models/MSPE-J2L0-B00.STEP
project_models/MT53E1G32D2FW-046_WT_B.stp
project_models/MX25L51245GXDI-08G.stp
project_models/MX25UM51345GXDI00-TR.stp
project_models/NPS4053GH-Q100Z.stp
project_models/NX2016SA-40M-STD-CZS-3.STEP
project_models/NXB0104GU12X.stp
project_models/PCI11010C.step
project_models/PE-0805CCMC.stp
project_models/PESD2CANFD24V-TR.stp
project_models/PESD2CANFD27V-QCZ.stp
project_models/PESD4USB3BTTS-QX.stp
project_models/PJ-002AH.stp
project_models/PTSLR08056V110.stp
project_models/PUSB3TB6AZ.stp
project_models/RCLAMP3346PQTNT.stp
project_models/RTL8211FSI-VS-CG.stp
project_models/SRF7035A-301Y.stp
project_models/ST33KTPM2X32DKG9.stp
project_models/STM32H573IIK3Q.step
project_models/STM32MP257FAI3.stp
project_models/STPMIC25BPQR.stp
project_models/SZESD7241N2T5G.stp
project_models/T52M1107M035C0055.stp
project_models/THGBMJG6C1LBAU7.stp
project_models/TJA1055T_3_2Z.stp
project_models/TJA1462BTK_0Z.stp
project_models/TMJG46945AENL_Web.STEP
project_models/TPD4S012DRYR.stp
project_models/TPS16410DRCR.stp
project_models/TPS16416DRCR.stp
project_models/TPS2121RUXR.stp
project_models/TPS22966TDPURQ1.stp
project_models/TPS22991CNRAAR.stp
project_models/TPS259472ARPWR.stp
project_models/TPS272C45ARHFR.stp
project_models/TPS54061DRBR.stp
project_models/TPS62290TDRVRQ1.stp
project_models/TPS62824DMQR.stp
project_models/TS20-42-25-WT-160-SMT-TR-MSL.stp
project_models/TS20-42-25-WT-160-SMT-TR.stp
project_models/TVS2701DRBR.stp
project_models/TYPE-C-31-M-12.step
project_models/V1P6HM3_H.stp
project_models/VL53L8CXV0GC_1.stp
project_models/XRCGB25M000F3A16R0.STEP
project_models/YA917x.step
project_models/nRF52811-QCAA-R.stp
project_models/nRF52840-QFAA-F-R7.stp
project_models/srf4532-110y.stp
