ben5049/component-library/project_design_blocks/PoDL PD Detection.kicad_block/PoDL PD Detection.kicad_sch

## KiCad design project_design_blocks/PoDL PD Detection.kicad_block/PoDL PD Detection.kicad_sch (2025-05-19)

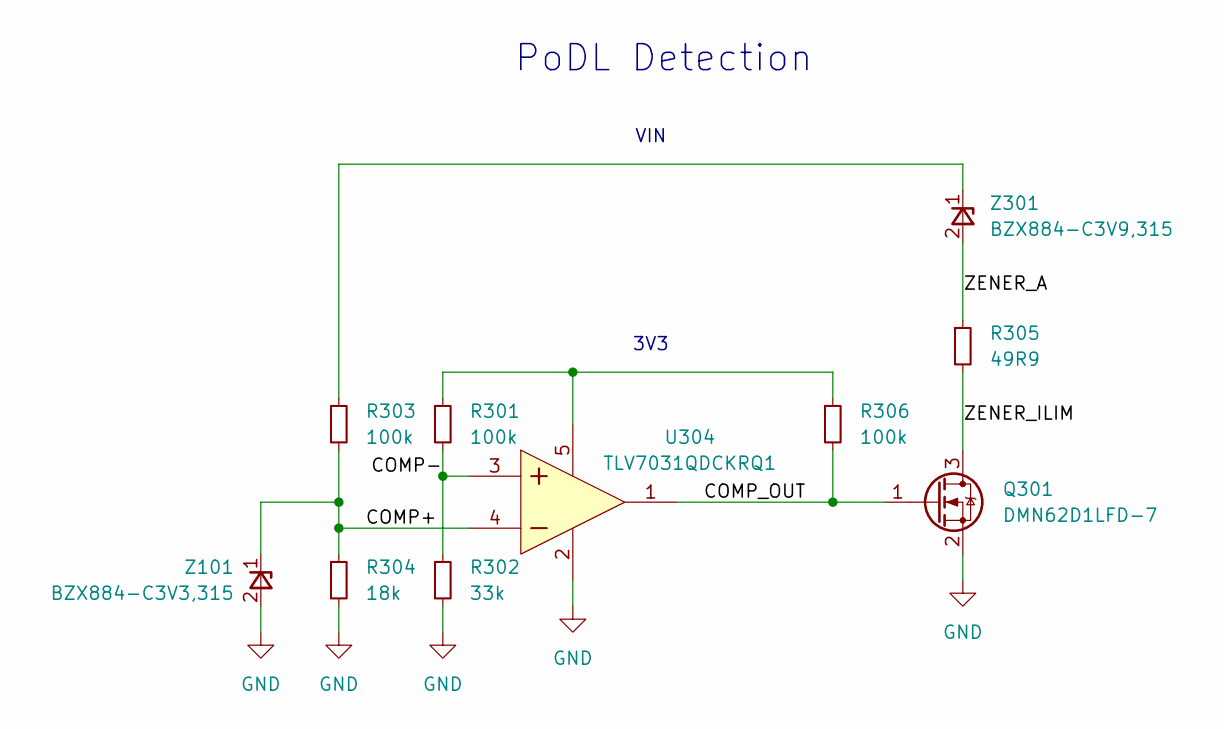
[picture p137: schematic PoDL PD Detection.kicad_sch]

Parts:
Q301: DMN62D1LFD-7; DMN62D1LFD; Mouser Part Number 621-DMN62D1LFD-7
R301, R303, R306: 100k; R_0402_1005Metric
R302: 33k; R_0402_1005Metric
R304: 18k; R_0402_1005Metric
R305: 49R9; R_0402_1005Metric
U304: TLV7031QDCKRQ1; SOT65P210X110-5N; Mouser Part Number 595-TLV7031QDCKRQ1
Z101: BZX884-C3V3,315; BZX884; Mouser Part Number 771-BZX884-C3V9315
Z301: BZX884-C3V9,315; BZX884; Mouser Part Number 771-BZX884-C3V9315

Connections:
COMP+: R303.2, R304.1, U304.4 (IN-), Z101.1 (K)
COMP-: R301.2, R302.1, U304.3 (IN+)
COMP_OUT: Q301.1 (G), R306.2, U304.1 (OUT)
GND: Q301.2 (S), R302.2, R304.2, U304.2 (VEE), Z101.2 (A)
unnamed: R301.1, R306.1, U304.5 (VCC)
unnamed: R303.1, Z301.1 (K)
ZENER_A: R305.1, Z301.2 (A)
ZENER_ILIM: Q301.3 (D), Q301.4 (D), R305.2

Notes on the sheet:
3V3
VIN
PoDL Detection
