ben5049/component-library/(commit log)

2025-05-05 Added proximity sensor components
    [1548376.stp, LAN8671C2-E_U3B.stp, LMQ66410MC3RXBRQ1.stp, VL53L8CXV0GC_1.stp]
2025-05-05 Added switch components
    [10106813-031112LF.stp, 10132797-031100LF.stp, 10132798-031100LF.stp, 10164227-1001A1RLF.stp, 10164227-1004a1rlf.stp, 43045-0201.stp, 503480-2600.stp, 74930000.stp]
2025-05-07 Added PoDL PD chips
    [DPW0005A.stp, TPS7B8133QDRVRQ1.stp]
2025-05-07 Added PoDL components
    [ACT1210E.stp, BZX884.stp, CD-MBL108S.stp, DMN62D1LFD.stp, L_Wurth_WE-DD-1210crossed.step, L_Wurth_WE-DD-1260crossed.step, L_Wurth_WE-DD-1260straight.step, L_Wurth_WE-DD-1280crossed.step]
2025-05-09 Added inductors
    [BM54F3.0-30DP-0.4V_51_.stp, L_Wurth_WE-MAPI-1610.step, L_Wurth_WE-MAPI-2010.step, L_Wurth_WE-MAPI-2506.step, L_Wurth_WE-MAPI-2508.step, L_Wurth_WE-MAPI-2510.step, L_Wurth_WE-MAPI-2512.step, L_Wurth_WE-MAPI-2512HT.step]
2025-05-19 Consolidated some libraries
    [PoDL PD Detection.kicad_sch]
2025-05-20 Added 10BASE-T1S PHY Module
    [ACT1210E.stp, WNCB-2200306.STEP]
2025-05-20 Added STM32H573RIV
2025-05-20 Added 3mm stand-offs
    [9774030151R.stp, STM32H573IIK3Q.stp]
2025-05-21 Added ST IMU library
    [ASM330LH.stp]
2025-05-21 Added MAX17626ATA
    [MAX17626ATA+.stp]
2025-05-21 Updated footprints
2025-05-21 Consolidated SPE connector libraries
    [MSPE-J2L0-E00-vertical.step]
2025-06-01 Changed second TPS2660 output pin to passive to prevent ERC error
2025-06-04 Added FRAM library
    [FM25LxB-DG.stp]
2025-06-06 Added TDK-TVS and WE-TVS libraries
    [824012823.stp]
2025-06-06 Added TPS2116DRLR and STM32L0 libraries
    [TPS2116DRLR.stp, UFQFPN20_3x3x0p6.step]
2025-06-07 Added UART and CAN to PHY module V2 symbol
2025-06-07 Added spring contact
    [S1791-42R.stp, S1791-42R_3mm.step]
2025-06-07 Moved power pads on phy_module_10_base_t1s_v1
2025-06-16 Consolidated libraries
    [TPS27S100ARRKR.stp, TS3DV20812RHHR.stp]
2025-06-18 Updated ETH-PHY symbols and some PWR-IND
    [ADL3225VT-4R7M-TL000.stp, MSD7342.step]
2025-06-18 Renamed WA-SMSI to STANDOFF
2025-06-20 Added 1000BASE-T1 CMC
    [ACT1210G-800-2P-TL10.stp]
2025-06-20 Added TPS272C45ARHFR
    [TPS272C45ARHFR.stp]
2025-06-24 Added STM32H503
2025-06-26 Changed SJA1105 pin directions
2025-06-28 Library consolidation
    [LMK1C1104DQFR.stp]
2025-06-29 Added a GDT
    [2038-15-SM-RPLF.stp]
2025-06-30 Added 88Q2112 Ethernet PHY
    [88Q2112.step, ADP5301ACBZ-4-R7.stp, MAX20072ATAA_V+T.stp, WDFN6_1P5X1P5_ONS.step]
2025-07-01 Created MOSFET, DIODE and PWR-SENSE libraries
    [NCS213RMUTAG.stp]
2025-07-01 Added more Wurth inductors
    [L_Wurth_WE-MAIA-1610.step, L_Wurth_WE-MAIA-2010.step, L_Wurth_WE-MAIA-2506.step, L_Wurth_WE-MAIA-2508.step, L_Wurth_WE-MAIA-2510.step, L_Wurth_WE-MAIA-2512.step, L_Wurth_WE-MAIA-2512HT.step, L_Wurth_WE-MAIA-3010.step]
2025-07-02 Tidied up footprints
2025-07-04 Fixed 74930100 footprint
    [74930100.stp]
2025-07-08 Updated MOSFET footprints
2025-07-11 Minor updates to symbols and footprints
2025-07-14 Changed pin to passive to prevent ERC warning
2025-07-15 Updated LMQ664x0 footprint
2025-08-07 Added solder paste grids to exposed pads
2025-09-20 Added TS3A5223RSWR
    [TS3A5223RSWR.stp]
2025-10-11 Added NX3L4051HRZ
    [NX3L4051HRZ.stp]
2025-10-14 Added TPS16410DRCR
    [TPS16410DRCR.stp]
2025-10-18 Added ecu-n6-v1 components
    [DFE201612P-1R0M=P2.stp, FH34SRJ-22S-0.5SH.stp, VFBGA198_10X10_STM.step]
2025-10-20 Added FH34SRJ-16S-0.5SH and TPS7A0518PYKAR
    [FH34SRJ-16S-0.5SH.stp, FH34SRJ-22S-0.5SH.stp, TPS7A0518PYKAR.stp]
2025-10-24 Updated FPC symbol pin types
2025-10-26 Changed STM32N6 PWR_ON pin to output
2025-10-29 Shrunk spring contact pads size
2025-10-29 Fixed 9774030151R solder paste
2025-10-30 Updated reference designators and added PHY-Module-1000BASE-T1-v1
    [phy_module_1000_base_t1_v1.step]
2025-10-30 New phy_module_1000_base_t1_v1 model
    [phy_module_1000_base_t1_v1.step]
2025-11-02 Updated phy_module_1000_base_t1_v1 model
    [phy_module_1000_base_t1_v1.step]
2025-11-08 Added radar components
    [ALP0180A.step, LP87524JRNFRQ1.stp]
2025-11-09 Added components for radar
    [MCKK2012TR47M.stp, MX25R1635FZUIH0.stp]
2025-11-09 Added ERR_OUT signal to radar connector
2025-11-09 Added more 1V0 power symbols
2025-11-13 Added WE PMFI inductors
    [L_Wurth_WE-PMFI-201610.step, L_Wurth_WE-PMFI-252012.step, L_Wurth_WE-PMFI-322512.step, L_Wurth_WE-PMFI-353220.step]
2025-11-15 Added ethernet PHY silkscreen
2025-11-16 Updated analog mux footprint
2025-11-17 Changed power connector footprint
2025-11-19 Added 2.5V LDO
    [DQN0004A.stp]
2025-12-01 Tidied up 1000BASE-T1 connector silkscreen
2025-12-13 Added components for JABR control board
    [LAN7431_YXX.stp, LAN8870.stp, MDT275E01001.stp, PI7C9X2G303ELBZXEX.stp, STM32H533CEU6.stp]
2025-12-14 Added PCIe switch
    [10164227-1001A1RLF.stp]
2025-12-14 Added switch_main_v5 model and footprint
2025-12-16 Added RF-CONN library and updated PWR libraries
    [CON-SMA-EDGE.stp, TPS259472ARPWR.stp, U.FL-R-SMT-K_895_.stp]
2025-12-17 Added circle to UFL connector footprint
2025-12-18 Added PI7C9X2G304SL
    [PI7C9X2G304SLBFDE.stp]
2025-12-29 Swapped I2C buses on PCIe switch
2025-12-31 Updated switch-v4 power connector footprint
2026-01-04 Added more spacers, M.2 connectors and added an oscillator library
    [9774015243R.stp, 9774025243R.stp, MDT320E0X001_c3d.stp, MDT580E0X002_c3d.stp, mdt420e0x001_c3d.stp]
2026-01-04 Changes for JABRJ control v1 PCB
    [48406-0003.stp, AP22653FDZ-7.stp, BM04B-SRSS-TB.STEP, FG-ST-C-24P-CL03-14.3.stp, NX3DV221TKX.stp, PCM12SMTBR.stp, USB1100-30-A.stp]
2026-01-12 Added parts for magnet board
    [43045-0226.stp, 744787150.stp, AP74700QW6-7.stp, DMN2005UFG-7.stp, INA381A2IDSGR.stp]
2026-01-13 Changed ST-IMU to IMU
    [DMN3021LFDF-7.stp]
2026-01-14 Pin type changes
2026-01-15 Removed irrelevant silkscreen
2026-01-16 Added FH12-22S-0.5SH footprint and model
    [FH12-22S-0.5SH.stp]
2026-01-17 Fixed STM32 hidden power pins
2026-01-26 Updated CM5 footprint
2026-02-08 Added Kailh Choc switches
    [2206-100T.step, kailh-choc-black.step, kailh-choc-socket.step, sk6812mini-e.step]
2026-02-10 Added SD-CONN
    [GSB12J21C1EU.step, MSD-1-A.stp, USB4510-03-1-A.stp]
2026-02-11 Added LED and MOTOR libraries
    [EMIF06-MSD02N16.stp]
2026-02-11 Added F31Z1A7H111008
    [F31Z_8pin.stp]
2026-02-13 Added MOTOR_DRIVER library
    [TMC6300-LA.stp, f31l_8pin_asm.stp]
2026-02-14 Added CHARGING and NRF libraries
    [BQ25185DLHR.stp, nRF52811-QCAA-R.stp]
2026-02-16 Added ENC library and NINA-B3 BLE modules
    [NCP380HMU05AATBG.stp, NINA-B302-00B.stp, NINA-B306-00B.stp, NORA-B106-00B.stp, nRF52840-QFAA-F-R7.stp]
2026-02-17 Added JST-PH 2-pin model
    [JST_PH_S2B-PH-K_1x02_P2.00mm_Horizontal.step]
2026-03-01 Moved and shrunk QFN50P400X400X100 pin 1 marker
2026-03-12 Added 0201 passive footprints
2026-03-14 Added JST-GH 5-pin horizontal connector
2026-03-15 Updated WE-MAPI-1610 footprint
2026-03-18 Fixed LMQ664x0 footprint
2026-03-18 Added R_0805 footprint
2026-03-31 Added JST XH2 SMD Horizontal
    [JST-XH2-SMD.step, JST-XH3-SMD.step, JST-XH4-SMD.step, JST-XH5-SMD.step, JST-XH6-SMD.step, JST-XH7-SMD.step]
2026-04-03 Added PCI11010C
    [MIC826MYMT-TR.stp, PCI11010C.step]
2026-04-03 Added COMM-BUF
    [LSF0108ZBA20-13.stp, TXS0108ERGYR.stp]
2026-04-05 Added WE-LHMI
    [AZV3001FZ4-7.stp, L_Wurth_WE-LHMI-1040.step, L_Wurth_WE-LHMI-1335.step, L_Wurth_WE-LHMI-1365.step, L_Wurth_WE-LHMI-4012.step, L_Wurth_WE-LHMI-4020.step, L_Wurth_WE-LHMI-4020HT.step, L_Wurth_WE-LHMI-5020.step]
2026-04-05 Added 784325078 inductor
    [784325078.stp]
2026-04-06 Added FFC3A2005G
    [AT24C64D-MAHM-E.stp, FFC3A20-05-G.stp, NX3DV221GM,115.stp]
2026-04-06 Added WE-MXGI
    [L_Wurth_WE-MXGI-4020.step, L_Wurth_WE-MXGI-5030.step]
2026-04-07 Added FH12-20S-0.5
    [FH12-20S-0.5SH_55_.stp]
2026-04-07 Aligned FPC mounting pad names
2026-04-08 Added new molex connector
    [43045-0401.stp]
2026-04-09 Add footprint and model for tmc2209
    [TMC2209.step]
2026-04-11 Changed M.2 E-key slot to be classed as an SMD component
2026-04-12 Added ADC library
    [ADS7128IRTER.stp]
2026-04-18 Added 9774005243R
    [9774005243.stp]
2026-05-04 Updated JST GH 2-pin vertical 3D model
2026-05-11 Added STM32N6 pin A1 marking
