ben5049/component-library/(notices)

Notices in the files:
project_models/JST_PH_S2B-PH-K_1x02_P2.00mm_Horizontal.step:
Copyright (C) 2017, Rene Poeschl
This work is licensed under the [Creative Commons CC-BY-SA 4.0 License](https://creativecommons.org/licenses/by-sa/4.0/legalcode),
with the following exception:
To the extent that the creation of electronic designs that use 'Licensed Material' can be considered to be 'Adapted Material',
You are free to use the library data in your own projects without the obligation to share your project files under this or any other license agreement.
project_models/L_Wurth_WE-MAIA-2512HT.step:
The information within the data (“Information”) has been provided to you free of charge for your use according to the terms of the
Creative Commons Attribution-ShareAlike 4.0 International Public License and remains the sole property of Würth Elektronik eiSos GmbH & Co. KG.
You are obliged to use the Information in accordance with the Creative Commons Attribution-ShareAlike 4.0 International Public License.
The following exception to the Creative Commons Attribution-ShareAlike 4.0 International Public License applies to your use of the Information:
To the extent that the creation of electronic designs that use 'Licensed Material' can be considered to be 'Adapted Material', then the copyright holder waives article 3 of
the license with respect to these designs and any generated files which use data provided as part of the 'Licensed Material'. You are free to use the library data in your
own projects without the obligation to share your project files under this or any other license agreement. However, if you wish to redistribute these libraries, or parts
